Brik81/SYMPHONY_BRIDGE/SYMPHONY_V2/DESIGN/SYMPHONY_V2/report/entries/044_backup-alimentazione-scheda-requisito.tex

\clearpage
\section{Backup alimentazione scheda: requisito e soluzione proposta}

\noindent\textbf{Data:} 10/11/2026 \quad \textbf{Revisione:} non indicata \quad \textbf{Stato:} decisione di Brik81, nessuna modifica hardware eseguita; soluzione \emph{proposta, non ancora approvata}.

\subsection{Componenti, net e fogli coinvolti}
\begin{itemize}[nosep]
  \item Pacco backup esistente: \code{D401} (BAT54WS), \code{R412}, \code{C415}--\code{C424} (CPH3225A), net \code{RTC\_VBAT}, \code{U404} (DS3231MZ, pin 6 VBAT); foglio \code{MCU.kicad\_sch}.
  \item \code{U301} STM32L562, pin 1 VBAT (oggi sul \code{3V3} diretto); \code{U401} FM25V10 (FRAM).
  \item Alimentazione: \code{IC4} TPS2121 (pin SS con \code{C4}, ILIM con \code{R44}), net \code{5V0}, \code{IC3} TPSM863257 (buck \code{3V3}).
  \item Carichi da spegnere al power-fail: \code{IC2} QPA9510 (via \code{Q701}/APC) e radio Si4464.
\end{itemize}

\subsection{Cosa \`e cambiato}
Nessuna modifica eseguita. Stato verificato da netlist il 10/11/2026 e modifiche proposte.

\begin{center}
\begin{tabularx}{\linewidth}{@{}lXX@{}}
\toprule
Voce & Stato attuale & Proposta (non approvata) \\
\midrule
Percorso backup & \code{3V3} $\to$ \code{D401} $\to$ \code{R412} (\SI{1}{\kilo\ohm}) $\to$ \code{RTC\_VBAT} $\to$ \code{C415}--\code{C424} $\to$ solo \code{U404.6} & Pacco CPH3225A mantenuto solo per RTC \\
Pacco CPH3225A & 10 $\times$ \SI{11}{\milli\farad}, \SI{3.3}{\volt}; totale \SI{110}{\milli\farad}, ESR $\approx \SI{16}{\ohm}$ (\SI{160}{\ohm} ciascuno) & invariato \\
Autonomia RTC & \SIrange{4.9}{12.4}{\hour} (calcolata) & invariata \\
Bulk su \code{5V0} & assente & \SIrange{2.2}{3.3}{\milli\farad} elettrolitico/polimerico \SI{10}{\volt}, oppure supercap \SI{0.1}{\farad} \SI{5.5}{\volt} low-ESR per margine \\
Segnale power-fail verso MCU & assente & partitore da \code{5V0} (es. \SI{100}{\kilo\ohm}/\SI{39}{\kilo\ohm}, soglia $\approx \SI{4.3}{\volt}$ con VREFINT \SI{1.2}{\volt}) su ingresso COMP o EXTI di \code{U301}; pin da scegliere \\
Inrush bulk & \code{C4} (SS di \code{IC4}), \code{R44} \SI{33}{\kilo\ohm} (ILIM) & rivedere \code{C4} (formula da datasheet TPS2121) \\
\code{U301} VBAT & \code{3V3} diretto & facoltativo: su \code{RTC\_VBAT} \\
Firmware & --- & all'interrupt: spegnere PA e Si4464, salvare lo stato su FRAM \code{U401} \\
\bottomrule
\end{tabularx}
\end{center}

\subsubsection*{Budget energetico proposto}
Carico durante il salvataggio $\le \SI{50}{\milli\ampere}$ a \SI{3.3}{\volt} ($\approx \SI{0.2}{\watt}$ da \code{5V0}); durata \SI{20}{\milli\second} con margine $\times 3$, quindi \SI{12}{\milli\joule}. Il buck mantiene \code{3V3} finch\'e \code{5V0} $> \SI{3.6}{\volt}$:
\[
E=\tfrac12 C\,(4{,}75^2-3{,}6^2)\approx 4{,}8\,C \;\Rightarrow\; C \ge \SI{2.5}{\milli\farad}.
\]
Il pacco attuale non pu\`o alimentare la scheda: con ESR $\approx \SI{16}{\ohm}$ a \SI{50}{\milli\ampere} cade \SI{0.8}{\volt} e l'energia utile \`e $\approx \SI{0.25}{\joule}$.

\begin{center}
\begin{tikzpicture}[node distance=9mm and 11mm,>=Stealth,
  blk/.style={draw=accent,rounded corners=2pt,align=center,minimum height=8mm,font=\small\sffamily,fill=accent!6}]
  \node[blk] (in) {TPS2121\\ \code{IC4}};
  \node[blk,right=of in] (bus) {Net \code{5V0}\\ + bulk (proposto)};
  \node[blk,right=of bus] (buck) {TPSM863257\\ \code{IC3}};
  \node[blk,right=of buck] (mcu) {\code{3V3}\\ \code{U301},\code{U401}};
  \node[blk,below=of bus,fill=boxwarnbg,draw=boxwarn] (pf) {Partitore\\ power-fail};
  \draw[->] (in)--(bus); \draw[->] (bus)--(buck); \draw[->] (buck)--(mcu);
  \draw[->] (bus)--(pf); \draw[->] (pf)-|(mcu) node[pos=.25,above,font=\scriptsize]{COMP/EXTI};
\end{tikzpicture}
\end{center}

\subsection{Motivazione}
Requisito di Brik81: ``io voglio che alimenti tutta la scheda'' e poi ``la scheda non deve trasmettere se va a saupercap deve salvare lo stato in memoria e basta quidni autonomia poca e non deve trasmettere''.

Approvazione della soluzione proposta: non ancora data.

\subsection{Impatti e criticit\`a}
\begin{critbox}
\textbf{Criticit\`a aperte.}
\begin{itemize}[nosep]
  \item Valori finali del bulk e del partitore non definiti; codici JLCPCB/Mouser non scelti.
  \item Pin COMP/EXTI di \code{U301} da scegliere.
  \item Dropout del TPSM863257 da verificare.
  \item Approvazione di Brik81 sulla soluzione mancante.
\end{itemize}
\end{critbox}
\begin{notebox}
Oggi non esiste alcun segnale power-fail verso l'MCU. Il bulk su \code{5V0} aumenta la corrente di carica all'accensione (inrush): impatto su \code{C4} e ILIM \code{R44}.
\end{notebox}

\subsection{Verifiche da fare}
\begin{itemize}[nosep]
  \item Confermare con Brik81 la soluzione proposta e i valori finali.
  \item Scegliere il pin COMP/EXTI libero di \code{U301}.
  \item Verificare il dropout di \code{IC3} (TPSM863257) sotto \SI{3.6}{\volt} su \code{5V0}.
  \item Rivedere \code{C4} (SS di \code{IC4}) per limitare l'inrush, con \code{R44} \SI{33}{\kilo\ohm}.
  \item Scegliere i codici componente (JLCPCB/Mouser).
  \item Definire la sequenza firmware di salvataggio su \code{U401}.
\end{itemize}
