Brik81/SYMPHONY_BRIDGE/SYMPHONY_V2/DESIGN/SYMPHONY_V2/docs/layout_rf/piazzamento_uhf/tab_mcu_rot.tex

\rowcolor{sbgraybg}\ang{0} (oggi) & 432 & 56 & posizione attuale nel PCB\\
\ang{45} & 423 & 42 & \\
\ang{90} & 385 & 22 & \\
\ang{135} & 338 & 5 & \textcolor{sbgreen}{\textbf{meno incroci}}\\
\ang{180} & 314 & 9 & \textcolor{sborange}{\textbf{più corta}}\\
\ang{225} & 326 & 8 & \\
\ang{270} & 366 & 8 & \\
\ang{315} & 409 & 24 & \\
