Brik81/SYMPHONY_BRIDGE/SYMPHONY_V2/DESIGN/SYMPHONY_V2/docs/layout_rf/piazzamento_uhf/blk_alim_pa2.tex

\begin{tikzpicture}[x=6.50mm,y=6.50mm,font=\sffamily\tiny]
\node[lbl,anchor=east,text=sbgray] at (-0.150,0.000) {3V3};
\draw[tr,line width=2.080mm] (0.000,0.000) -- (1.200,0.000);
\fill[cu] (1.200,-0.475) rectangle (2.050,0.475);
\fill[cu] (2.800,-0.475) rectangle (3.650,0.475);
\draw[bod] (0.825,-0.400) rectangle (3.225,0.400);
\node[lbl,anchor=south,text=black] at (2.425,0.625) {\textbf{R241}\\0};
\draw[tr,line width=2.080mm] (3.650,0.000) -- (4.350,0.000);
\fill[cu] (4.350,-0.275) rectangle (4.950,0.275);
\fill[cu] (4.350,-1.275) rectangle (4.950,-0.725);
\draw[bod] (4.400,-1.000) rectangle (4.900,0.000);
\draw[via] (4.320,-1.655) circle (0.3); \fill[black!70] (4.320,-1.655) circle (0.13);
\draw[via] (4.980,-1.655) circle (0.3); \fill[black!70] (4.980,-1.655) circle (0.13);
\node[lbl,anchor=west,text=black] at (5.070,-0.700) {\textbf{C248} 330p};
\draw[tr,line width=2.080mm] (4.150,0.000) -- (6.600,0.000);
\draw[tr,line width=2.080mm] (6.600,0.000) -- (7.300,0.000);
\fill[cu] (7.300,-0.300) rectangle (7.850,0.300);
\fill[cu] (8.300,-0.300) rectangle (8.850,0.300);
\draw[bod] (7.075,-0.250) rectangle (8.575,0.250);
\node[lbl,anchor=south,text=black] at (8.075,0.450) {\textbf{L241}\\6.8n};
\draw[tr,line width=2.080mm] (8.850,0.000) -- (9.550,0.000);
\node[lbl,anchor=west,text=sbgray] at (9.700,0.000) {VCC2 del PA (pin 5--7)};

\end{tikzpicture}
