Brik81/SYMPHONY_BRIDGE/SYMPHONY_V2/DESIGN/SYMPHONY_V2/docs/layout_rf/piazzamento_uhf/blk_an643.tex

\begin{tikzpicture}[x=6.50mm,y=6.50mm,font=\sffamily\tiny]
\node[lbl,anchor=east,text=sbgray] at (-0.150,0.000) {da C218 (nodo RX\_MATCH)};
\draw[tr,line width=2.080mm] (0.000,0.000) -- (1.200,0.000);
\draw[tr,line width=2.080mm] (1.200,0.000) -- (1.200,1.600);
\draw[tr,line width=2.080mm] (1.200,0.000) -- (1.200,-1.600);
\draw[tr,line width=2.080mm] (1.200,1.600) -- (1.800,1.600);
\fill[cu] (1.800,1.125) rectangle (2.650,2.075);
\fill[cu] (3.400,1.125) rectangle (4.250,2.075);
\draw[bod] (2.225,1.200) rectangle (3.825,2.000);
\node[lbl,anchor=south,text=black] at (3.025,2.175) {\textbf{C219} 2.2p};
\draw[tr,line width=2.080mm] (4.250,1.600) -- (8.600,1.600);
\draw[tr,line width=2.080mm] (1.200,-1.600) -- (1.800,-1.600);
\fill[cu] (1.800,-2.075) rectangle (2.650,-1.125);
\fill[cu] (3.400,-2.075) rectangle (4.250,-1.125);
\draw[bod] (2.225,-2.000) rectangle (3.825,-1.200);
\node[lbl,anchor=north,text=black] at (3.025,-2.175) {\textbf{L205} 56n};
\draw[tr,line width=2.080mm] (4.250,-1.600) -- (8.600,-1.600);
\fill[cu] (4.525,1.175) rectangle (5.475,2.025);
\fill[cu] (4.525,-2.025) rectangle (5.475,-1.175);
\draw[bod] (4.600,-1.700) rectangle (5.400,1.700);
\node[lbl,anchor=west,text=black] at (5.575,0.400) {\textbf{L206} 62n};
\fill[cu] (6.300,-2.125) rectangle (7.700,-1.075);
\fill[cu] (6.300,-4.025) rectangle (7.700,-2.975);
\draw[bod] (6.375,-3.550) rectangle (7.625,-1.550);
\draw[via] (6.670,-4.405) circle (0.3); \fill[black!70] (6.670,-4.405) circle (0.13);
\draw[via] (7.330,-4.405) circle (0.3); \fill[black!70] (7.330,-4.405) circle (0.13);
\node[lbl,anchor=east,text=black] at (6.200,-2.550) {\textbf{C220} 4.7p};
\draw[bod,fill=black!5] (8.6,-2.6) rectangle (11.2,2.6);
\fill[cu] (8.600,1.460) rectangle (9.100,1.740);
\fill[cu] (8.600,-1.740) rectangle (9.100,-1.460);
\node[lbl,anchor=south,text=black] at (9.900,2.650) {\textbf{IC204 Si4464}};
\node[lbl,anchor=west,text=black] at (9.150,1.600) {RXP (2)};
\node[lbl,anchor=west,text=black] at (9.150,-1.600) {RXN (3)};

\end{tikzpicture}
