Brik81/SYMPHONY_BRIDGE/SYMPHONY_V2/DESIGN/SYMPHONY_V2/docs/layout_rf/piazzamento_uhf/blk_antenna.tex

\begin{tikzpicture}[x=6.50mm,y=6.50mm,font=\sffamily\tiny]
\node[lbl,anchor=east,text=sbgray] at (-0.150,0.000) {J201 (pin centrale)};
\draw[tr,line width=2.080mm] (0.000,0.000) -- (2.000,0.000);
\fill[cu] (2.000,-0.475) rectangle (2.850,0.475);
\fill[cu] (3.600,-0.475) rectangle (4.450,0.475);
\draw[bod] (1.625,-0.400) rectangle (4.025,0.400);
\node[lbl,anchor=south,text=black] at (3.225,0.625) {\textbf{C206}\\100p};
\draw[tr,line width=2.080mm] (4.450,0.000) -- (5.150,0.000);
\draw[bod,fill=black!5] (5.150,-1.500) rectangle (8.150,1.500);
\fill[cu] (5.150,-0.140) rectangle (5.650,0.140);
\fill[sborange!45] (5.975,-0.675) rectangle (7.325,0.675);
\draw[via] (6.313,-0.338) circle (0.3); \fill[black!70] (6.313,-0.338) circle (0.13);
\draw[via] (6.313,0.338) circle (0.3); \fill[black!70] (6.313,0.338) circle (0.13);
\draw[via] (6.988,-0.338) circle (0.3); \fill[black!70] (6.988,-0.338) circle (0.13);
\draw[via] (6.988,0.338) circle (0.3); \fill[black!70] (6.988,0.338) circle (0.13);
\node[lbl,anchor=south,text=black] at (6.650,1.650) {\textbf{IC202 switch (porta RFC)}};
\draw[tr,line width=2.080mm] (8.150,0.000) -- (8.850,0.000);

\end{tikzpicture}
