Brik81/SYMPHONY_BRIDGE/SYMPHONY_V2/DESIGN/SYMPHONY_V2/docs/layout_rf/piazzamento_uhf/blk_attenuatore.tex

\begin{tikzpicture}[x=6.50mm,y=6.50mm,font=\sffamily\tiny]
\node[lbl,anchor=east,text=sbgray] at (-0.150,0.000) {da C701 (rete AN648)};
\draw[tr,line width=2.080mm] (0.000,0.000) -- (1.200,0.000);
\fill[cu] (1.200,-0.425) rectangle (2.150,0.425);
\fill[cu] (1.200,-2.025) rectangle (2.150,-1.175);
\draw[bod] (1.275,-1.600) rectangle (2.075,0.000);
\draw[via] (1.345,-2.405) circle (0.3); \fill[black!70] (1.345,-2.405) circle (0.13);
\draw[via] (2.005,-2.405) circle (0.3); \fill[black!70] (2.005,-2.405) circle (0.13);
\node[lbl,anchor=west,text=black] at (2.270,-1.000) {\textbf{R245} 100};
\draw[tr,line width=2.080mm] (1.000,0.000) -- (3.800,0.000);
\draw[tr,line width=2.080mm] (3.800,0.000) -- (4.500,0.000);
\fill[cu] (4.500,-0.475) rectangle (5.350,0.475);
\fill[cu] (6.100,-0.475) rectangle (6.950,0.475);
\draw[bod] (4.125,-0.400) rectangle (6.525,0.400);
\node[lbl,anchor=south,text=black] at (5.725,0.625) {\textbf{R246}\\68};
\draw[tr,line width=2.080mm] (6.950,0.000) -- (7.650,0.000);
\fill[cu] (7.650,-0.275) rectangle (8.250,0.275);
\fill[cu] (7.650,-1.275) rectangle (8.250,-0.725);
\draw[bod] (7.700,-1.000) rectangle (8.200,0.000);
\draw[via] (7.620,-1.655) circle (0.3); \fill[black!70] (7.620,-1.655) circle (0.13);
\draw[via] (8.280,-1.655) circle (0.3); \fill[black!70] (8.280,-1.655) circle (0.13);
\node[lbl,anchor=west,text=black] at (8.370,-0.700) {\textbf{R247} 100};
\fill[cu] (10.400,-0.275) rectangle (11.000,0.275);
\fill[cu] (10.400,0.725) rectangle (11.000,1.275);
\draw[bod] (10.450,0.000) rectangle (10.950,1.000);
\draw[via] (10.370,1.655) circle (0.3); \fill[black!70] (10.370,1.655) circle (0.13);
\draw[via] (11.030,1.655) circle (0.3); \fill[black!70] (11.030,1.655) circle (0.13);
\node[lbl,anchor=west,text=black] at (11.120,0.700) {\textbf{R248} 180};
\draw[tr,line width=2.080mm] (7.450,0.000) -- (12.650,0.000);
\draw[tr,line width=2.080mm] (12.650,0.000) -- (13.350,0.000);
\fill[cu] (13.350,-0.475) rectangle (14.200,0.475);
\fill[cu] (14.950,-0.475) rectangle (15.800,0.475);
\draw[bod] (12.975,-0.400) rectangle (15.375,0.400);
\node[lbl,anchor=south,text=black] at (14.575,0.625) {\textbf{C255}\\56p};
\draw[tr,line width=2.080mm] (15.800,0.000) -- (16.500,0.000);
\node[lbl,anchor=west,text=sbgray] at (16.650,0.000) {RF IN del PA (pin 3)};

\end{tikzpicture}
