Brik81/SYMPHONY_BRIDGE/SYMPHONY_V2/DESIGN/SYMPHONY_V2/docs/layout_rf/piazzamento_uhf/blk_es_ind_no.tex

\begin{tikzpicture}[x=6.50mm,y=6.50mm,font=\sffamily\tiny]
\useasboundingbox (-1.8,-4.3) rectangle (9.5,1.4);
\draw[tr,line width=2.080mm] (0.000,0.000) -- (1.400,0.000);
\fill[cu] (1.400,-0.475) rectangle (2.250,0.475);
\fill[cu] (3.000,-0.475) rectangle (3.850,0.475);
\draw[bod] (1.825,-0.400) rectangle (3.425,0.400);
\draw[sbgray,->] (1.6,0.9) -- (3.4,0.9);
\draw[tr,line width=2.080mm] (3.850,0.000) -- (4.450,0.000);
\fill[cu] (4.450,-0.475) rectangle (5.300,0.475);
\fill[cu] (6.050,-0.475) rectangle (6.900,0.475);
\draw[bod] (4.875,-0.400) rectangle (6.475,0.400);
\draw[sbgray,->] (4.65,0.9) -- (6.45,0.9);
\draw[tr,line width=2.080mm] (6.900,0.000) -- (8.000,0.000);
\node[lbl,anchor=north,text=sbred] at (4.000,-0.900) {in fila e vicine: i campi si sommano};
\node[font=\sffamily\scriptsize\bfseries,text=sbred,anchor=north west] at (-1.8,1.4) {\ding{55} sbagliato};

\end{tikzpicture}
