Brik81/SYMPHONY_BRIDGE/SYMPHONY_V2/DESIGN/SYMPHONY_V2/docs/layout_rf/piazzamento_uhf/blk_es_ind_si.tex

\begin{tikzpicture}[x=6.50mm,y=6.50mm,font=\sffamily\tiny]
\useasboundingbox (-1.8,-4.3) rectangle (9.5,1.4);
\draw[tr,line width=2.080mm] (0.000,0.000) -- (1.400,0.000);
\fill[cu] (1.400,-0.475) rectangle (2.250,0.475);
\fill[cu] (3.000,-0.475) rectangle (3.850,0.475);
\draw[bod] (1.825,-0.400) rectangle (3.425,0.400);
\draw[sbgray,->] (1.6,0.9) -- (3.4,0.9);
\draw[tr,line width=2.080mm] (3.850,0.000) -- (5.050,0.000);
\draw[tr,line width=2.080mm] (5.050,0.000) -- (5.050,-0.600);
\fill[cu] (4.575,-1.450) rectangle (5.525,-0.600);
\fill[cu] (4.575,-3.050) rectangle (5.525,-2.200);
\draw[bod] (4.650,-2.625) rectangle (5.450,-1.025);
\draw[sbgray,->] (5.85,-0.5) -- (5.85,-2.3);
\draw[tr,line width=2.080mm] (5.050,-3.050) -- (5.050,-3.600);
\node[lbl,anchor=west,text=sbgreen] at (6.150,-1.400) {girata di 90 gradi:\\i campi non si sommano};
\node[font=\sffamily\scriptsize\bfseries,text=sbgreen,anchor=north west] at (-1.8,1.4) {\ding{51} giusto};

\end{tikzpicture}
