Brik81/SYMPHONY_BRIDGE/SYMPHONY_V2/DESIGN/SYMPHONY_V2/docs/layout_rf/piazzamento_uhf/blk_es_stub_no.tex

\begin{tikzpicture}[x=6.50mm,y=6.50mm,font=\sffamily\tiny]
\useasboundingbox (-1.8,-4.3) rectangle (9.5,1.4);
\draw[tr,line width=2.080mm] (0.000,0.000) -- (6.000,0.000);
\draw[tr,line width=1.625mm] (3.000,0.000) -- (3.000,-1.600);
\fill[cu] (2.700,-2.150) rectangle (3.300,-1.600);
\fill[cu] (2.700,-3.150) rectangle (3.300,-2.600);
\draw[bod] (2.750,-3.075) rectangle (3.250,-1.675);
\draw[via] (3.000,-3.530) circle (0.3); \fill[black!70] (3.000,-3.530) circle (0.13);
\node[lbl,anchor=west,text=sbred] at (3.400,-0.800) {stub};
\node[font=\sffamily\scriptsize\bfseries,text=sbred,anchor=north west] at (-1.8,1.4) {\ding{55} sbagliato};

\end{tikzpicture}
