Brik81/SYMPHONY_BRIDGE/SYMPHONY_V2/DESIGN/SYMPHONY_V2/docs/layout_rf/piazzamento_uhf/blk_es_stub_si.tex

\begin{tikzpicture}[x=6.50mm,y=6.50mm,font=\sffamily\tiny]
\useasboundingbox (-1.8,-4.3) rectangle (9.5,1.4);
\draw[tr,line width=2.080mm] (0.000,0.000) -- (6.000,0.000);
\fill[cu] (2.700,-0.275) rectangle (3.300,0.275);
\fill[cu] (2.700,-1.275) rectangle (3.300,-0.725);
\draw[bod] (2.750,-1.200) rectangle (3.250,0.200);
\draw[via] (2.670,-1.655) circle (0.3); \fill[black!70] (2.670,-1.655) circle (0.13);
\draw[via] (3.330,-1.655) circle (0.3); \fill[black!70] (3.330,-1.655) circle (0.13);
\node[lbl,anchor=west,text=sbgreen] at (3.500,-0.500) {pad sulla pista};
\node[font=\sffamily\scriptsize\bfseries,text=sbgreen,anchor=north west] at (-1.8,1.4) {\ding{51} giusto};

\end{tikzpicture}
