Brik81/SYMPHONY_BRIDGE/SYMPHONY_V2/DESIGN/SYMPHONY_V2/docs/layout_rf/piazzamento_uhf/blk_es_via_no.tex

\begin{tikzpicture}[x=6.50mm,y=6.50mm,font=\sffamily\tiny]
\useasboundingbox (-1.8,-4.3) rectangle (9.5,1.4);
\draw[tr,line width=2.080mm] (0.000,0.000) -- (6.000,0.000);
\fill[cu] (2.700,-0.275) rectangle (3.300,0.275);
\fill[cu] (2.700,-1.275) rectangle (3.300,-0.725);
\draw[bod] (2.750,-1.200) rectangle (3.250,0.200);
\draw[tr,line width=1.300mm] (3.000,-1.000) -- (3.000,-3.200);
\draw[via] (3.000,-3.500) circle (0.3); \fill[black!70] (3.000,-3.500) circle (0.13);
\node[lbl,anchor=west,text=sbred] at (3.400,-2.400) {via lontana};
\node[font=\sffamily\scriptsize\bfseries,text=sbred,anchor=north west] at (-1.8,1.4) {\ding{55} sbagliato};

\end{tikzpicture}
