Brik81/SYMPHONY_BRIDGE/SYMPHONY_V2/DESIGN/SYMPHONY_V2/docs/layout_rf/piazzamento_uhf/blk_filtro_rx.tex

\begin{tikzpicture}[x=6.50mm,y=6.50mm,font=\sffamily\tiny]
\node[lbl,anchor=east,text=sbgray] at (-0.150,0.000) {RF1 dello switch};
\draw[tr,line width=2.080mm] (0.000,0.000) -- (1.400,0.000);
\fill[cu] (1.400,-0.475) rectangle (2.250,0.475);
\fill[cu] (3.000,-0.475) rectangle (3.850,0.475);
\draw[bod] (1.025,-0.400) rectangle (3.425,0.400);
\node[lbl,anchor=south,text=black] at (2.625,0.625) {\textbf{C207}\\100p};
\draw[tr,line width=2.080mm] (3.850,0.000) -- (4.550,0.000);
\fill[cu] (4.550,-0.525) rectangle (5.950,0.525);
\fill[cu] (4.550,-2.425) rectangle (5.950,-1.375);
\draw[bod] (4.625,-1.950) rectangle (5.875,0.050);
\draw[via] (4.920,-2.805) circle (0.3); \fill[black!70] (4.920,-2.805) circle (0.13);
\draw[via] (5.580,-2.805) circle (0.3); \fill[black!70] (5.580,-2.805) circle (0.13);
\node[lbl,anchor=west,text=black] at (6.070,-1.150) {\textbf{C210} 6.8p};
\draw[tr,line width=2.080mm] (4.350,0.000) -- (7.600,0.000);
\draw[tr,line width=2.080mm] (7.600,0.000) -- (8.300,0.000);
\fill[cu] (8.300,-0.700) rectangle (9.350,0.700);
\fill[cu] (10.200,-0.700) rectangle (11.250,0.700);
\draw[bod] (7.825,-0.625) rectangle (10.775,0.625);
\node[lbl,anchor=south,text=black] at (9.775,0.850) {\textbf{L201}\\22n};
\draw[tr,line width=2.080mm] (11.250,0.000) -- (11.950,0.000);
\fill[cu] (11.950,-0.525) rectangle (13.350,0.525);
\fill[cu] (11.950,-2.425) rectangle (13.350,-1.375);
\draw[bod] (12.025,-1.950) rectangle (13.275,0.050);
\draw[via] (12.320,-2.805) circle (0.3); \fill[black!70] (12.320,-2.805) circle (0.13);
\draw[via] (12.980,-2.805) circle (0.3); \fill[black!70] (12.980,-2.805) circle (0.13);
\node[lbl,anchor=west,text=black] at (13.470,-1.150) {\textbf{C209} 6.8p};
\draw[tr,line width=2.080mm] (11.750,0.000) -- (15.000,0.000);
\draw[tr,line width=2.080mm] (15.000,0.000) -- (15.700,0.000);
\fill[cu] (15.700,-0.475) rectangle (16.550,0.475);
\fill[cu] (17.300,-0.475) rectangle (18.150,0.475);
\draw[bod] (15.325,-0.400) rectangle (17.725,0.400);
\node[lbl,anchor=south,text=black] at (16.925,0.625) {\textbf{C212}\\100p};
\draw[tr,line width=2.080mm] (18.150,0.000) -- (18.850,0.000);
\node[lbl,anchor=west,text=sbgray] at (19.000,0.000) {RF IN dell'LNA (pin 2)};

\end{tikzpicture}
