Brik81/SYMPHONY_BRIDGE/SYMPHONY_V2/DESIGN/SYMPHONY_V2/docs/layout_rf/piazzamento_uhf/blk_filtro_tx.tex

\begin{tikzpicture}[x=6.50mm,y=6.50mm,font=\sffamily\tiny]
\node[lbl,anchor=east,text=sbgray] at (-0.150,0.000) {dalla rete d'uscita del PA};
\draw[tr,line width=2.080mm] (0.000,0.000) -- (1.400,0.000);
\fill[cu] (1.400,-0.475) rectangle (2.250,0.475);
\fill[cu] (3.000,-0.475) rectangle (3.850,0.475);
\draw[bod] (1.025,-0.400) rectangle (3.425,0.400);
\node[lbl,anchor=south,text=black] at (2.625,0.625) {\textbf{C230}\\56p};
\draw[tr,line width=2.080mm] (3.850,0.000) -- (4.550,0.000);
\draw[bod,fill=black!5] (4.550,-1.250) rectangle (7.750,1.250);
\fill[cu] (4.550,-0.140) rectangle (5.050,0.140);
\fill[cu] (7.250,-0.140) rectangle (7.750,0.140);
\fill[cu] (5.200,0.800) rectangle (5.500,1.300);
\draw[via] (5.350,1.750) circle (0.3); \fill[black!70] (5.350,1.750) circle (0.13);
\fill[cu] (5.200,-1.300) rectangle (5.500,-0.800);
\draw[via] (5.350,-1.750) circle (0.3); \fill[black!70] (5.350,-1.750) circle (0.13);
\fill[cu] (6.000,0.800) rectangle (6.300,1.300);
\draw[via] (6.150,1.750) circle (0.3); \fill[black!70] (6.150,1.750) circle (0.13);
\fill[cu] (6.000,-1.300) rectangle (6.300,-0.800);
\draw[via] (6.150,-1.750) circle (0.3); \fill[black!70] (6.150,-1.750) circle (0.13);
\fill[cu] (6.800,0.800) rectangle (7.100,1.300);
\draw[via] (6.950,1.750) circle (0.3); \fill[black!70] (6.950,1.750) circle (0.13);
\fill[cu] (6.800,-1.300) rectangle (7.100,-0.800);
\draw[via] (6.950,-1.750) circle (0.3); \fill[black!70] (6.950,-1.750) circle (0.13);
\node[lbl,anchor=south,text=black] at (6.150,2.150) {\textbf{FL201 LFCG-490+}};
\draw[tr,line width=2.080mm] (7.750,0.000) -- (8.450,0.000);
\fill[cu] (8.450,-0.475) rectangle (9.300,0.475);
\fill[cu] (10.050,-0.475) rectangle (10.900,0.475);
\draw[bod] (8.075,-0.400) rectangle (10.475,0.400);
\node[lbl,anchor=south,text=black] at (9.675,0.625) {\textbf{C208}\\100p};
\draw[tr,line width=2.080mm] (10.900,0.000) -- (11.600,0.000);
\node[lbl,anchor=west,text=sbgray] at (11.750,0.000) {RF2 dello switch};

\end{tikzpicture}
