Brik81/SYMPHONY_BRIDGE/SYMPHONY_V2/DESIGN/SYMPHONY_V2/docs/layout_rf/piazzamento_uhf/blk_lna.tex

\begin{tikzpicture}[x=6.50mm,y=6.50mm,font=\sffamily\tiny]
\node[lbl,anchor=east,text=sbgray] at (-0.150,0.000) {da C212};
\draw[tr,line width=2.080mm] (0.000,0.000) -- (1.200,0.000);
\draw[bod,fill=black!5] (1.200,-1.300) rectangle (3.800,1.300);
\fill[cu] (1.200,-0.140) rectangle (1.700,0.140);
\fill[cu] (3.300,-0.140) rectangle (3.800,0.140);
\fill[sborange!45] (1.915,-0.585) rectangle (3.085,0.585);
\draw[via] (2.208,-0.293) circle (0.3); \fill[black!70] (2.208,-0.293) circle (0.13);
\draw[via] (2.208,0.293) circle (0.3); \fill[black!70] (2.208,0.293) circle (0.13);
\draw[via] (2.793,-0.293) circle (0.3); \fill[black!70] (2.793,-0.293) circle (0.13);
\draw[via] (2.793,0.293) circle (0.3); \fill[black!70] (2.793,0.293) circle (0.13);
\node[lbl,anchor=south,text=black] at (2.500,1.450) {\textbf{Q201 LNA}};
\draw[tr,line width=2.080mm] (3.800,0.000) -- (4.500,0.000);
\draw[tr,line width=2.080mm] (4.300,0.000) -- (5.300,0.000);
\fill[cu] (4.500,-0.275) rectangle (5.100,0.275);
\fill[cu] (4.500,0.725) rectangle (5.100,1.275);
\draw[bod] (4.550,0.000) rectangle (5.050,1.000);
\node[lbl,anchor=west,text=black] at (5.220,0.500) {\textbf{L202} 120n};
\draw[tr,line width=1.950mm] (4.800,1.000) -- (4.800,2.175);
\fill[cu] (5.400,1.900) rectangle (6.000,2.450);
\fill[cu] (5.400,2.900) rectangle (6.000,3.450);
\draw[bod] (5.450,2.175) rectangle (5.950,3.175);
\draw[via] (5.370,3.830) circle (0.3); \fill[black!70] (5.370,3.830) circle (0.13);
\draw[via] (6.030,3.830) circle (0.3); \fill[black!70] (6.030,3.830) circle (0.13);
\node[lbl,anchor=west,text=black] at (6.100,2.675) {\textbf{C214} 100p};
\fill[cu] (7.900,1.900) rectangle (8.500,2.450);
\fill[cu] (7.900,2.900) rectangle (8.500,3.450);
\draw[bod] (7.950,2.175) rectangle (8.450,3.175);
\draw[via] (7.870,3.830) circle (0.3); \fill[black!70] (7.870,3.830) circle (0.13);
\draw[via] (8.530,3.830) circle (0.3); \fill[black!70] (8.530,3.830) circle (0.13);
\node[lbl,anchor=west,text=black] at (8.600,2.675) {\textbf{C215} 1u};
\draw[tr,line width=1.950mm] (4.800,2.175) -- (10.400,2.175);
\draw[via] (10.700,2.175) circle (0.3); \fill[black!70] (10.700,2.175) circle (0.13);
\node[lbl,anchor=west,text=sbred] at (11.100,2.175) {via al piano 3V3 (In5)};
\draw[tr,line width=2.080mm] (4.800,0.000) -- (7.800,0.000);
\fill[cu] (7.800,-0.475) rectangle (8.650,0.475);
\fill[cu] (9.400,-0.475) rectangle (10.250,0.475);
\draw[bod] (7.425,-0.400) rectangle (9.825,0.400);
\node[lbl,anchor=south,text=black] at (9.025,0.625) {\textbf{C213}\\100p};
\draw[tr,line width=2.080mm] (10.250,0.000) -- (10.950,0.000);
\node[lbl,anchor=west,text=sbgray] at (11.100,0.000) {filtro dopo l'LNA};

\end{tikzpicture}
