Brik81/SYMPHONY_BRIDGE/SYMPHONY_V2/DESIGN/SYMPHONY_V2/docs/layout_rf/piazzamento_uhf/blk_post_lna.tex

\begin{tikzpicture}[x=6.50mm,y=6.50mm,font=\sffamily\tiny]
\node[lbl,anchor=east,text=sbgray] at (-0.150,0.000) {da C213};
\draw[tr,line width=2.080mm] (0.000,0.000) -- (1.200,0.000);
\fill[cu] (1.200,-0.425) rectangle (2.150,0.425);
\fill[cu] (1.200,-2.025) rectangle (2.150,-1.175);
\draw[bod] (1.275,-1.600) rectangle (2.075,0.000);
\draw[via] (1.345,-2.405) circle (0.3); \fill[black!70] (1.345,-2.405) circle (0.13);
\draw[via] (2.005,-2.405) circle (0.3); \fill[black!70] (2.005,-2.405) circle (0.13);
\node[lbl,anchor=west,text=black] at (2.270,-1.000) {\textbf{C217} 5.6p};
\draw[tr,line width=2.080mm] (1.000,0.000) -- (3.800,0.000);
\draw[tr,line width=2.080mm] (3.800,0.000) -- (4.500,0.000);
\fill[cu] (4.500,-0.700) rectangle (5.550,0.700);
\fill[cu] (6.400,-0.700) rectangle (7.450,0.700);
\draw[bod] (4.025,-0.625) rectangle (6.975,0.625);
\node[lbl,anchor=south,text=black] at (5.975,0.850) {\textbf{L203}\\22n};
\draw[tr,line width=2.080mm] (7.450,0.000) -- (8.150,0.000);
\fill[cu] (8.150,-0.525) rectangle (9.550,0.525);
\fill[cu] (8.150,-2.425) rectangle (9.550,-1.375);
\draw[bod] (8.225,-1.950) rectangle (9.475,0.050);
\draw[via] (8.520,-2.805) circle (0.3); \fill[black!70] (8.520,-2.805) circle (0.13);
\draw[via] (9.180,-2.805) circle (0.3); \fill[black!70] (9.180,-2.805) circle (0.13);
\node[lbl,anchor=west,text=black] at (9.670,-1.150) {\textbf{C216} 8.2p};
\draw[tr,line width=2.080mm] (7.950,0.000) -- (11.200,0.000);
\draw[tr,line width=2.080mm] (11.200,0.000) -- (11.900,0.000);
\fill[cu] (11.900,-0.700) rectangle (12.950,0.700);
\fill[cu] (13.800,-0.700) rectangle (14.850,0.700);
\draw[bod] (11.425,-0.625) rectangle (14.375,0.625);
\node[lbl,anchor=south,text=black] at (13.375,0.850) {\textbf{L204}\\22n};
\draw[tr,line width=2.080mm] (14.850,0.000) -- (15.550,0.000);
\fill[cu] (15.550,-0.425) rectangle (16.500,0.425);
\fill[cu] (15.550,-2.025) rectangle (16.500,-1.175);
\draw[bod] (15.625,-1.600) rectangle (16.425,0.000);
\draw[via] (15.695,-2.405) circle (0.3); \fill[black!70] (15.695,-2.405) circle (0.13);
\draw[via] (16.355,-2.405) circle (0.3); \fill[black!70] (16.355,-2.405) circle (0.13);
\node[lbl,anchor=west,text=black] at (16.620,-1.000) {\textbf{C218} 5.6p};
\draw[tr,line width=2.080mm] (15.350,0.000) -- (18.150,0.000);
\draw[tr,line width=2.080mm] (18.150,0.000) -- (18.850,0.000);
\node[lbl,anchor=west,text=sbgray] at (19.000,0.000) {rete AN643};

\end{tikzpicture}
