Brik81/SYMPHONY_BRIDGE/SYMPHONY_V2/DESIGN/SYMPHONY_V2/docs/layout_rf/piazzamento_uhf/blk_tcxo.tex

\begin{tikzpicture}[x=6.50mm,y=6.50mm,font=\sffamily\tiny]
\node[lbl,anchor=east,text=sbgray] at (-0.150,0.000) {Y201 TCXO (uscita, pin 3)};
\draw[tr,line width=2.080mm] (0.000,0.000) -- (1.200,0.000);
\fill[cu] (1.200,-0.300) rectangle (1.750,0.300);
\fill[cu] (2.200,-0.300) rectangle (2.750,0.300);
\draw[bod] (0.975,-0.250) rectangle (2.475,0.250);
\node[lbl,anchor=south,text=black] at (1.975,0.450) {\textbf{C204}\\10n};
\draw[tr,line width=2.080mm] (2.750,0.000) -- (3.450,0.000);
\fill[cu] (3.450,-0.300) rectangle (4.000,0.300);
\fill[cu] (4.450,-0.300) rectangle (5.000,0.300);
\draw[bod] (3.225,-0.250) rectangle (4.725,0.250);
\node[lbl,anchor=south,text=black] at (4.225,0.450) {\textbf{R201}\\33};
\draw[tr,line width=2.080mm] (5.000,0.000) -- (5.700,0.000);
\node[lbl,anchor=west,text=sbgray] at (5.850,0.000) {XIN del Si4464 (pin 17), TP701 sul percorso};

\end{tikzpicture}
