Brik81/SYMPHONY_BRIDGE/SYMPHONY_V2/DESIGN/SYMPHONY_V2/docs/layout_rf/piazzamento_uhf/blk_uscita_pa.tex

\begin{tikzpicture}[x=6.50mm,y=6.50mm,font=\sffamily\tiny]
\node[lbl,anchor=east,text=sbgray] at (-0.150,0.000) {uscita del PA (pin 9--12)};
\draw[tr,line width=2.080mm] (0.000,0.000) -- (1.400,0.000);
\fill[cu] (1.400,-0.425) rectangle (2.350,0.425);
\fill[cu] (1.400,-2.025) rectangle (2.350,-1.175);
\draw[bod] (1.475,-1.600) rectangle (2.275,0.000);
\draw[via] (1.545,-2.405) circle (0.3); \fill[black!70] (1.545,-2.405) circle (0.13);
\draw[via] (2.205,-2.405) circle (0.3); \fill[black!70] (2.205,-2.405) circle (0.13);
\node[lbl,anchor=west,text=black] at (2.470,-1.000) {\textbf{C260} 27p};
\draw[tr,line width=2.080mm] (1.200,0.000) -- (4.000,0.000);
\draw[tr,line width=2.080mm] (4.000,0.000) -- (4.700,0.000);
\draw[tr,line width=2.080mm] (4.500,0.000) -- (7.500,0.000);
\fill[cu] (4.900,-0.450) rectangle (7.100,0.450);
\fill[cu] (4.900,1.550) rectangle (7.100,2.450);
\draw[bod] (4.700,-0.300) rectangle (7.300,2.300);
\node[lbl,anchor=west,text=black] at (7.420,1.000) {\textbf{L242} 1u};
\draw[tr,line width=1.950mm] (6.000,2.000) -- (6.000,3.350);
\fill[cu] (6.600,3.075) rectangle (7.200,3.625);
\fill[cu] (6.600,4.075) rectangle (7.200,4.625);
\draw[bod] (6.650,3.350) rectangle (7.150,4.350);
\draw[via] (6.570,5.005) circle (0.3); \fill[black!70] (6.570,5.005) circle (0.13);
\draw[via] (7.230,5.005) circle (0.3); \fill[black!70] (7.230,5.005) circle (0.13);
\node[lbl,anchor=west,text=black] at (7.300,3.850) {\textbf{C258} 47p};
\fill[cu] (9.100,3.075) rectangle (9.700,3.625);
\fill[cu] (9.100,4.075) rectangle (9.700,4.625);
\draw[bod] (9.150,3.350) rectangle (9.650,4.350);
\draw[via] (9.070,5.005) circle (0.3); \fill[black!70] (9.070,5.005) circle (0.13);
\draw[via] (9.730,5.005) circle (0.3); \fill[black!70] (9.730,5.005) circle (0.13);
\node[lbl,anchor=west,text=black] at (9.800,3.850) {\textbf{C257} 1n};
\fill[cu] (11.600,2.825) rectangle (13.000,3.875);
\fill[cu] (11.600,4.725) rectangle (13.000,5.775);
\draw[bod] (11.675,3.300) rectangle (12.925,5.300);
\draw[via] (11.970,6.155) circle (0.3); \fill[black!70] (11.970,6.155) circle (0.13);
\draw[via] (12.630,6.155) circle (0.3); \fill[black!70] (12.630,6.155) circle (0.13);
\node[lbl,anchor=west,text=black] at (13.100,4.300) {\textbf{C256} 10u};
\draw[tr,line width=1.950mm] (6.000,3.350) -- (14.900,3.350);
\draw[via] (15.200,3.350) circle (0.3); \fill[black!70] (15.200,3.350) circle (0.13);
\node[lbl,anchor=west,text=sbred] at (15.600,3.350) {via al piano 3V3 (In5)};
\draw[tr,line width=2.080mm] (6.000,0.000) -- (10.000,0.000);
\fill[cu] (10.000,-0.300) rectangle (10.550,0.300);
\fill[cu] (11.000,-0.300) rectangle (11.550,0.300);
\draw[bod] (9.775,-0.250) rectangle (11.275,0.250);
\node[lbl,anchor=south,text=black] at (10.775,0.450) {\textbf{L243}\\2.7n};
\draw[tr,line width=2.080mm] (11.550,0.000) -- (12.250,0.000);
\fill[cu] (12.250,-0.275) rectangle (12.850,0.275);
\fill[cu] (12.250,-1.275) rectangle (12.850,-0.725);
\draw[bod] (12.300,-1.000) rectangle (12.800,0.000);
\draw[via] (12.220,-1.655) circle (0.3); \fill[black!70] (12.220,-1.655) circle (0.13);
\draw[via] (12.880,-1.655) circle (0.3); \fill[black!70] (12.880,-1.655) circle (0.13);
\node[lbl,anchor=west,text=black] at (12.970,-0.700) {\textbf{C261} 22p};
\fill[cu] (15.000,-0.275) rectangle (15.600,0.275);
\fill[cu] (15.000,0.725) rectangle (15.600,1.275);
\draw[bod] (15.050,0.000) rectangle (15.550,1.000);
\draw[via] (14.970,1.655) circle (0.3); \fill[black!70] (14.970,1.655) circle (0.13);
\draw[via] (15.630,1.655) circle (0.3); \fill[black!70] (15.630,1.655) circle (0.13);
\node[lbl,anchor=west,text=black] at (15.720,0.700) {\textbf{C262} 2p};
\draw[tr,line width=2.080mm] (12.050,0.000) -- (17.250,0.000);
\draw[tr,line width=2.080mm] (17.250,0.000) -- (17.950,0.000);
\fill[cu] (17.950,-0.475) rectangle (18.800,0.475);
\fill[cu] (19.550,-0.475) rectangle (20.400,0.475);
\draw[bod] (17.575,-0.400) rectangle (19.975,0.400);
\node[lbl,anchor=south,text=black] at (19.175,0.625) {\textbf{C230}\\56p};
\draw[tr,line width=2.080mm] (20.400,0.000) -- (21.100,0.000);
\node[lbl,anchor=west,text=sbgray] at (21.250,0.000) {a FL201};

\end{tikzpicture}
