Brik81/SYMPHONY_BRIDGE/SYMPHONY_V2/DESIGN/SYMPHONY_V2/report_src/bak_report_pre_layout/entries/001_parte-b-analisi-e-modifiche.tex

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

\subsection[0. Sommario]{0. Sommario}

{\footnotesize\arrayrulecolor{rulec}\setlength{\tabcolsep}{4pt}\renewcommand{\arraystretch}{1.1}
\begin{longtable}{>{\raggedright\arraybackslash}p{\cw{0.0392}{32pt}{0pt}}>{\raggedright\arraybackslash}p{\cw{0.3211}{32pt}{0pt}}>{\raggedright\arraybackslash}p{\cw{0.0644}{32pt}{0pt}}>{\raggedright\arraybackslash}p{\cw{0.5753}{32pt}{0pt}}}
\toprule
\textbf{\#} & \textbf{Argomento} & \textbf{Stato} & \textbf{Esito} \\
\midrule
\endhead
\bottomrule\endfoot
1 & Alimentazione (DNP esclusi) & \tg{tagdone}{modificato v1.1} & Rail 3V3 OK. Partitori del TPS2121 corretti in v1.1 (R29 = 22k, R31 = 10k), §1.3 \\\midrule[0.15pt]
2 & TCXO su XIN del Si4464 & \tg{tagdone}{modificato v1.0} & TCXO spostato da XOUT a XIN, XOUT con no-connect \\\midrule[0.15pt]
3 & Match TX Si4464 (choke DC + rete) & \tg{tagdone}{modificato v1.0} & Rete class-E da AN648 Tab. 2 @434 MHz \\\midrule[0.15pt]
4 & HMC349 alimentato a 5V0 & \tg{tagdone}{modificato v1.1} & VDD dell'HMC349 ora su 5V0; vincoli firmware in §4 \\\midrule[0.15pt]
5 & APC del PA /\allowbreak{} gate di Q701 & \tg{tagdone}{modificato v1.0} & R703 = 0 Ω, R242 = 33 Ω, R243 = 240 Ω \\\midrule[0.15pt]
6 & Simbolo di Q701 & \tg{tagdone}{modificato v1.1} & Simbolo P-MOS Q\_\allowbreak{}PMOS\_\allowbreak{}GSD, stesso pinout \\\midrule[0.15pt]
M & Modifiche minori & \tg{tagdone}{modificato v1.0} & Tutte tranne SDN del Si4464 (da discutere) \\\midrule[0.15pt]
9 & Passivi di IC2 & \tg{tagdone}{modificato v1.2} & Quasi tutti necessari (rete Qorvo). Rimossi R244 e C253; R240/\allowbreak{}R241 tenuti per il prototipo \\\midrule[0.15pt]
10 & Verifica: codici JLCPCB, pad, tensione ≥ 5×, Murata & \tg{tagdone}{modificato v1.3} & Corretti in rev. 1.3; restano aperti L242 e J201. Situazione v1.1: codici errati su 5 posizioni (C204 è un induttore, C230 è 33 pF, C206/\allowbreak{}C207/\allowbreak{}C208 hanno pad sbagliato), 5 posizioni sotto la regola 5×, 4 non Murata, 38 posizioni senza codice. Proposte in §10 \\\midrule[0.15pt]
13 & Verifica completa, foglio per foglio (rev. 1.4) & \tg{tagcrit}{errori trovati v1.4} & 3 errori critici (IC501 a specchio, VDD12 su 3V3, C1/\allowbreak{}C2 10 nF), LNA che non si spegne, foglio SENSORS incompleto. Proposte P8–P17 \\\midrule[0.15pt]
14 & Conferma finale dimensionamento e collegamenti & \tg{tagwarn}{parziale} & Confermati radice, POWER, MOUNTING\_\allowbreak{}HOLES; UHF con riserva; IF, MCU e SENSORS non confermati \\
\end{longtable}}

\subsection[1. Verifica alimentazione (DNP esclusi)]{1. Verifica alimentazione (DNP esclusi)}

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

\subsubsection[1.1 Rail 3V3 – OK]{1.1 Rail 3V3 – OK}

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

\subsubsection[1.2 Attenzioni (non sono errori)]{1.2 Attenzioni (non sono errori)}

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

\subsection[3. Match TX del Si4464]{3. Match TX del Si4464 \tg{tagdone}{modificato v1.0}}

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

{\footnotesize\arrayrulecolor{rulec}\setlength{\tabcolsep}{4pt}\renewcommand{\arraystretch}{1.1}
\begin{longtable}{>{\raggedright\arraybackslash}p{\cw{0.2119}{40pt}{0pt}}>{\raggedright\arraybackslash}p{\cw{0.1064}{40pt}{0pt}}>{\raggedright\arraybackslash}p{\cw{0.2432}{40pt}{0pt}}>{\raggedright\arraybackslash}p{\cw{0.1537}{40pt}{0pt}}>{\raggedright\arraybackslash}p{\cw{0.2847}{40pt}{0pt}}}
\toprule
\textbf{Elemento AN648} & \textbf{Valore AN648} & \textbf{Ref. schema} & \textbf{Prima} & \textbf{Dopo} \\
\midrule
\endhead
\bottomrule\endfoot
Lchoke (VDD → pin TX) & 220 nH & L703 (riattivato, tolto DNP e spostato) & 68 n, DNP, scollegato & \textbf{220 n} 0805 wire-wound (es. Coilcraft 0805CS-221XJ, 400 mA, SRF 820 MHz) \\\midrule[0.15pt]
C0 (serie) & 9.1 pF & C702 & 2 p & \textbf{9.1 p} C0G \\\midrule[0.15pt]
L0 (serie) & 33 nH & L702 & 3.2 n & \textbf{33 n} wire-wound \\\midrule[0.15pt]
CM (parallelo) & 15 pF & C704 (ex L701, cambiato in condensatore) & L 3.2 n & \textbf{15 p} C0G 0402 \\\midrule[0.15pt]
DC block verso il pad & – & C701 & 33 p & \textbf{100 p} (−j3.7 Ω, trasparente) \\
\end{longtable}}

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

{\small\arrayrulecolor{rulec}\setlength{\tabcolsep}{4pt}\renewcommand{\arraystretch}{1.1}
\begin{longtable}{>{\raggedright\arraybackslash}p{\cw{0.5827}{24pt}{0pt}}>{\raggedright\arraybackslash}p{\cw{0.1836}{24pt}{0pt}}>{\raggedright\arraybackslash}p{\cw{0.2337}{24pt}{0pt}}}
\toprule
\textbf{Parametro (datasheet rev F)} & \textbf{VDD = 3 V} & \textbf{VDD = 5 V} \\
\midrule
\endhead
\bottomrule\endfoot
Campo VDD consentito & \multicolumn{2}{>{\raggedright\arraybackslash}p{\cw{0.4173}{24pt}{8pt}}}{3 – 5 V (massimo assoluto 7 V)} \\\midrule[0.15pt]
Ingressi CTRL/\allowbreak{}EN: V\textsubscript{INH} /\allowbreak{} V\textsubscript{INL} & \multicolumn{2}{>{\raggedright\arraybackslash}p{\cw{0.4173}{24pt}{8pt}}}{V\textsubscript{INH} 2 V min (fino a VDD), V\textsubscript{INL} 0.8 V max: il GPIO a 3.3 V e l'uscita del 74AUP vanno bene anche con VDD = 5 V} \\\midrule[0.15pt]
P0.1dB & 25 dBm & 31 dBm \\\midrule[0.15pt]
P1dB & 28 dBm & 34 dBm tip. (30 min) \\\midrule[0.15pt]
Massimo assoluto RF, percorso attivo, T\textsubscript{case} 85 °C & 31.5 dBm & 33.5 dBm \\\midrule[0.15pt]
Massimo assoluto RF, percorso attivo, T\textsubscript{case} 125 °C & 26 dBm & 28 dBm \\\midrule[0.15pt]
Hot switching (85 °C) & \multicolumn{2}{>{\raggedright\arraybackslash}p{\cw{0.4173}{24pt}{8pt}}}{30 dBm} \\
\end{longtable}}

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

\textbf{Motivo:}

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

{\footnotesize\arrayrulecolor{rulec}\setlength{\tabcolsep}{4pt}\renewcommand{\arraystretch}{1.1}
\begin{longtable}{>{\raggedright\arraybackslash}p{\cw{0.0725}{32pt}{0pt}}>{\raggedright\arraybackslash}p{\cw{0.0893}{32pt}{0pt}}>{\raggedright\arraybackslash}p{\cw{0.0741}{32pt}{0pt}}>{\raggedright\arraybackslash}p{\cw{0.7641}{32pt}{0pt}}}
\toprule
\textbf{Ref} & \textbf{Prima} & \textbf{Dopo} & \textbf{Effetto} \\
\midrule
\endhead
\bottomrule\endfoot
R703 & 100 k & \textbf{0 Ω} & Gate pilotato direttamente dal GPIO: V\textsubscript{GS} = −3.3 V (pienamente ON). R702 100 k tiene Q701 spento, quindi PA spento, con GPIO flottante al reset \\\midrule[0.15pt]
R242 & 100 Ω & \textbf{33 Ω} & \multirow{2}{=}{APC a vuoto 3.3 · 240/\allowbreak{}273 = 2.90 V (2.99 V con 3V3 = 3.4 V: sempre ≤ 3.0 V). Sotto carico (4.6 mA, R\textsubscript{th} 29 Ω) circa 2.77 V, vicino ai 2.8 V nominali Qorvo. Corrente nel partitore circa 12 mA, potenza su R243 circa 35 mW (0402 OK)} \\
R243 & 820 Ω & \textbf{240 Ω} &  \\
\end{longtable}}

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

\subsection[6. Simbolo di Q701 – correzione]{6. Simbolo di Q701 – correzione \tg{tagdone}{modificato v1.1}}

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

\textbf{Cosa farei:}

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

\subsection[M. Modifiche minori]{M. Modifiche minori \tg{tagdone}{modificato v1.0}}

{\footnotesize\arrayrulecolor{rulec}\setlength{\tabcolsep}{4pt}\renewcommand{\arraystretch}{1.1}
\begin{longtable}{>{\raggedright\arraybackslash}p{\cw{0.1222}{32pt}{0pt}}>{\raggedright\arraybackslash}p{\cw{0.1037}{32pt}{0pt}}>{\raggedright\arraybackslash}p{\cw{0.1258}{32pt}{0pt}}>{\raggedright\arraybackslash}p{\cw{0.6484}{32pt}{0pt}}}
\toprule
\textbf{Ref} & \textbf{Prima} & \textbf{Dopo} & \textbf{Motivo /\allowbreak{} riferimento} \\
\midrule
\endhead
\bottomrule\endfoot
C216 & 8.2 (senza unità) & \textbf{8.2p} & Valore incompleto (8.2 F). Verificare che il codice JLC C668333 sia 8.2 pF \\\midrule[0.15pt]
L243 & 2.4 nH & \textbf{2.7 nH} & Riferimento Qorvo QPA9510 410–470 MHz: L4 = 2.7 nH \\\midrule[0.15pt]
C260 & 27 p, 0402 & 27 p, \textbf{0603} & Riferimento Qorvo: C10 27 pF 0603 1 \% C0G (nodo a circa 5 Ω, corrente RF alta) \\\midrule[0.15pt]
L242 & 1 µH, 1206 & \textbf{0.9 µH, 1008} & Choke del PA: Coilcraft \textbf{1008AF-901XJR}, wire-wound, Isat 1.4 A, Irms 1.3 A, SRF 415 MHz, quindi impedenza molto alta a 433 MHz. \tg{tagwarn}{Nota}: la tua nota chiedeva Isat ≥ 2 A. La corrente reale a 3.3 V è circa 1.0–1.1 A (margine circa 30 \%). Se vuoi 2 A garantiti: Coilcraft 2222SQ-221 (220 nH, air core, circa 5 A, |Z| circa 600 Ω a 433 MHz), che però richiede un footprint dedicato \\\midrule[0.15pt]
C245, C256 & 3.3 µF, 0402 & \textbf{10 µF, 0805} & Bulk del PA: un 3.3 µF 0402 perde circa il 50 \% con la tensione applicata; Qorvo usa 3.3 µF al tantalio. 10 µF 0805 X5R/\allowbreak{}X7R ≥ 10 V \\\midrule[0.15pt]
L202 & 22 nH & \textbf{120 nH} & Choke dell'LNA: 22 nH valgono solo circa 60 Ω a 433 MHz, il datasheet chiede alta impedanza. 120 nH valgono circa 330 Ω (wire-wound 0402, es. Murata LQW15ANR12J00) \\\midrule[0.15pt]
Footprint IC2 & EP senza via & \textbf{3×3 via termiche} & QFN50P300X300X90-17N-D: 9 via, foro 0.25 mm, pad 0.45 mm, passo 0.5 mm. Qorvo raccomanda foro 0.203–0.330 mm su griglia 0.5–1.2 mm. Il PA dissipa circa 2.3 W (θ\textsubscript{jc} 12.5 °C/\allowbreak{}W) \\\midrule[0.15pt]
Nota layout & – & Testo sullo schema & Match d'uscita del PA: replicare il layout dell'EVB Qorvo, perché a circa 5 Ω piste e posizioni fanno parte del match. Prevedere taratura \\\midrule[0.15pt]
SDN Si4464 & \multicolumn{3}{>{\raggedright\arraybackslash}p{\cw{0.8778}{32pt}{16pt}}}{Non modificato, come richiesto (da discutere)} \\
\end{longtable}}

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

{\footnotesize\arrayrulecolor{rulec}\setlength{\tabcolsep}{4pt}\renewcommand{\arraystretch}{1.1}
\begin{longtable}{>{\raggedright\arraybackslash}p{\cw{0.3096}{32pt}{0pt}}>{\raggedright\arraybackslash}p{\cw{0.2004}{32pt}{0pt}}>{\raggedright\arraybackslash}p{\cw{0.2056}{32pt}{0pt}}>{\raggedright\arraybackslash}p{\cw{0.2845}{32pt}{0pt}}}
\toprule
\textbf{Funzione} & \textbf{Ref schema} & \textbf{Equivalente EVB Qorvo} & \textbf{Rimovibile?} \\
\midrule
\endhead
\bottomrule\endfoot
DC block ingresso RF & C255 56p & C1 56p & No (obbligatorio da datasheet) \\\midrule[0.15pt]
VCC1: induttanza del match interstadio + massa RF & L240 12n, C244 330p & L1 12n, C19 330p & No, fa parte del match \\\midrule[0.15pt]
VCC2: induttanza + massa RF & L241 6.8n, C248 330p & L6 6.8n, C20 330p & No, fa parte del match \\\midrule[0.15pt]
Choke del collettore & L242 & L3 1 µH & No \\\midrule[0.15pt]
Match d'uscita & C260 27p, L243 2.7n, C261 22p, C262 2p & C10, L4, C11, C25 & No \\\midrule[0.15pt]
Massa RF lato 3V3 del choke & C258 47p, C251 100p & C14 47p, C15 100p & No: chiudono a massa la RF a 433 MHz e alle armoniche \\\midrule[0.15pt]
Disaccoppiamento 1 nF & C241, C247, C257 & C3, C6, C13 & Sconsigliato: uno per ogni pin di alimentazione \\\midrule[0.15pt]
Disaccoppiamento 10 nF & C240, C246 (3V3), C252, C253 (APC) & C2, C5, C16, C17 & Solo C252 o C253, vedi sotto \\\midrule[0.15pt]
Bulk & C245, C256 10 µF & C18, C21 3.3 µF tantalio & No: il PA chiede impulsi da circa 1 A \\\midrule[0.15pt]
Ponticelli 0 Ω sulle alimentazioni & R240 (VCC1), R241 (VCC2) & R2, R3 0 Ω & \textbf{Sì, opzionali} \\\midrule[0.15pt]
Ponticello APC1–APC2 & R244 0 Ω & – & \textbf{Sì} \\
\end{longtable}}

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

In rev. 1.1 nessuna modifica eseguita (proposta \textbf{P3}).

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

\subsubsection[10.1 Errori nei codici esistenti]{10.1 Errori nei codici esistenti}

{\footnotesize\arrayrulecolor{rulec}\setlength{\tabcolsep}{4pt}\renewcommand{\arraystretch}{1.1}
\begin{longtable}{>{\raggedright\arraybackslash}p{\cw{0.0707}{40pt}{0pt}}>{\raggedright\arraybackslash}p{\cw{0.1896}{40pt}{0pt}}>{\raggedright\arraybackslash}p{\cw{0.2605}{40pt}{0pt}}>{\raggedright\arraybackslash}p{\cw{0.1588}{40pt}{0pt}}>{\raggedright\arraybackslash}p{\cw{0.3203}{40pt}{0pt}}}
\toprule
\textbf{Ref} & \textbf{Schema (valore, pad)} & \textbf{Codice attuale = cosa è davvero} & \textbf{Problema} & \textbf{Proposta Murata (codice JLC, stock)} \\
\midrule
\endhead
\bottomrule\endfoot
\textbf{C204} & 10n 0402, accoppiamento TCXO & C21585 = Murata LQG15HN10NJ02D, \textbf{induttore 10 nH} & \tg{tagwarn}{componente sbagliato} Il TCXO arriverebbe al Si4464 attraverso un induttore, senza blocco DC & GRM155R71E103KA01D, 10n 25V X7R, \textbf{C77013} (132k) \\\midrule[0.15pt]
\textbf{C230} & 56p 0805, DC block uscita PA & C437548 = GRM21A5C2E330JW01D, \textbf{33 pF} & \tg{tagwarn}{valore sbagliato} Sposta il match d'uscita & GRM21A5C2E560JW01D, 56p 250V C0G 0805, \textbf{C913752} (1853) \\\midrule[0.15pt]
\textbf{C206, C208} & 100p \textbf{0402}, lato antenna e uscita FL201 (63 V richiesti) & C1864265 = GRM21A5C2E101FW01D, 100p 250V \textbf{0805} & \tg{tagwarn}{pad sbagliato} Un 0805 non entra nel footprint 0402 & (a) footprint a 0805 e codice invariato (250 V, coerente con C212/\allowbreak{}C213); oppure (b) GRM1555C2A101GA01D, 100p 100V 0402, \textbf{C21366878} (3109). Consiglio (a) \\\midrule[0.15pt]
\textbf{C207} & 100p \textbf{0402}, porta RX dello switch & C1864265 (0805) & \tg{tagwarn}{pad sbagliato} & GRM1555C1H101JA01D, 100p 50V C0G, \textbf{C77177} (987k), oppure come C206 per uniformità \\\midrule[0.15pt]
C201, C203 & 100n 0402 su 3V3 & C1525 = Samsung CL05B104KO5NNNC, 16 V & \tg{tagwarn}{non Murata} 16 V < 17 V & GRM155R71E104KE14D, 100n 25V X7R, \textbf{C77014} (538k) \\\midrule[0.15pt]
C211 & 100n 0402 su \textbf{5V0} (da v1.1) & C1525, 16 V & \tg{tagwarn}{non Murata} 16 V < 25 V & \textbf{C77014} (25 V = 5×, al limite). Se vuoi margine sopra 5×: 0402 50 V X7R \\\midrule[0.15pt]
C202 & 1u 0402 su 3V3 & C29266 = Samsung CL05A105KO5NNNC, 16 V & \tg{tagwarn}{non Murata} 16 V < 17 V & GRM155R61E105KA12D, 1u 25V X5R, \textbf{C77009} (607k) \\\midrule[0.15pt]
C215 & 1u 0402 su 3V3 & C76999 = Murata GRM155R61A105KE15D, \textbf{10 V} & \tg{tagwarn}{tensione} 10 V < 17 V & \textbf{C77009} (25 V) \\
\end{longtable}}

\subsubsection[10.2 Codici esistenti corretti]{10.2 Codici esistenti corretti}

{\footnotesize\arrayrulecolor{rulec}\setlength{\tabcolsep}{4pt}\renewcommand{\arraystretch}{1.1}
\begin{longtable}{>{\raggedright\arraybackslash}p{\cw{0.2011}{32pt}{0pt}}>{\raggedright\arraybackslash}p{\cw{0.2952}{32pt}{0pt}}>{\raggedright\arraybackslash}p{\cw{0.1784}{32pt}{0pt}}>{\raggedright\arraybackslash}p{\cw{0.3253}{32pt}{0pt}}}
\toprule
\textbf{Ref} & \textbf{Codice} & \textbf{Verifica} & \textbf{Note} \\
\midrule
\endhead
\bottomrule\endfoot
C209, C210 (6.8p 0805) & C464958 Murata GQM2195C2E6R8CB12D & valore, pad, 250 V, Murata: OK &  \\\midrule[0.15pt]
C212, C213, C222, C223 (100p 0805) & C1864265 Murata GRM21A5C2E101FW01D & OK (C213 vede 3.3 V DC: 250 V ok) & stock 418 \\\midrule[0.15pt]
C214, C226, C227 (100p 0402, 3V3) & C77177 Murata 50 V C0G & OK &  \\\midrule[0.15pt]
C216 (8.2p 0805) & C668333 Murata GQM2195C2E8R2CB12D & OK (verificato: è 8.2 pF) &  \\\midrule[0.15pt]
C217, C218 (5.6p 0805) & C2357067 Murata GQM2195C2E5R6BB12D & valore, pad, 250 V OK & \tg{tagwarn}{stock 0} Nessun 5.6p 0805 Murata disponibile oggi. Opzioni: preordine, oppure 0402 GJM1555C1H5R6BB01D (C161329), ma cambia footprint e va ritarato il filtro \\\midrule[0.15pt]
C219, C220 (7.5p 0805) & C3831627 Murata 250 V & OK &  \\\midrule[0.15pt]
C228 (1n 0402, 3V3) & C76947 Murata 50 V C0G & OK &  \\\midrule[0.15pt]
L201, L203, L204, L206 (22n 0805) & C2042193 Murata LQW2BAN22NJ00L & OK, 1.9 A &  \\\midrule[0.15pt]
L205 (18n 0805) & C2042168 Murata LQW2BAN18NG00L & OK, 2.2 A & stock 46: basso \\\midrule[0.15pt]
R201 33, R202 33k, R203 10k, R702 100k & C25105, C25779, C71617, C60491 & valore e pad OK, 50 V &  \\\midrule[0.15pt]
R29 22k, R31 10k (POWER, v1.1) & C25547, C71617 & OK & R29 al 5 \%: soglia OV tra 5.8 e 6.3 V, accettabile \\\midrule[0.15pt]
IC202 HMC349 & C662138 HMC349AMS8GETR & OK (versione in bobina) &  \\\midrule[0.15pt]
IC204 Si4464 & C482027 & OK & \tg{tagwarn}{stock 0} \\\midrule[0.15pt]
Q201 TQP3M9036 & C920261 & OK &  \\\midrule[0.15pt]
FL201 LFCG-490+ & C3034233 & OK & stock 50: basso \\\midrule[0.15pt]
Y201 TCXO & C19858587 & OK & stock 54: basso \\\midrule[0.15pt]
U701 74AUP2G14 & C526337 74AUP2G14DW-7, SOT-363 & OK &  \\\midrule[0.15pt]
Q701 FDN308P & C7472857 & package OK & \tg{tagwarn}{verificare} È un FDN308P di TECH PUBLIC (compatibile, P-ch 20 V 2.8 A), non onsemi. Controllare pinout e V\textsubscript{GS(th)} sul suo datasheet. Su JLCPCB non c'è l'originale onsemi \\\midrule[0.15pt]
J201 MMCX & C2999837 DreamLNK DL-MMCX-KEF-180 & \tg{tagwarn}{footprint diverso} & Il footprint è Molex 73415-0961. Usare il codice Molex C588476 (stock 12), oppure verificare che il land pattern DreamLNK coincida \\
\end{longtable}}

\subsubsection[10.3 Posizioni senza codice: proposta Murata]{10.3 Posizioni senza codice: proposta Murata}
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
