Brik81/SYMPHONY_BRIDGE/SYMPHONY_V2/DESIGN/SYMPHONY_V2/report_src/bak_report_pre_layout/entries/002_parte-c-rev-1-4.tex

\clearpage
\section[Parte C – Rev. 1.4 – Verifica completa del progetto, foglio per foglio]{Parte C – Rev. 1.4 – Verifica completa del progetto, foglio per foglio}

Richiesta di Brik81 del 20/\allowbreak{}10/\allowbreak{}2026: controllo di tutti i fogli, con conferma finale di dimensionamento e collegamenti. I codici JLCPCB sono esclusi da questa verifica (li gestisce Brik81). \textbf{In questa revisione nessun file di progetto è stato modificato}: gli errori trovati diventano proposte (P8–P17) e aspettano l'approvazione.

\subsection[13. Metodo e quadro generale]{13. Metodo e quadro generale}

\begin{itemize}
\item \textbf{Netlist} esportata con \code{kicad-cli 10.\allowbreak{}0} dai file salvati su disco (19/\allowbreak{}10/\allowbreak{}2026 17:26) e letta componente per componente, pin per pin: 173 componenti, di cui 12 DNP.
\item \textbf{ERC} completo: \textbf{184 segnalazioni} (erano 189 in rev. 1.3). Le ho guardate tutte:
{\small\arrayrulecolor{rulec}\setlength{\tabcolsep}{4pt}\renewcommand{\arraystretch}{1.1}
\begin{longtable}{>{\raggedright\arraybackslash}p{\cw{0.3492}{24pt}{0pt}}>{\raggedright\arraybackslash}p{\cw{0.0543}{24pt}{0pt}}>{\raggedright\arraybackslash}p{\cw{0.5964}{24pt}{0pt}}}
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
