Brik81/SYMPHONY_BRIDGE/SYMPHONY_V2/DESIGN/SYMPHONY_V2_CLAUDE_PCB/report/rf_tracks.png

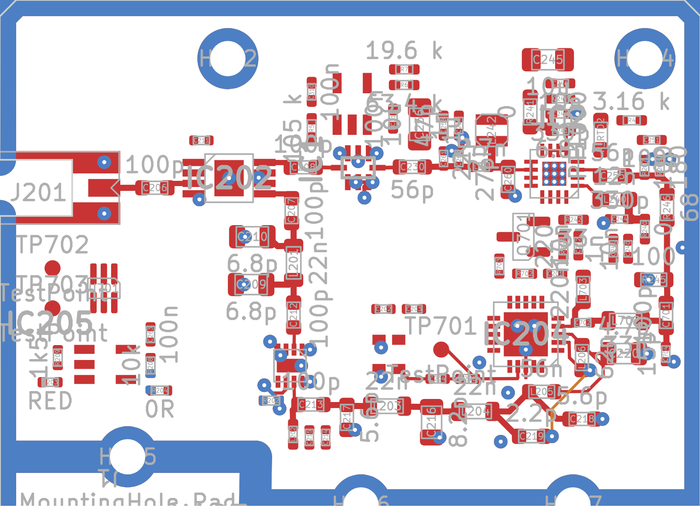
SYMPHONY_V2/DESIGN/SYMPHONY_V2_CLAUDE_PCB/report/rf_tracks.png
