Brik81/SYMPHONY_BRIDGE/SYMPHONY_V2/UHF RADIO_OLD forse da cancellare/old/UHF Radio.xlsx

ID | Type | Description | Val | Unit | Status | Parent
REQ-000 | System | RESILIENZA DEL SISTEMA PRIMA DI TUTTO |  |  | Draft
REQ-001 | System | La radio deve essere TX/RX per VHF e TX/RX per UHF ed essere in grado di lavorare in half-duplex (UHF tx, VHF rx) |  |  | Draft
REQ-002 | System | La radio deve poter operare in | VHF |  | Draft
REQ-002-01 | System | La banda VHF deve essere almeno nel range | 130 - 300 | MHz | Draft | REQ-002
REQ-003 | System | La radio deve poter operare in | UHF |  | Draft
REQ-003-01 | System | La banda UHF deve essere almeno nel range | 400.15 - 440 | MHz | Draft | REQ-003
REQ-004 | System | max Data rate in RF TX/RX | 38.4 | kbps | Draft
REQ-005 | System | Form factor meccanico | PC104 |  | Draft
REQ-007 | System | Modulazione RF | PSK e FSK |  | Draft
REQ-008 | System | La potenza di trasmissione deve essere | >= 1 [>= 30dBm] | W | Draft
REQ-009 | System | Supply voltage | 3.3 e/o 5 | V | Draft
REQ-009-01 | System | Deve avere due canali separati di voltage supply per ridondanza |  |  | Draft | REQ-009
REQ-010 | System | Parametri di configurazione del sistema su FRAM |  |  | Draft
REQ-011 | System | Range temperatura di operatività | -30 -+ 85 | °C | Draft
REQ-012 | System | Connettore debug (VCC + Data) per funzionamento modalità isola | USB Type C 2.0 |  | Draft
REQ-012-01 | System | La posizione del connettore deve essere sul lato destro della board (vista dall'alto) |  |  | Draft | REQ-012
REQ-012-02 | System | OV, OC, reverse polarity and ESD protection in the debug connector |  |  | Draft | REQ-012
REQ-013 | System | Connettore RF orizzontale TX/RX UHF | MMCX |  | Draft
REQ-013-01 | System | La posizione del connettore RF deve essere sul lato sinistro della board (vista dall'alto) |  |  | Draft | REQ-013
REQ-029 | System | Connettore RF orizzontale TX/RX VHF | MMCX |  | Draft
REQ-014 | System | Software update possibile IN-FLIGHT |  |  | Draft
REQ-015 | System | Potenza in trasmissione dell'intero sistema (con max TX RF) | < 4 | W | Draft
REQ-016 | System | Potenza in ricezione dell'intero sistema | < 1 | W | Draft
REQ-017 | System | Occupazione di banda per data rate 9.6 kbps | <= 50 | kHz | Draft
REQ-018 | Interface | Interfaccia comandi e dati | CAN e I2C |  | Draft
REQ-018-01 | System | Terminatore opzionale 120ohm per CAN |  |  | Draft | REQ-018
REQ-018-02 | System | Pullups I2C opzionali [default NO] |  |  | Draft | REQ-018
REQ-024 | System | Posizione CAN | H1:1 (CAN L), 3 (CAN H) |  | Draft
REQ-025 | System | Posizione I2C | H1: 41 (SDA), 43 (SCL) |  | Draft
REQ-020 | System | Pin digitale di Enable | H2:10 |  | Draft
REQ-021 | System | Memoria FLASH per lo storage dati | >= 1 | MB | Draft
REQ-022 | System | Presente sensore di temperatura per la board |  |  | Draft
REQ-023 | System | Secondo sensore di temperatura sul PA e spegnimento automatico della trasmissione in caso di raggiungimento temperatura critica | TBD | °C | Draft
REQ-026 | System | Pin di ground su PC104 | H2: 29,30,31,32 |  | Draft
REQ-027 | Interface | Interfacce dati e digitali compatibili con LVTTL (UART, enable etc...) | 3.3 | V | Draft
REQ-027-01 | System | Se possibile rendere il sistema resiliente contro possibili livelli a 5V |  |  | Draft | REQ-027
REQ-028 | System | Corrente e potenza consumata come telemetria del sistema |  |  | Draft
