Brik81/SYMPHONY_BRIDGE/SYMPHONY_V2/DESIGN/SYMPHONY_V2/SYMPHONY.step

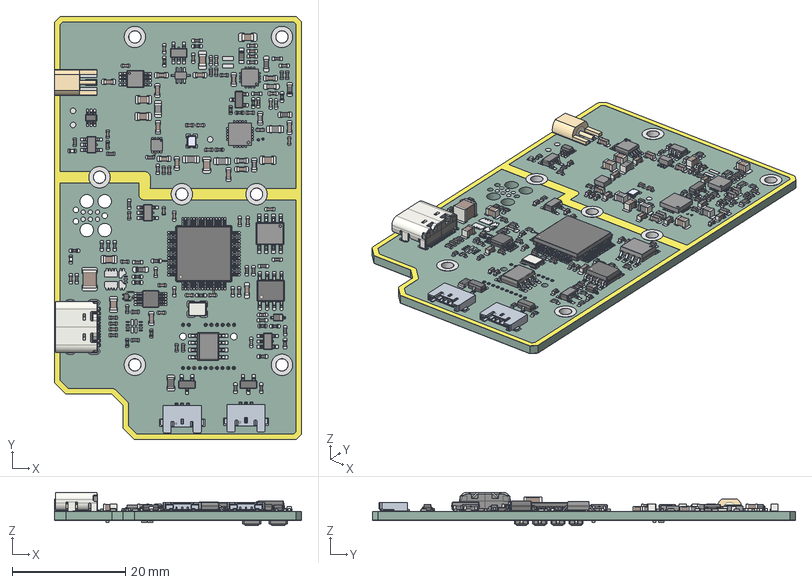
[picture p2: CAD file, 2026-11-11]
SYMPHONY_V2/DESIGN/SYMPHONY_V2/SYMPHONY.step
43.7 x 74.8 x 5.88 mm
R_0402_1005Metric x 46
C_0402_1005Metric x 49
L_0805_2012Metric x 4
C_1210_3225Metric
SOT-23-3 x 2
LED_0402_1005Metric x 2
D_SOD-323
C_0805_2012Metric x 8
C_0603_1608Metric x 14
DRT_3
MSOP-10_3x3mm_P0.5mm
R_0603_1608Metric x 5
BODY-SOT x 4
LEAD-SOT x 20
LEAD-DUMMY x 4
ECS-TXO-20CSMV4-192-AN-TR
PinsArrayLR x 5
MMCX_Molex_73415-0961_Horizontal
ThermalPin x 3
PinsArrayTB x 2
SOT-363_SC-70-6
L_0603_1608Metric x 4
USB_C_Receptacle_16P_TopMnt_Horizontal_GCT_USB4105-xx-A
LQFP-64_10x10mm_P0.5mm
SOIC-8_3.9x4.9mm_P1.27mm
R_0805_2012Metric
L_0402_1005Metric x 3
Crystal_SMD_3225-4Pin_3.2x2.5mm
SOT-23
BODY-SO
LEAD-D0008A x 8
ThermalPad
Pins
CPH3225A x 8
SYMPHONY_copper
SYMPHONY_pad
SYMPHONY_via
SYMPHONY_PCB
