Brik81/SYMPHONY_BRIDGE/SYMPHONY_V2/DESIGN/SYMPHONY_V2/UHF_LIB/.ZIP_FILE/FM25V10-G/3D/FM25V10-G.stp

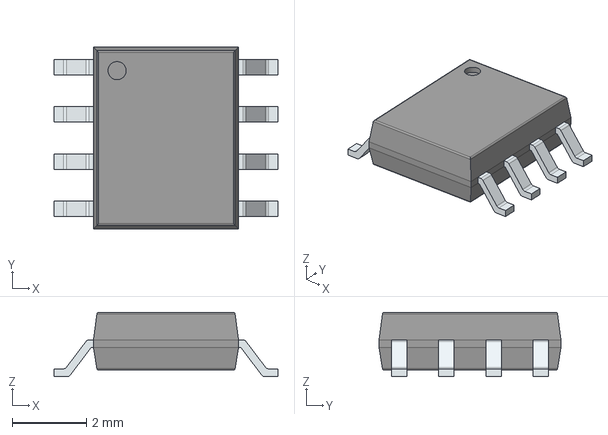
[picture p3: CAD file, 2026-11-04]
SYMPHONY_V2/DESIGN/SYMPHONY_V2/UHF_LIB/.ZIP_FILE/FM25V10-G/3D/FM25V10-G.stp
6.02 x 4.89 x 1.73 mm
PinsArrayLR
