Brik81/SYMPHONY_BRIDGE/SYMPHONY_V2/DESIGN/SYMPHONY_V2/UHF_LIB/.ZIP_FILE/GRF5604/3D/GRF5604.stp

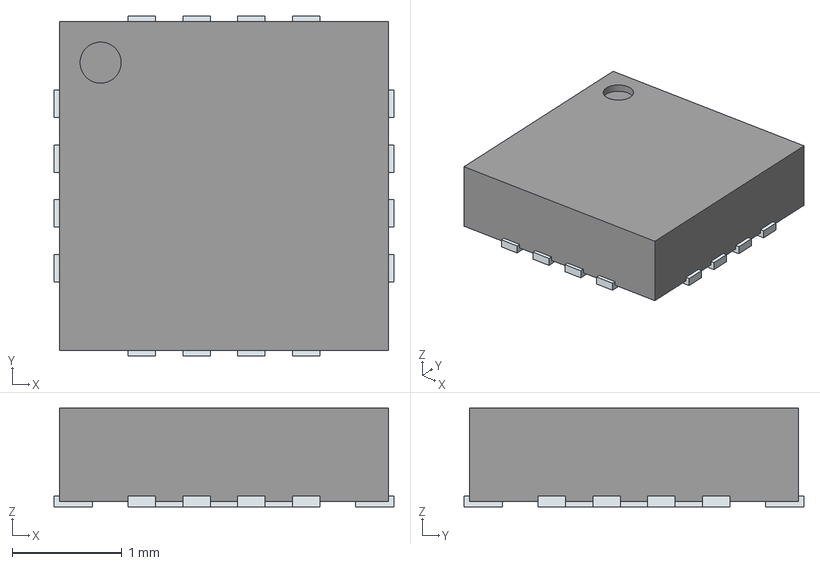
[picture p4: CAD file, 2026-11-04]
SYMPHONY_V2/DESIGN/SYMPHONY_V2/UHF_LIB/.ZIP_FILE/GRF5604/3D/GRF5604.stp
3.10 x 3.10 x 0.9 mm
ThermalPin
PinsArrayLR
PinsArrayTB
