Brik81/SYMPHONY_BRIDGE/SYMPHONY_V2/DESIGN/SYMPHONY_V2/UHF_LIB/3D/PUSB3AB4Z.stp

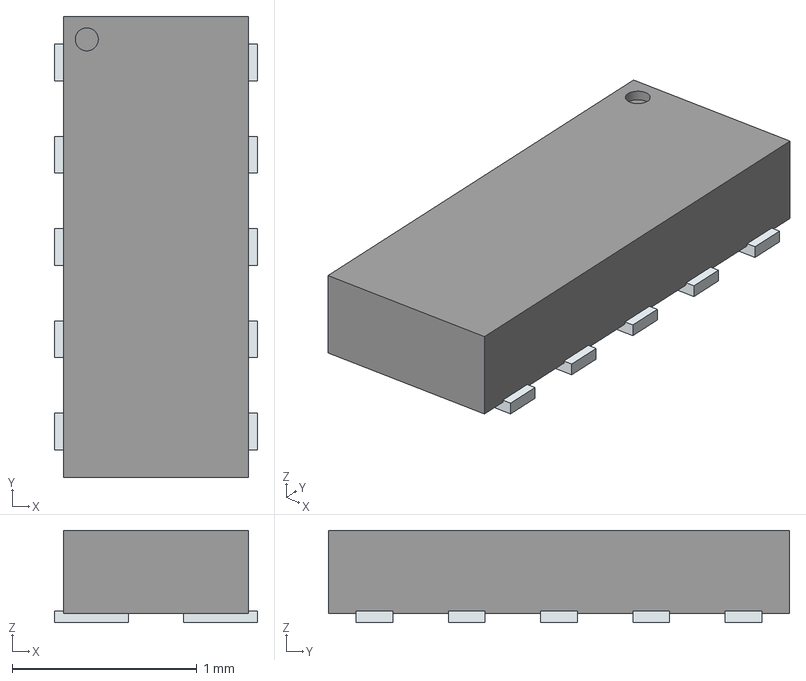
[picture p5: CAD file, 2026-11-04]
SYMPHONY_V2/DESIGN/SYMPHONY_V2/UHF_LIB/3D/PUSB3AB4Z.stp
1.10 x 2.50 x 0.5 mm
PinsArrayLR
