Brik81/SYMPHONY_BRIDGE/SYMPHONY_V2/DESIGN/SYMPHONY_V2_BACKUP_ORIGINALE_10_11/UHF_LIB/.ZIP_FILE/CX2016DB24000D0FLJC6/3D/CX2016DB24000D0FLJC6.stp

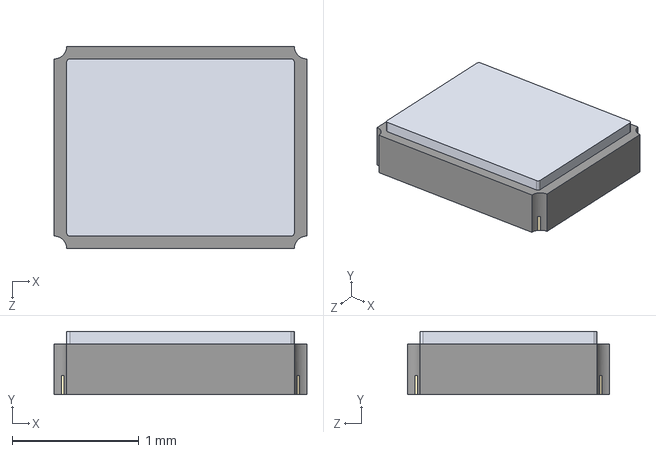
[picture p6: CAD file, 2026-11-10]
SYMPHONY_V2/DESIGN/SYMPHONY_V2_BACKUP_ORIGINALE_10_11/UHF_LIB/.ZIP_FILE/CX2016DB24000D0FLJC6/3D/CX2016DB24000D0FLJC6.stp
2.00 x 0.5 x 1.60 mm
