Brik81/SYMPHONY_BRIDGE/SYMPHONY_V2/DESIGN/SYMPHONY_V2_BACKUP_ORIGINALE_10_11/UHF_LIB/3D/HCP-6-1_ADI.step

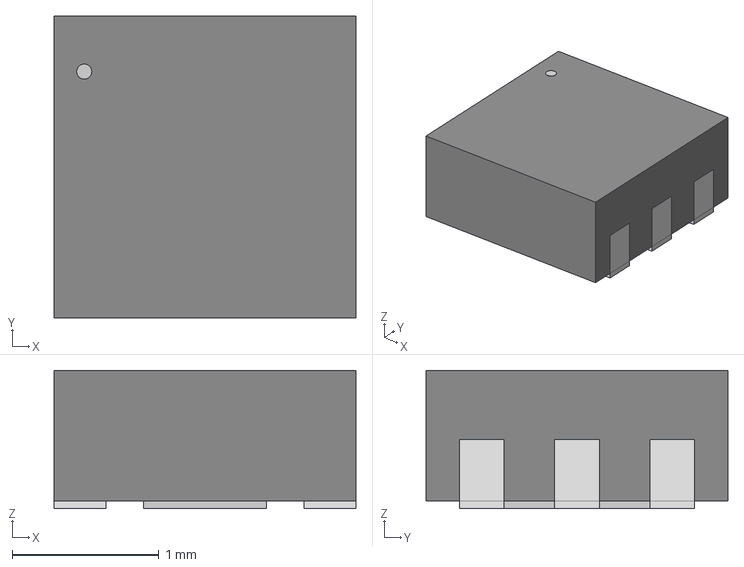
[picture p7: CAD file, 2026-11-10]
SYMPHONY_V2/DESIGN/SYMPHONY_V2_BACKUP_ORIGINALE_10_11/UHF_LIB/3D/HCP-6-1_ADI.step
2.06 x 2.06 x 0.942 mm
