Brik81/SYMPHONY_BRIDGE/SYMPHONY_V2/DESIGN/SYMPHONY_V2_CLAUDE_PCB/UHF_LIB/.ZIP_FILE/STM32H753VIT6/3D/STM32H753VIT6.stp

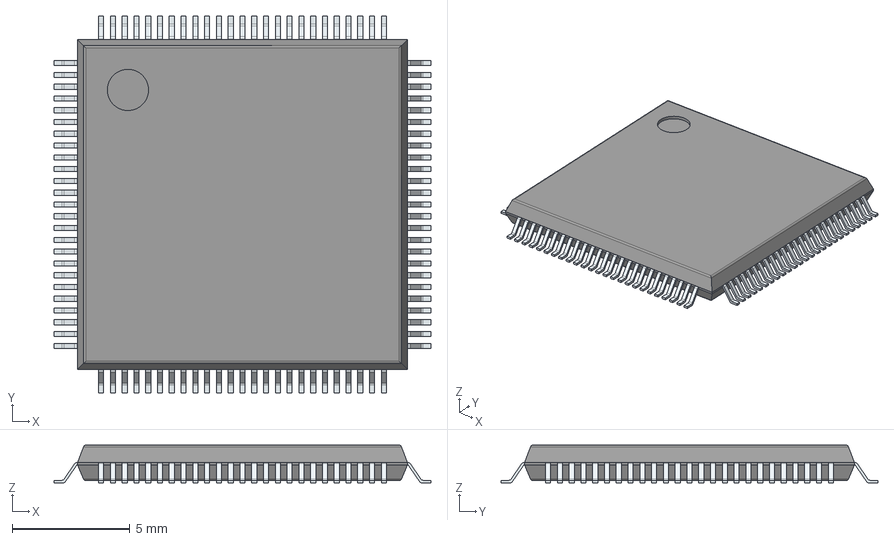
[picture p8: CAD file, 2026-11-10]
SYMPHONY_V2/DESIGN/SYMPHONY_V2_CLAUDE_PCB/UHF_LIB/.ZIP_FILE/STM32H753VIT6/3D/STM32H753VIT6.stp
16.0 x 16.0 x 1.60 mm
PinsArrayLR
PinsArrayTB
