Brik81/SYMPHONY_BRIDGE/SYMPHONY_V2/DESIGN/SYMPHONY_V2_CLAUDE_PCB/UHF_LIB/3D/CPH3225A.stp

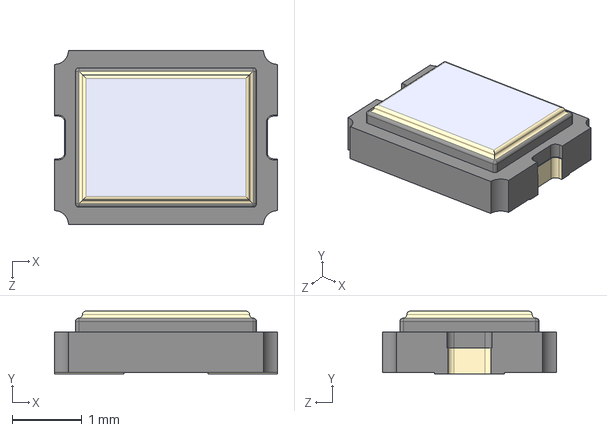
[picture p9: CAD file, 2026-11-10]
SYMPHONY_V2/DESIGN/SYMPHONY_V2_CLAUDE_PCB/UHF_LIB/3D/CPH3225A.stp
3.20 x 0.9 x 2.50 mm
