Brik81/SYMPHONY_BRIDGE/SYMPHONY_V2/DESIGN/SYNPHONY/SINFONY/UHF_LIB/.ZIP_FILE/M41T82ZM6F/3D/M41T82ZM6F.stp

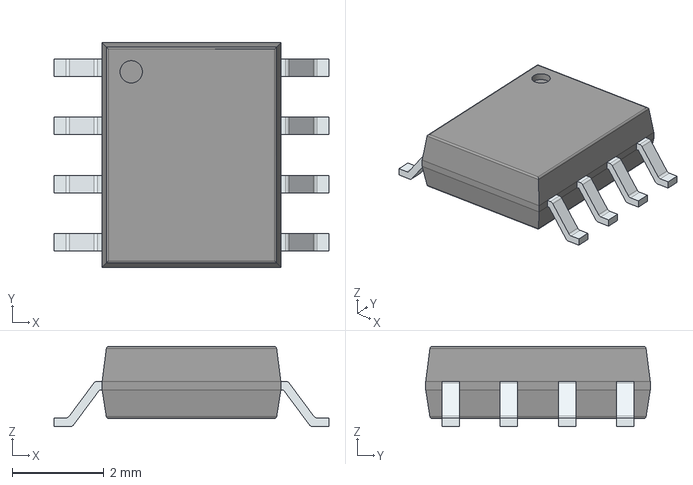
[picture p10: CAD file, 2026-11-04]
SYMPHONY_V2/DESIGN/SYNPHONY/SINFONY/UHF_LIB/.ZIP_FILE/M41T82ZM6F/3D/M41T82ZM6F.stp
6.00 x 4.90 x 1.75 mm
PinsArrayLR
