Brik81/SYMPHONY_BRIDGE/SYMPHONY_V2/DESIGN/SYNPHONY/SINFONY/UHF_LIB/.ZIP_FILE/MS621FE-FL11E.step

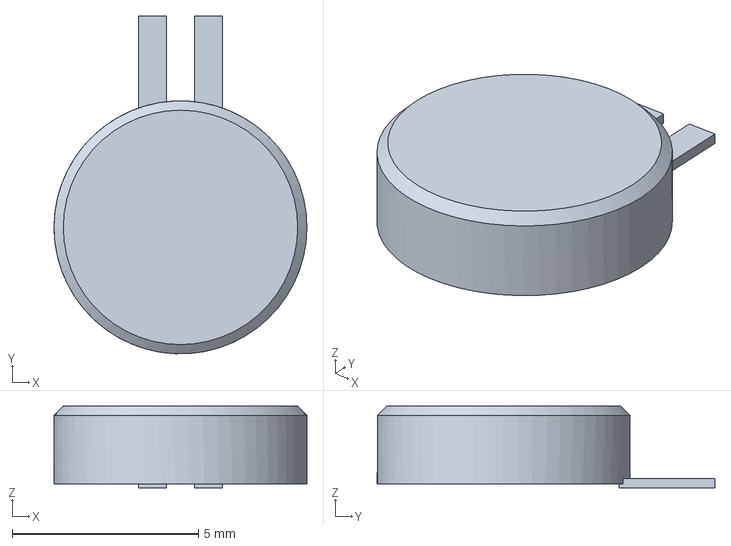
[picture p11: CAD file, 2026-11-04]
SYMPHONY_V2/DESIGN/SYNPHONY/SINFONY/UHF_LIB/.ZIP_FILE/MS621FE-FL11E.step
6.80 x 9.07 x 2.20 mm
