Brik81/SYMPHONY_BRIDGE/SYMPHONY_V2/DESIGN/SYNPHONY/SINFONY/UHF_LIB/.ZIP_FILE/S2-LPCBQTR/3D/S2-LPCBQTR.stp

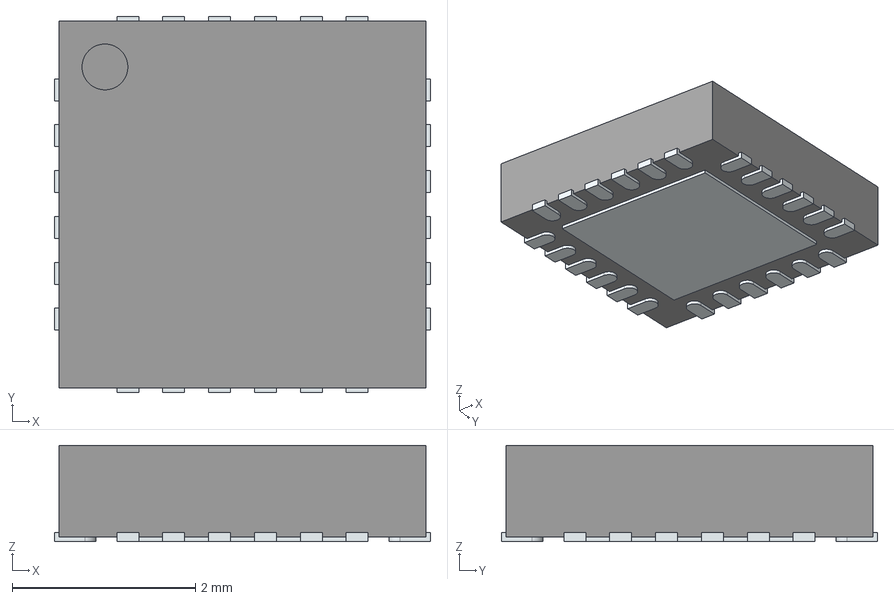
[picture p12: CAD file, 2026-11-04]
SYMPHONY_V2/DESIGN/SYNPHONY/SINFONY/UHF_LIB/.ZIP_FILE/S2-LPCBQTR/3D/S2-LPCBQTR.stp
4.10 x 4.10 x 1.05 mm
ThermalPin
PinsArrayLR
PinsArrayTB
