Brik81/SYMPHONY_BRIDGE/SYMPHONY_V2/DESIGN/SYNPHONY/SINFONY/UHF_LIB/.ZIP_FILE/SPIRIT1QTR/3D/SPIRIT1QTR.stp

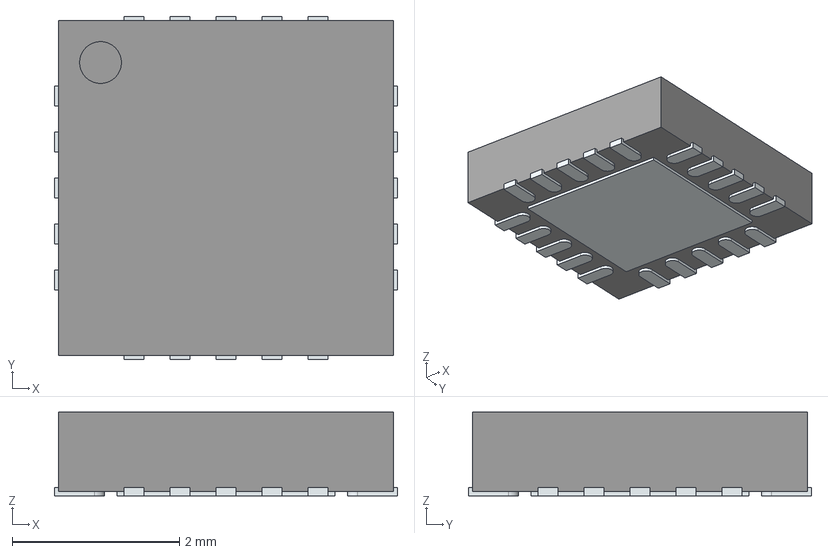
[picture p13: CAD file, 2026-11-04]
SYMPHONY_V2/DESIGN/SYNPHONY/SINFONY/UHF_LIB/.ZIP_FILE/SPIRIT1QTR/3D/SPIRIT1QTR.stp
4.10 x 4.10 x 1.00 mm
ThermalPin
PinsArrayLR
PinsArrayTB
