Brik81/SYMPHONY_BRIDGE/SYMPHONY_V2/DESIGN/SYNPHONY/SINFONY/UHF_LIB/.ZIP_FILE/TCM1-63AX+/3D/TCM1-63AX+.stp

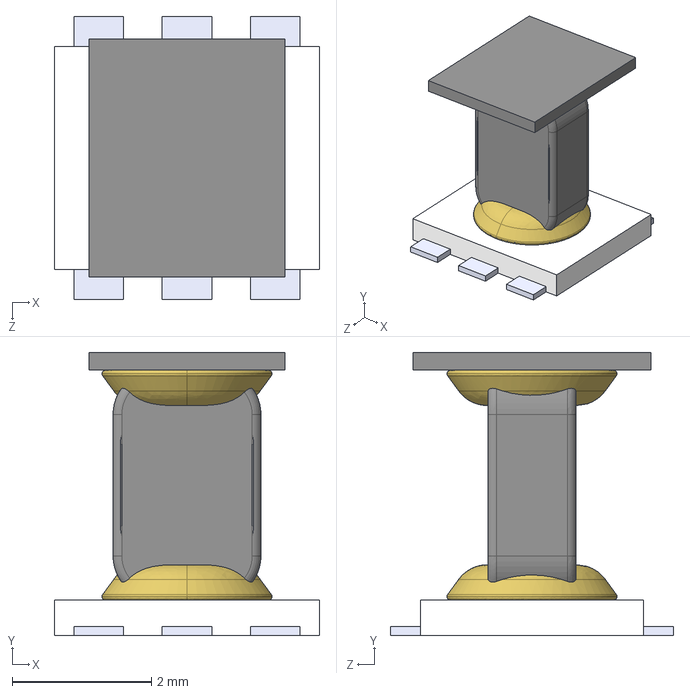
[picture p14: CAD file, 2026-11-04]
SYMPHONY_V2/DESIGN/SYNPHONY/SINFONY/UHF_LIB/.ZIP_FILE/TCM1-63AX+/3D/TCM1-63AX+.stp
3.81 x 4.06 x 4.06 mm
