Brik81/SYMPHONY_BRIDGE/SYMPHONY_V2/DESIGN/SYNPHONY/SINFONY/UHF_LIB/3D/LFCSP-16_AD.step

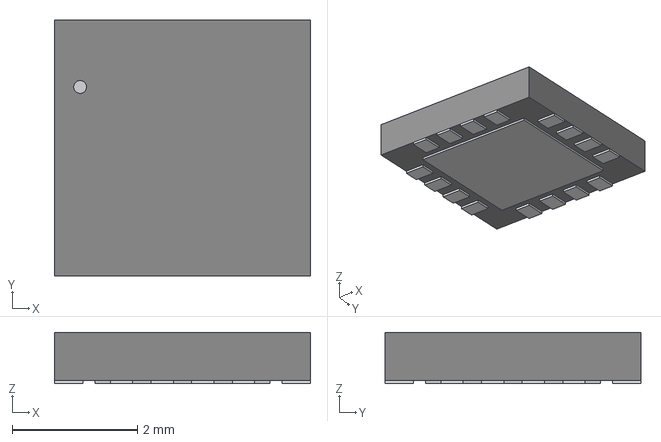
[picture p15: CAD file, 2026-11-04]
SYMPHONY_V2/DESIGN/SYNPHONY/SINFONY/UHF_LIB/3D/LFCSP-16_AD.step
4.09 x 4.09 x 0.815 mm
