Brik81/SYMPHONY_BRIDGE/SYMPHONY_V2/DESIGN/SYMPHONY_V2/UHF_LIB/3D/MEM2061-01-188-00-A.stp

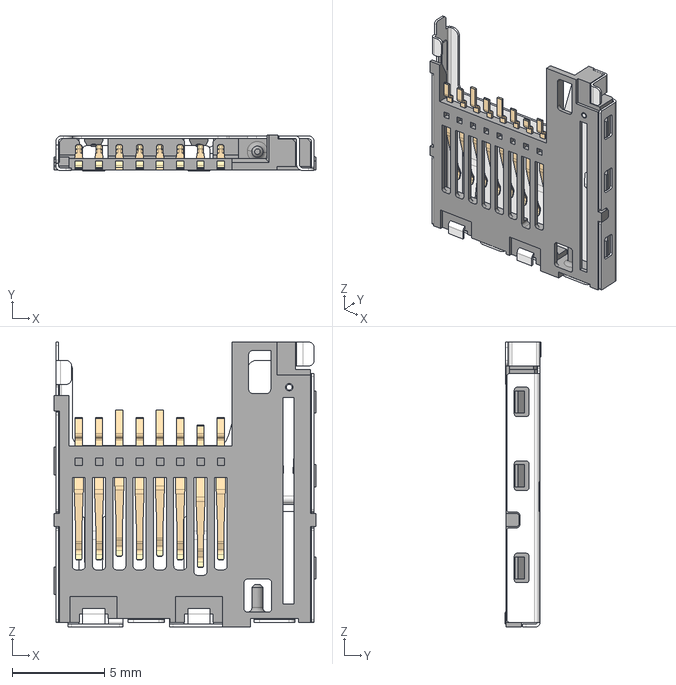
[picture p16: CAD file, 2026-11-04]
SYMPHONY_V2/DESIGN/SYMPHONY_V2/UHF_LIB/3D/MEM2061-01-188-00-A.stp
14.2 x 1.95 x 15.5 mm
MEM2061-01-188-00-A_PART1
MEM2061-01-188-00-A_PART2
