Brik81/SYMPHONY_BRIDGE/SYMPHONY_V2/DESIGN/SYMPHONY_V2_BACKUP_ORIGINALE_10_11/UHF_LIB/3D/TPS7A2030PDBVRG4.stp

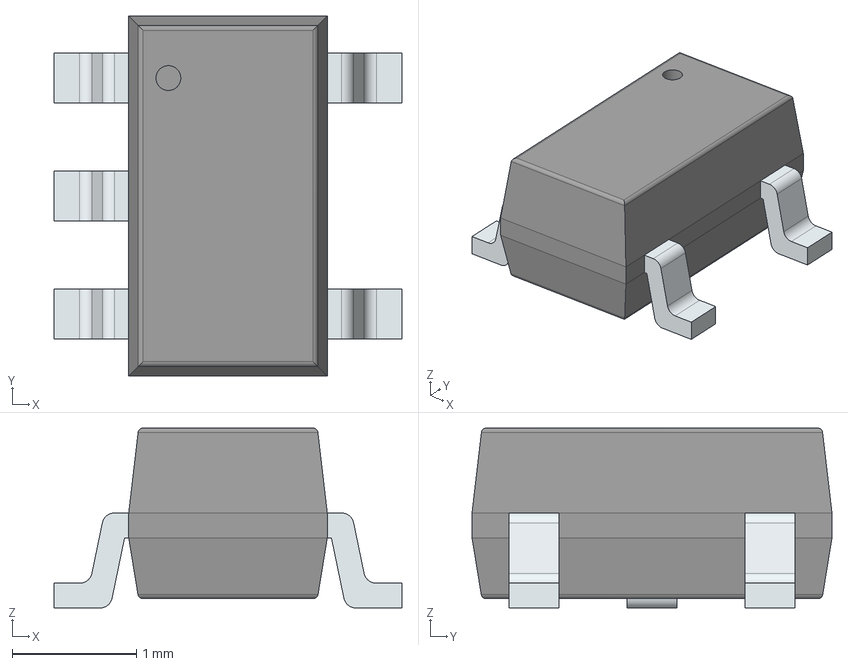
[picture p17: CAD file, 2026-11-10]
SYMPHONY_V2/DESIGN/SYMPHONY_V2_BACKUP_ORIGINALE_10_11/UHF_LIB/3D/TPS7A2030PDBVRG4.stp
2.80 x 2.90 x 1.45 mm
PinsArrayL
PinsArrayR
