Brik81/SYMPHONY_BRIDGE/SYMPHONY_V2/DESIGN/SYNPHONY/SINFONY/UHF_LIB/3D/TCAN3414DR.step

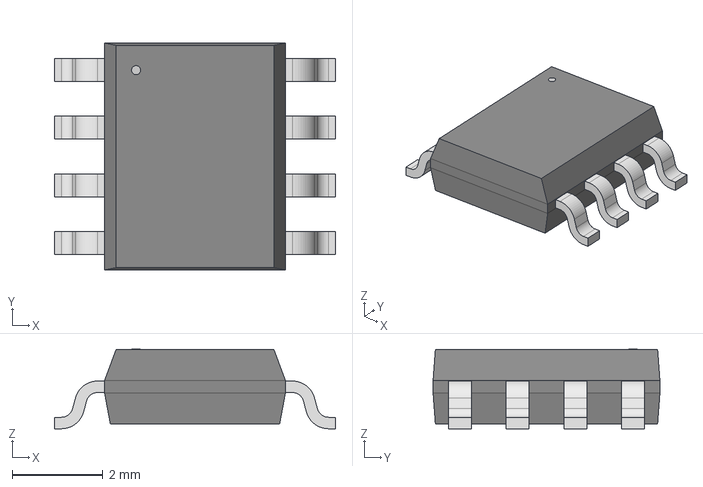
[picture p18: CAD file, 2026-11-04]
SYMPHONY_V2/DESIGN/SYNPHONY/SINFONY/UHF_LIB/3D/TCAN3414DR.step
6.20 x 5.00 x 1.75 mm
