Brik81/SYMPHONY_BRIDGE/SYMPHONY_V2/DESIGN/SYMPHONY_V2_CLAUDE_PCB/UHF_LIB/3D/SOIC_208MIL_WIN.step

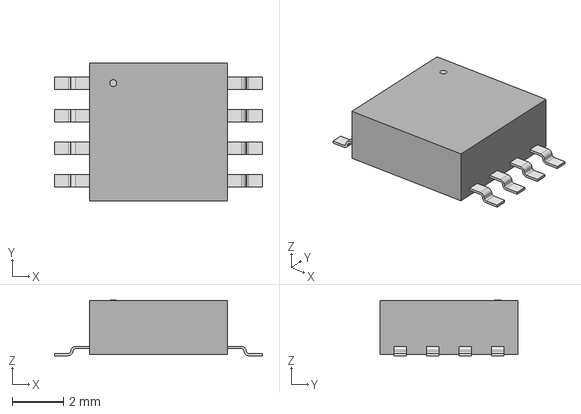
[picture p19: CAD file, 2026-11-10]
SYMPHONY_V2/DESIGN/SYMPHONY_V2_CLAUDE_PCB/UHF_LIB/3D/SOIC_208MIL_WIN.step
8.10 x 5.38 x 2.16 mm
