Brik81/SYMPHONY_BRIDGE/SYMPHONY_V2/DESIGN/SYNPHONY/SINFONY/UHF_LIB/3D/TQP7M9106.stp

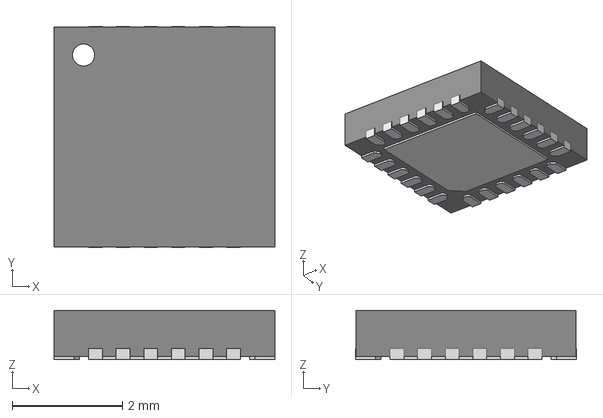
[picture p20: CAD file, 2026-11-04]
SYMPHONY_V2/DESIGN/SYNPHONY/SINFONY/UHF_LIB/3D/TQP7M9106.stp
4.01 x 4.01 x 0.889 mm
