Brik81/SYMPHONY_BRIDGE/SYMPHONY_V2/DESIGN/SYMPHONY_V2/UHF_LIB/3D/SI4464-B1B-FMR.stp

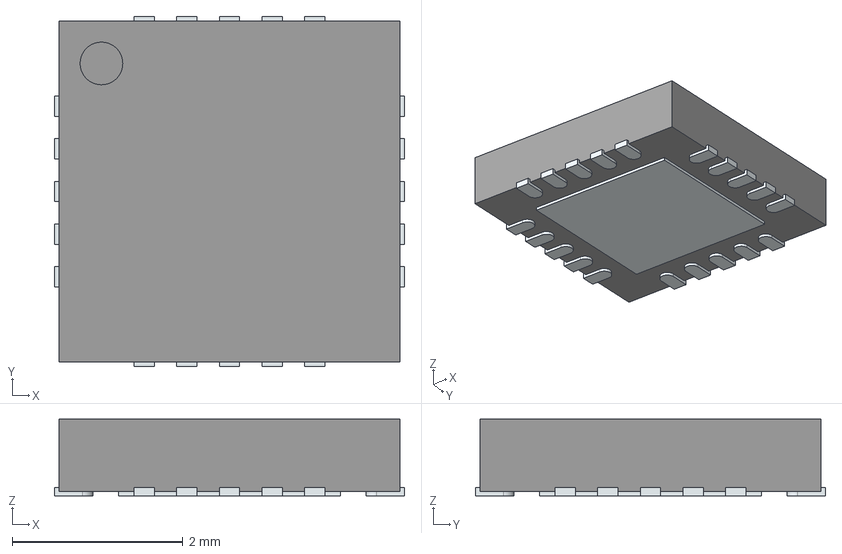
[picture p21: CAD file, 2026-11-04]
SYMPHONY_V2/DESIGN/SYMPHONY_V2/UHF_LIB/3D/SI4464-B1B-FMR.stp
4.10 x 4.10 x 0.9 mm
ThermalPin
PinsArrayLR
PinsArrayTB
