Brik81/SYMPHONY_BRIDGE/SYMPHONY_V2/DESIGN/SYMPHONY_V2_BACKUP_ORIGINALE_10_11/UHF_LIB/3D/ADM7172ACPZ-3.3-R7.step

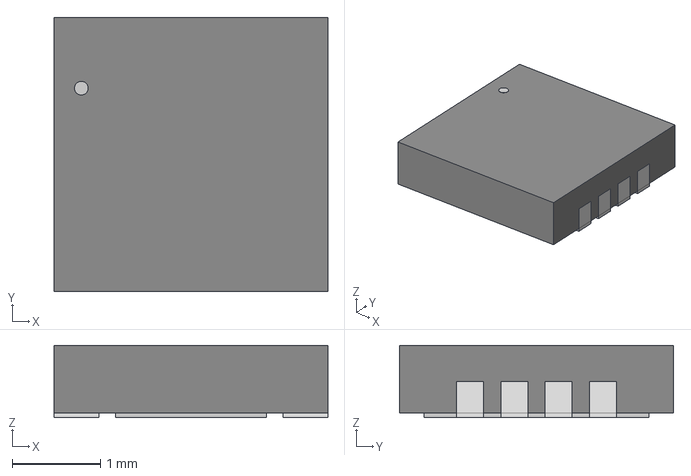
[picture p22: CAD file, 2026-11-10]
SYMPHONY_V2/DESIGN/SYMPHONY_V2_BACKUP_ORIGINALE_10_11/UHF_LIB/3D/ADM7172ACPZ-3.3-R7.step
3.10 x 3.10 x 0.815 mm
