Brik81/SYMPHONY_BRIDGE/SYMPHONY_V2/DESIGN/SYMPHONY_V2_CLAUDE_PCB/UHF_LIB/3D/QFN_31DLTR_STM.step

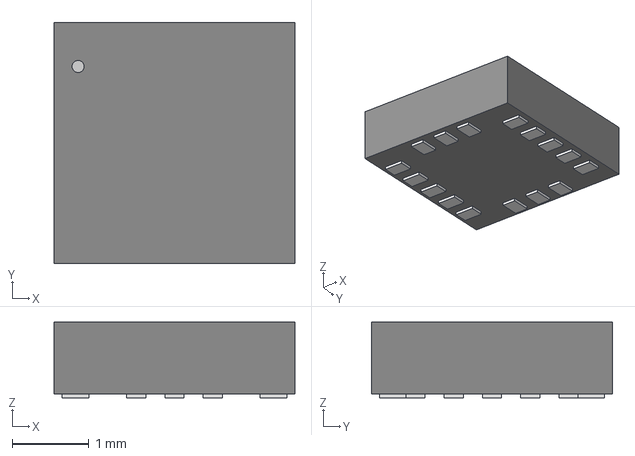
[picture p23: CAD file, 2026-11-10]
SYMPHONY_V2/DESIGN/SYMPHONY_V2_CLAUDE_PCB/UHF_LIB/3D/QFN_31DLTR_STM.step
3.15 x 3.15 x 0.993 mm
