Brik81/SYMPHONY_BRIDGE/SYMPHONY_V2/DESIGN/SYMPHONY_V2/UHF_LIB/3D/QFN_6DSLTR_STM.step

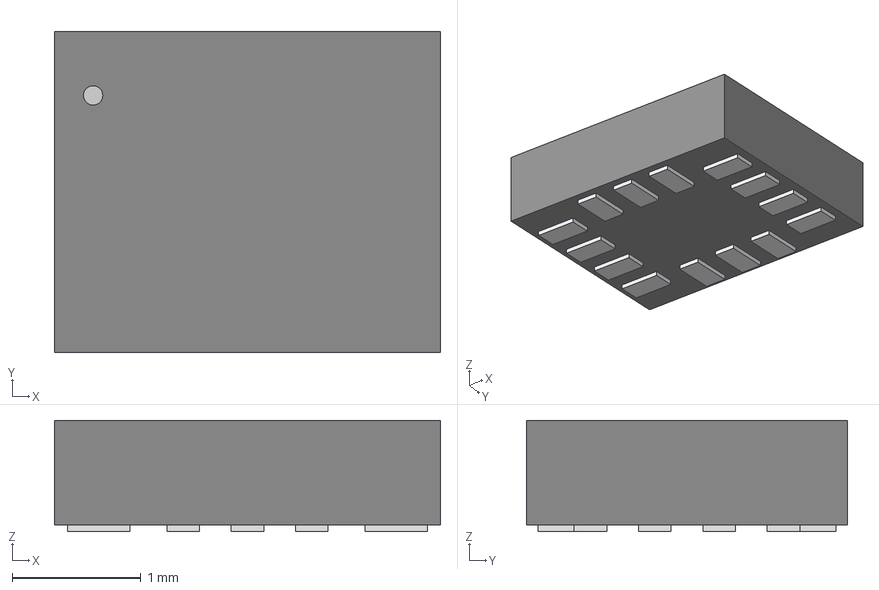
[picture p24: CAD file, 2026-11-04]
SYMPHONY_V2/DESIGN/SYMPHONY_V2/UHF_LIB/3D/QFN_6DSLTR_STM.step
3.00 x 2.49 x 0.866 mm
