Brik81/SYMPHONY_BRIDGE/SYMPHONY_V2/DESIGN/SYMPHONY_V2_CLAUDE_PCB/UHF_LIB/3D/QPA9510TR7.stp

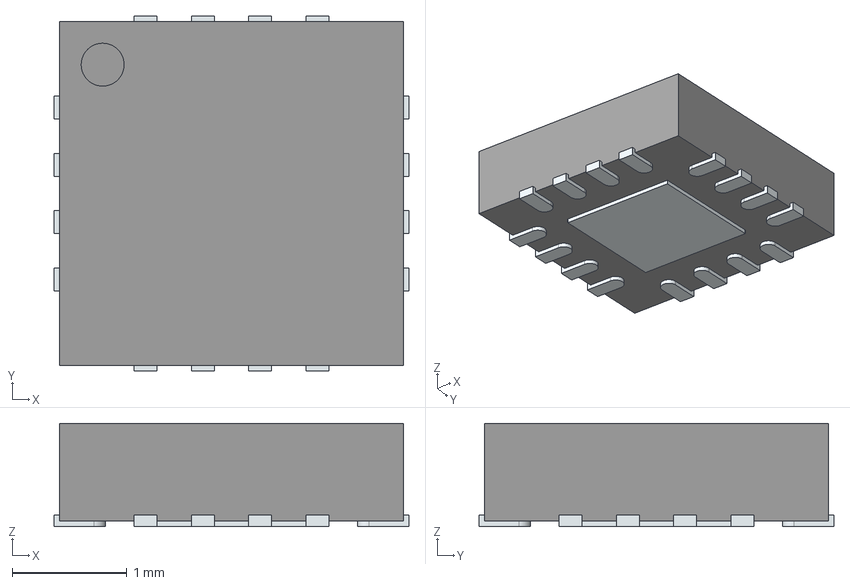
[picture p25: CAD file, 2026-11-10]
SYMPHONY_V2/DESIGN/SYMPHONY_V2_CLAUDE_PCB/UHF_LIB/3D/QPA9510TR7.stp
3.10 x 3.10 x 0.9 mm
ThermalPin
PinsArrayLR
PinsArrayTB
