Brik81/SYMPHONY_BRIDGE/SYMPHONY_V2/DESIGN/SYMPHONY_V2_CLAUDE_PCB/UHF_LIB/3D/FSI-110-03-G-D-AD.stp

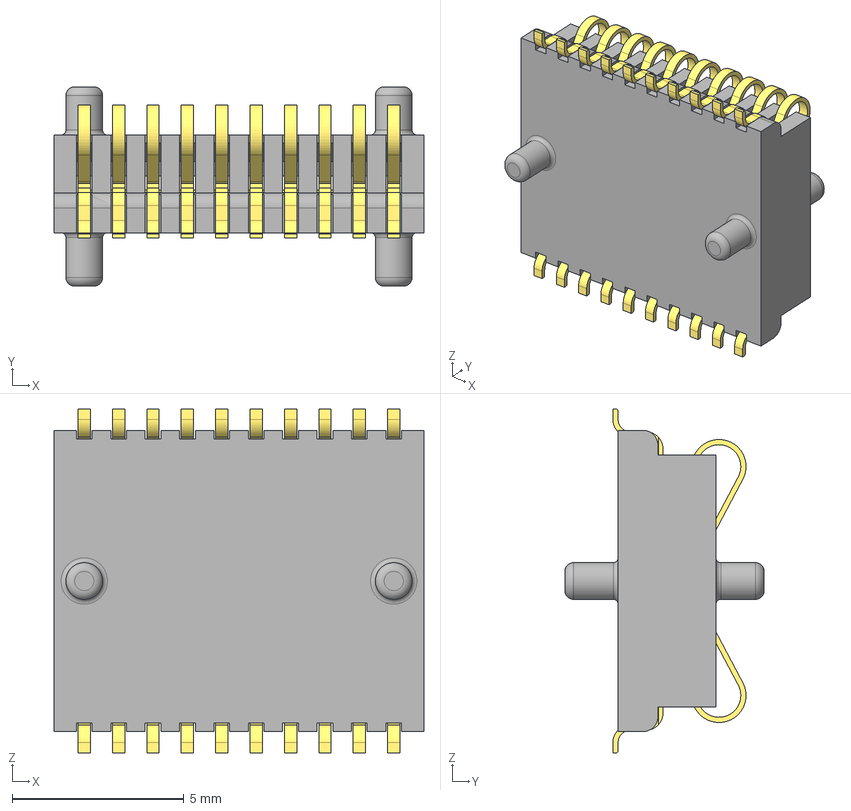
[picture p26: CAD file, 2026-11-10]
SYMPHONY_V2/DESIGN/SYMPHONY_V2_CLAUDE_PCB/UHF_LIB/3D/FSI-110-03-G-D-AD.stp
10.8 x 5.80 x 10.0 mm
FSI-110-03-G-D-AD_terminal
FSI-110-03-G-D_pin x 2
FSI-110-03-G-D_PIN2 x 2
