Brik81/SYMPHONY_BRIDGE/SYMPHONY_V2/DESIGN/SYMPHONY_V2_CLAUDE_PCB/UHF_LIB/3D/HMC784AMS8GE.stp

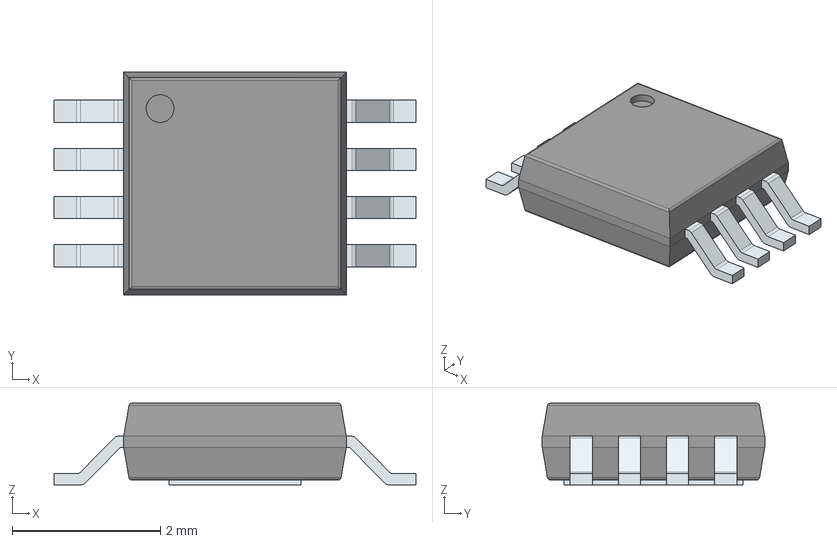
[picture p27: CAD file, 2026-11-10]
SYMPHONY_V2/DESIGN/SYMPHONY_V2_CLAUDE_PCB/UHF_LIB/3D/HMC784AMS8GE.stp
4.88 x 3.00 x 1.10 mm
PinsArrayLR
ThermalPad
