Brik81/SYMPHONY_BRIDGE/SYMPHONY_V2/DESIGN/SYMPHONY_V2_CLAUDE_PCB/UHF_LIB/3D/HMC349AMS8GE.stp

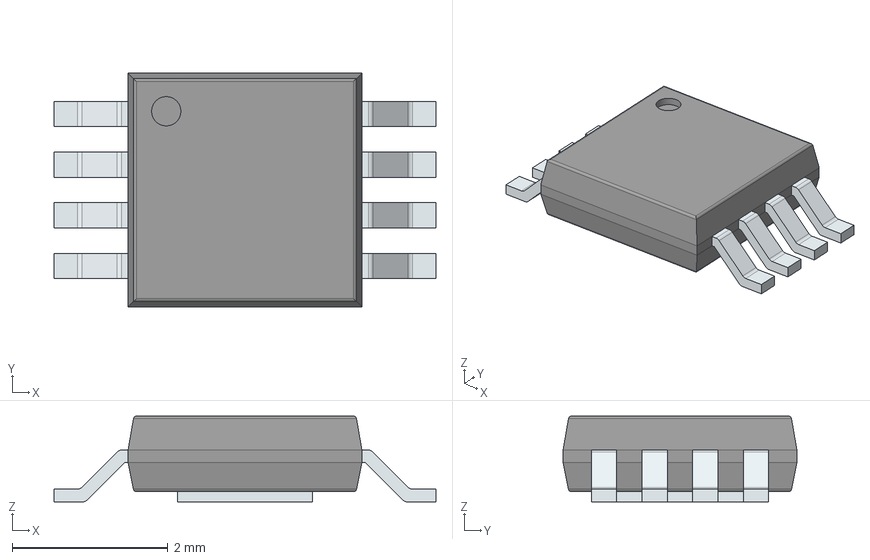
[picture p28: CAD file, 2026-11-10]
SYMPHONY_V2/DESIGN/SYMPHONY_V2_CLAUDE_PCB/UHF_LIB/3D/HMC349AMS8GE.stp
4.90 x 3.00 x 1.10 mm
PinsArrayLR
ThermalPad
