Brik81/SYMPHONY_BRIDGE/SYMPHONY_V2/DESIGN/SYMPHONY_V2_CLAUDE_PCB/UHF_LIB/3D/DFN8_3x3MC_MCH.step

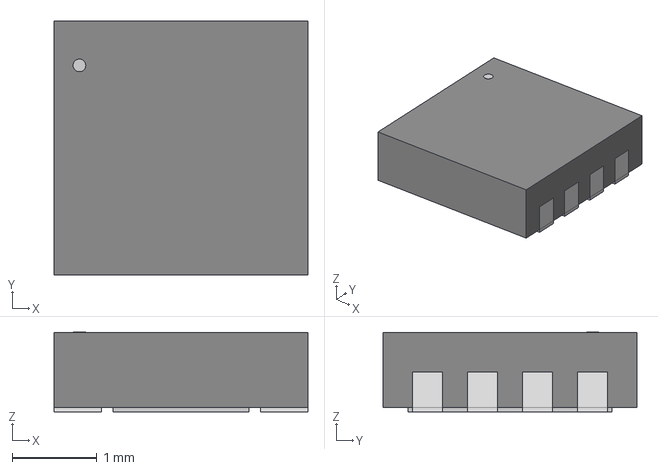
[picture p29: CAD file, 2026-11-10]
SYMPHONY_V2/DESIGN/SYMPHONY_V2_CLAUDE_PCB/UHF_LIB/3D/DFN8_3x3MC_MCH.step
3.00 x 3.00 x 0.942 mm
