Brik81/SYMPHONY_BRIDGE/(list of files, cad)

Other CAD files:
SYMPHONY_V2/DESIGN/SYMPHONY_V2/UHF_LIB/.ZIP_FILE/CX2016DB24000D0FLJC6/Allegro/cx2016db32000d0wzrc1.psm
SYMPHONY_V2/DESIGN/SYMPHONY_V2/UHF_LIB/.ZIP_FILE/CX2016DB24000D0FLJC6/DEHDL/cx2016db24000d0fljc6/chips/chips.prt
SYMPHONY_V2/DESIGN/SYMPHONY_V2/UHF_LIB/.ZIP_FILE/FM25V10-G/Allegro/soic127p602x173-8n.psm
SYMPHONY_V2/DESIGN/SYMPHONY_V2/UHF_LIB/.ZIP_FILE/FM25V10-G/DEHDL/fm25v10_g/chips/chips.prt
SYMPHONY_V2/DESIGN/SYMPHONY_V2/UHF_LIB/.ZIP_FILE/G125-MH11605M4P/DEHDL/g125_mh11605m4p/chips/chips.prt
SYMPHONY_V2/DESIGN/SYMPHONY_V2/UHF_LIB/.ZIP_FILE/LFCG-490+/Allegro/lfcg490.psm
SYMPHONY_V2/DESIGN/SYMPHONY_V2/UHF_LIB/.ZIP_FILE/M80-6661242/DEHDL/m80_6661242/chips/chips.prt
SYMPHONY_V2/DESIGN/SYMPHONY_V2/UHF_LIB/.ZIP_FILE/SI4464-B1B-FMR/Allegro/qfn50p400x400x90-21n-d.psm
SYMPHONY_V2/DESIGN/SYMPHONY_V2/UHF_LIB/.ZIP_FILE/SPIRIT1QTR/Allegro/qfn55p400x400x100-21n-d.psm
SYMPHONY_V2/DESIGN/SYMPHONY_V2/UHF_LIB/.ZIP_FILE/TCAN3414DR/DEHDL/tcan3414dr/chips/chips.prt
SYMPHONY_V2/DESIGN/SYMPHONY_V2/UHF_LIB/3D/5040500991.stp
SYMPHONY_V2/DESIGN/SYMPHONY_V2_BACKUP_ORIGINALE_10_11/UHF_LIB/.ZIP_FILE/504050-0891/3D/504050-0891.stp
SYMPHONY_V2/DESIGN/SYMPHONY_V2_BACKUP_ORIGINALE_10_11/UHF_LIB/.ZIP_FILE/ECS-TXO-20CSMV4-320-AY-TR/Allegro/ecstxo20csmv4320aytr.psm
SYMPHONY_V2/DESIGN/SYMPHONY_V2_BACKUP_ORIGINALE_10_11/UHF_LIB/.ZIP_FILE/GRF5604/DEHDL/grf5604/chips/chips.prt
SYMPHONY_V2/DESIGN/SYMPHONY_V2_BACKUP_ORIGINALE_10_11/UHF_LIB/.ZIP_FILE/HMC349AMS8GE/DEHDL/hmc349ams8ge/chips/chips.prt
SYMPHONY_V2/DESIGN/SYMPHONY_V2_BACKUP_ORIGINALE_10_11/UHF_LIB/.ZIP_FILE/HMC784AMS8GE/DEHDL/hmc784ams8ge/chips/chips.prt
SYMPHONY_V2/DESIGN/SYMPHONY_V2_BACKUP_ORIGINALE_10_11/UHF_LIB/.ZIP_FILE/M41T82ZM6F/DEHDL/m41t82zm6f/chips/chips.prt
SYMPHONY_V2/DESIGN/SYMPHONY_V2_BACKUP_ORIGINALE_10_11/UHF_LIB/.ZIP_FILE/M80-6661242/Allegro/m80-66612yy.psm
SYMPHONY_V2/DESIGN/SYMPHONY_V2_BACKUP_ORIGINALE_10_11/UHF_LIB/.ZIP_FILE/SN74AHC1G04DBVRE4/Allegro/sot95p280x145-5n.psm
SYMPHONY_V2/DESIGN/SYMPHONY_V2_BACKUP_ORIGINALE_10_11/UHF_LIB/.ZIP_FILE/SPIRIT1QTR/DEHDL/spirit1qtr/chips/chips.prt
SYMPHONY_V2/DESIGN/SYMPHONY_V2_BACKUP_ORIGINALE_10_11/UHF_LIB/.ZIP_FILE/STM32H753VIT6/DEHDL/stm32h753vit6/chips/chips.prt
SYMPHONY_V2/DESIGN/SYMPHONY_V2_BACKUP_ORIGINALE_10_11/UHF_LIB/.ZIP_FILE/TCM1-63AX+/Allegro/tcm163ax.psm
SYMPHONY_V2/DESIGN/SYMPHONY_V2_BACKUP_ORIGINALE_10_11/UHF_LIB/.ZIP_FILE/TCM1-63AX+/DEHDL/tcm1_63ax_/chips/chips.prt
SYMPHONY_V2/DESIGN/SYMPHONY_V2_BACKUP_ORIGINALE_10_11/UHF_LIB/.ZIP_FILE/TPS7A2030PDBVRG4/DEHDL/tps7a2030pdbvrg4/chips/chips.prt
SYMPHONY_V2/DESIGN/SYMPHONY_V2_BACKUP_ORIGINALE_10_11/UHF_LIB/.ZIP_FILE/TQP3M9036/Allegro/son50p200x200x95-9n-d.psm
SYMPHONY_V2/DESIGN/SYMPHONY_V2_BACKUP_ORIGINALE_10_11/UHF_LIB/.ZIP_FILE/TQP3M9036/DEHDL/tqp3m9036/chips/chips.prt
SYMPHONY_V2/DESIGN/SYMPHONY_V2_BACKUP_ORIGINALE_10_11/UHF_LIB/3D/5040500691.stp
SYMPHONY_V2/DESIGN/SYMPHONY_V2_CLAUDE_PCB/UHF_LIB/.ZIP_FILE/504050-0891/Allegro/5040500891.psm
SYMPHONY_V2/DESIGN/SYMPHONY_V2_CLAUDE_PCB/UHF_LIB/.ZIP_FILE/504050-0891/DEHDL/504050_0891/chips/chips.prt
SYMPHONY_V2/DESIGN/SYMPHONY_V2_CLAUDE_PCB/UHF_LIB/.ZIP_FILE/830069390/Allegro/830069390.psm
SYMPHONY_V2/DESIGN/SYMPHONY_V2_CLAUDE_PCB/UHF_LIB/.ZIP_FILE/830069390/DEHDL/830069390/chips/chips.prt
SYMPHONY_V2/DESIGN/SYMPHONY_V2_CLAUDE_PCB/UHF_LIB/.ZIP_FILE/ECS-TXO-20CSMV4-320-AY-TR/DEHDL/ecs_txo_20csmv4_320_ay_tr/chips/chips.prt
SYMPHONY_V2/DESIGN/SYMPHONY_V2_CLAUDE_PCB/UHF_LIB/.ZIP_FILE/LD39200PU33R/DEHDL/ld39200pu33r/chips/chips.prt
SYMPHONY_V2/DESIGN/SYMPHONY_V2_CLAUDE_PCB/UHF_LIB/.ZIP_FILE/S2-LPCBQTR/Allegro/qfn50p400x400x105-25n-d.psm
SYMPHONY_V2/DESIGN/SYMPHONY_V2_CLAUDE_PCB/UHF_LIB/.ZIP_FILE/S2-LPCBQTR/DEHDL/s2_lpcbqtr/chips/chips.prt
SYMPHONY_V2/DESIGN/SYMPHONY_V2_CLAUDE_PCB/UHF_LIB/.ZIP_FILE/SN74AHC1G04DBVRE4/DEHDL/sn74ahc1g04dbvre4/chips/chips.prt
SYMPHONY_V2/DESIGN/SYMPHONY_V2_CLAUDE_PCB/UHF_LIB/.ZIP_FILE/STM32H753VIT6/Allegro/qfp50p1600x1600x160-100n.psm
SYMPHONY_V2/DESIGN/SYMPHONY_V2_CLAUDE_PCB/UHF_LIB/.ZIP_FILE/TPS259474LRPWR/DEHDL/tps259474lrpwr/chips/chips.prt
SYMPHONY_V2/DESIGN/SYMPHONY_V2_CLAUDE_PCB/UHF_LIB/.ZIP_FILE/TQP7M9106/DEHDL/tqp7m9106/chips/chips.prt
SYMPHONY_V2/DESIGN/SYMPHONY_V2_CLAUDE_PCB/UHF_LIB/3D/5033981892.stp
SYMPHONY_V2/DESIGN/SYMPHONY_V2_CLAUDE_PCB/UHF_LIB/3D/5040501291.stp
SYMPHONY_V2/DESIGN/SYNPHONY/SINFONY/UHF_LIB/.ZIP_FILE/GRF5604/Allegro/qfn50p300x300x90-17n.psm
SYMPHONY_V2/DESIGN/SYNPHONY/SINFONY/UHF_LIB/.ZIP_FILE/HMC349AMS8GE/Allegro/sop65p490x110-9n.psm
SYMPHONY_V2/DESIGN/SYNPHONY/SINFONY/UHF_LIB/.ZIP_FILE/HMC784AMS8GE/Allegro/sop65p488x110-9n.psm
SYMPHONY_V2/DESIGN/SYNPHONY/SINFONY/UHF_LIB/.ZIP_FILE/LD39200PU33R/Allegro/son95p300x300x100-7n-d.psm
SYMPHONY_V2/DESIGN/SYNPHONY/SINFONY/UHF_LIB/.ZIP_FILE/LFCG-490+/DEHDL/lfcg_490_/chips/chips.prt
SYMPHONY_V2/DESIGN/SYNPHONY/SINFONY/UHF_LIB/.ZIP_FILE/M41T82ZM6F/Allegro/soic127p600x175-8n.psm
SYMPHONY_V2/DESIGN/SYNPHONY/SINFONY/UHF_LIB/.ZIP_FILE/SI4464-B1B-FMR/DEHDL/si4464_b1b_fmr/chips/chips.prt
SYMPHONY_V2/DESIGN/SYNPHONY/SINFONY/UHF_LIB/.ZIP_FILE/TPS79650DRBR/Allegro/son65p300x300x100-9n-d.psm
SYMPHONY_V2/DESIGN/SYNPHONY/SINFONY/UHF_LIB/.ZIP_FILE/TPS79650DRBR/DEHDL/tps79650drbr/chips/chips.prt
SYMPHONY_V2/DESIGN/SYNPHONY/SINFONY/UHF_LIB/.ZIP_FILE/TQP7M9106/Allegro/qfn50p400x400x90-25n-d.psm
