Brik81/SYMPHONY_BRIDGE/SYMPHONY_V2/DESIGN/SYMPHONY_V2/docs/firmware_manual/symphony_v2_firmware_manual.tex

% =====================================================================
%  SYMPHONY V2 - Manuale per il firmwarista (Engineering Model)
%  Riferimento: schematico rev. 1.45 del log hardware, 04/11/2026
% =====================================================================
\documentclass[11pt,a4paper,twoside,openany]{report}

% ---------------------------------------------------------------- base
\usepackage[T1]{fontenc}
\usepackage[utf8]{inputenc}
\usepackage[italian]{babel}
\usepackage{libertinus}
\usepackage[scaled=0.84]{beramono}
\usepackage{microtype}
\usepackage[a4paper,inner=26mm,outer=22mm,top=26mm,bottom=26mm,headheight=15pt]{geometry}
\usepackage[table,dvipsnames]{xcolor}
\usepackage{graphicx}
\usepackage{amsmath,amssymb}
\usepackage[autostyle]{csquotes}
\usepackage{enumitem}
\usepackage{pdflscape}
\usepackage{array,booktabs,longtable,xltabular,multirow,makecell}
\usepackage{siunitx}
\usepackage{fancyhdr}
\usepackage{titlesec}
\usepackage{tocloft}
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
\setcounter{secnumdepth}{3}
\setcounter{tocdepth}{1}
\renewcommand{\cftchapfont}{\sffamily\bfseries}
\renewcommand{\cftchappagefont}{\sffamily\bfseries}

% ---------------------------------------------------------------- testatine
\pagestyle{fancy}
\fancyhf{}
\renewcommand{\headrulewidth}{0.4pt}
\renewcommand{\headrule}{\hbox to\headwidth{\color{sbblue2}\leaders\hrule height \headrulewidth\hfill}}
\fancyhead[LE]{\sffamily\small\color{sbgray}SYMPHONY V2 \textbullet{} Manuale per il firmwarista}
\fancyhead[RO]{\sffamily\small\color{sbgray}\nouppercase{\leftmark}}
\fancyfoot[LE,RO]{\sffamily\small\bfseries\color{sbblue}\thepage}
\fancyfoot[RE,LO]{\sffamily\scriptsize\color{sbgray}Engineering Model \textbullet{} schematico rev.\ 1.45 \textbullet{} documento v1.1}
\fancypagestyle{plain}{\fancyhf{}\renewcommand{\headrulewidth}{0pt}%
  \fancyfoot[LE,RO]{\sffamily\small\bfseries\color{sbblue}\thepage}}
\renewcommand{\chaptermark}[1]{\markboth{\thechapter.\ #1}{}}

% ---------------------------------------------------------------- riquadri
\newtcolorbox{attenzione}[1][]{enhanced,breakable,colback=sbredbg,colframe=sbred,
  boxrule=0.9pt,arc=1.5pt,left=7pt,right=7pt,top=4pt,bottom=4pt,
  fonttitle=\sffamily\bfseries\small,coltitle=white,colbacktitle=sbred,
  title={Attenzione\ifx&#1&\else{} \textendash{} #1\fi}}
\newtcolorbox{regola}[1][]{enhanced,breakable,colback=sbgreenbg,colframe=sbgreen,
  boxrule=0.9pt,arc=1.5pt,left=7pt,right=7pt,top=4pt,bottom=4pt,
  fonttitle=\sffamily\bfseries\small,coltitle=white,colbacktitle=sbgreen,
  title={Regola\ifx&#1&\else{} \textendash{} #1\fi}}
\newtcolorbox{nota}[1][]{enhanced,breakable,colback=sbgraybg,colframe=sbgray,
  boxrule=0.6pt,arc=1.5pt,left=7pt,right=7pt,top=4pt,bottom=4pt,
  fonttitle=\sffamily\bfseries\small,coltitle=white,colbacktitle=sbgray,
  title={Nota\ifx&#1&\else{} \textendash{} #1\fi}}
\newtcolorbox{verifica}[1][]{enhanced,breakable,colback=sborangebg,colframe=sborange,
  boxrule=0.6pt,arc=1.5pt,left=7pt,right=7pt,top=4pt,bottom=4pt,
  fonttitle=\sffamily\bfseries\small,coltitle=white,colbacktitle=sborange,
  title={Da verificare\ifx&#1&\else{} \textendash{} #1\fi}}

% ---------------------------------------------------------------- macro
\newcommand{\net}[1]{\texttt{#1}}
\newcommand{\code}[1]{\texttt{#1}}
\newcommand{\fonte}[1]{\leavevmode{\footnotesize\color{sbgray}[#1]}}
\newcommand{\DV}{\textcolor{sborange}{\sffamily\bfseries\footnotesize da verificare}}
\newcommand{\Fid}[1]{\textbf{\textcolor{sbgreen}{#1}}}
\newcommand{\tabhead}{\rowcolor{sbblue}}
\newcommand{\hd}[1]{\textcolor{white}{\sffamily\bfseries\footnotesize #1}}
\newcolumntype{L}[1]{>{\raggedright\arraybackslash}p{#1}}
\newcolumntype{C}[1]{>{\centering\arraybackslash}p{#1}}
\newcolumntype{Y}{>{\raggedright\arraybackslash}X}
\setlength{\tabcolsep}{4pt}
\renewcommand{\arraystretch}{1.18}
\captionsetup{font={small,sf},labelfont={bf,color=sbblue},labelsep=period}
\setlist{itemsep=2pt,topsep=4pt}
\setlength{\parindent}{0pt}
\setlength{\parskip}{4pt plus 1pt}
\tikzset{timing/.style={x=3.2ex,y=2ex},
  blk/.style={draw=sbblue,thick,fill=sblight,rounded corners=2pt,align=center,
     font=\sffamily\footnotesize,minimum height=9mm,inner sep=3pt},
  blkr/.style={blk,draw=sbred,fill=sbredbg},
  blkg/.style={blk,draw=sbgreen,fill=sbgreenbg},
  blko/.style={blk,draw=sborange,fill=sborangebg}}
\tikzset{timing/rowdist=3.2ex}
% figure: niente pagine con una figura sola
\renewcommand{\topfraction}{0.9}\renewcommand{\bottomfraction}{0.8}
\renewcommand{\textfraction}{0.07}\renewcommand{\floatpagefraction}{0.75}
\setcounter{topnumber}{3}\setcounter{totalnumber}{4}
% riquadro "In parole semplici"
\newtcolorbox{semplice}[1][]{enhanced,breakable,colback=sblight,colframe=sbblue,
  boxrule=0.6pt,arc=1.5pt,left=7pt,right=7pt,top=4pt,bottom=4pt,
  fonttitle=\sffamily\bfseries\small,coltitle=white,colbacktitle=sbblue,
  title={In parole semplici\ifx&#1&\else{} \textendash{} #1\fi}}

\begin{document}
\pagenumbering{roman}
\input{chapters/00_frontespizio}
\tableofcontents
\cleardoublepage
\pagenumbering{arabic}
\input{chapters/01_introduzione}
\input{chapters/02_sistema}
\input{chapters/03_alimentazione}
\input{chapters/04_pinmap}
\input{chapters/05_periferiche}
\input{chapters/06_rf}
\input{chapters/07_supervisione}
\input{chapters/08_led_debug}
\input{chapters/09_note_firmware}
\appendix
\input{chapters/10_appendici}
\end{document}
