Brik81/SYMPHONY_BRIDGE/(list of files, drawings)

Other design files:
SYMPHONY_V2/DESIGN/SYMPHONY_V2/UHF_LIB/.ZIP_FILE/830069390/Altium/830069390.SchLib
SYMPHONY_V2/DESIGN/SYMPHONY_V2/UHF_LIB/.ZIP_FILE/ESQ-126-39-G-D/Altium/ESQ-126-39-G-D.SchLib
SYMPHONY_V2/DESIGN/SYMPHONY_V2/UHF_LIB/.ZIP_FILE/HMC784AMS8GE/Altium/HMC784AMS8GE.SchLib
SYMPHONY_V2/DESIGN/SYMPHONY_V2/UHF_LIB/.ZIP_FILE/LD39200PU33R/Altium/SON95P300X300X100-7N-D.PcbLib
SYMPHONY_V2/DESIGN/SYMPHONY_V2/UHF_LIB/.ZIP_FILE/S2-LPCBQTR/Altium/S2-LPCBQTR.SchLib
SYMPHONY_V2/DESIGN/SYMPHONY_V2/UHF_LIB/.ZIP_FILE/SI4464-B1B-FMR/Altium/SI4464-B1B-FMR.SchLib
SYMPHONY_V2/DESIGN/SYMPHONY_V2/UHF_LIB/.ZIP_FILE/STM32H753VIT6/Altium/STM32H753VIT6.SchLib
SYMPHONY_V2/DESIGN/SYMPHONY_V2/UHF_LIB/.ZIP_FILE/TCM1-63AX+/Altium/TCM1-63AX+.SchLib
SYMPHONY_V2/DESIGN/SYMPHONY_V2/UHF_LIB/.ZIP_FILE/TQP3M9036/Altium/SON50P200X200X95-9N-D.PcbLib
SYMPHONY_V2/DESIGN/SYMPHONY_V2_BACKUP_ORIGINALE_10_11/UHF_LIB/.ZIP_FILE/ECS-TXO-20CSMV4-320-AY-TR/Altium/ECSTXO20CSMV4320AYTR.PcbLib
SYMPHONY_V2/DESIGN/SYMPHONY_V2_BACKUP_ORIGINALE_10_11/UHF_LIB/.ZIP_FILE/FM25V10-G/Altium/SOIC127P602X173-8N.PcbLib
SYMPHONY_V2/DESIGN/SYMPHONY_V2_BACKUP_ORIGINALE_10_11/UHF_LIB/.ZIP_FILE/GRF5604/Altium/QFN50P300X300X90-17N.PcbLib
SYMPHONY_V2/DESIGN/SYMPHONY_V2_BACKUP_ORIGINALE_10_11/UHF_LIB/.ZIP_FILE/HMC784AMS8GE/Altium/SOP65P488X110-9N.PcbLib
SYMPHONY_V2/DESIGN/SYMPHONY_V2_BACKUP_ORIGINALE_10_11/UHF_LIB/.ZIP_FILE/LD39200PU33R/Altium/LD39200PU33R.SchLib
SYMPHONY_V2/DESIGN/SYMPHONY_V2_BACKUP_ORIGINALE_10_11/UHF_LIB/.ZIP_FILE/S2-LPCBQTR/Altium/QFN50P400X400X105-25N-D.PcbLib
SYMPHONY_V2/DESIGN/SYMPHONY_V2_BACKUP_ORIGINALE_10_11/UHF_LIB/.ZIP_FILE/SI4464-B1B-FMR/Altium/QFN50P400X400X90-21N-D.PcbLib
SYMPHONY_V2/DESIGN/SYMPHONY_V2_BACKUP_ORIGINALE_10_11/UHF_LIB/.ZIP_FILE/SN74AHC1G04DBVRE4/Altium/SN74AHC1G04DBVRE4.SchLib
SYMPHONY_V2/DESIGN/SYMPHONY_V2_BACKUP_ORIGINALE_10_11/UHF_LIB/.ZIP_FILE/STM32H753VIT6/Altium/QFP50P1600X1600X160-100N.PcbLib
SYMPHONY_V2/DESIGN/SYMPHONY_V2_BACKUP_ORIGINALE_10_11/UHF_LIB/.ZIP_FILE/TCAN3414DR/Altium/SOIC127P600X175-8N.PcbLib
SYMPHONY_V2/DESIGN/SYMPHONY_V2_BACKUP_ORIGINALE_10_11/UHF_LIB/.ZIP_FILE/TCM1-63AX+/Altium/TCM163AX.PcbLib
SYMPHONY_V2/DESIGN/SYMPHONY_V2_BACKUP_ORIGINALE_10_11/UHF_LIB/.ZIP_FILE/TPS7A2030PDBVRG4/Altium/TPS7A2030PDBVRG4.SchLib
SYMPHONY_V2/DESIGN/SYMPHONY_V2_BACKUP_ORIGINALE_10_11/UHF_LIB/.ZIP_FILE/TPS79650DRBR/Altium/TPS79650DRBR.SchLib
SYMPHONY_V2/DESIGN/SYMPHONY_V2_BACKUP_ORIGINALE_10_11/UHF_LIB/.ZIP_FILE/TQP3M9036/Altium/TQP3M9036.SchLib
SYMPHONY_V2/DESIGN/SYMPHONY_V2_CLAUDE_PCB/UHF_LIB/.ZIP_FILE/830069390/Altium/830069390.PcbLib
SYMPHONY_V2/DESIGN/SYMPHONY_V2_CLAUDE_PCB/UHF_LIB/.ZIP_FILE/ECS-TXO-20CSMV4-320-AY-TR/Altium/ECS-TXO-20CSMV4-320-AY-TR.SchLib
SYMPHONY_V2/DESIGN/SYMPHONY_V2_CLAUDE_PCB/UHF_LIB/.ZIP_FILE/ESQ-126-39-G-D/Altium/ESQ-126-Y-X-D.PcbLib
SYMPHONY_V2/DESIGN/SYMPHONY_V2_CLAUDE_PCB/UHF_LIB/.ZIP_FILE/HMC349AMS8GE/Altium/HMC349AMS8GE.SchLib
SYMPHONY_V2/DESIGN/SYMPHONY_V2_CLAUDE_PCB/UHF_LIB/.ZIP_FILE/HMC349AMS8GE/Altium/SOP65P490X110-9N.PcbLib
SYMPHONY_V2/DESIGN/SYMPHONY_V2_CLAUDE_PCB/UHF_LIB/.ZIP_FILE/LFCG-490+/Altium/LFCG490.PcbLib
SYMPHONY_V2/DESIGN/SYMPHONY_V2_CLAUDE_PCB/UHF_LIB/.ZIP_FILE/LFCG-490+/Altium/LFCG-490+.SchLib
SYMPHONY_V2/DESIGN/SYMPHONY_V2_CLAUDE_PCB/UHF_LIB/.ZIP_FILE/M41T82ZM6F/Altium/M41T82ZM6F.SchLib
SYMPHONY_V2/DESIGN/SYMPHONY_V2_CLAUDE_PCB/UHF_LIB/.ZIP_FILE/M41T82ZM6F/Altium/SOIC127P600X175-8N.PcbLib
SYMPHONY_V2/DESIGN/SYMPHONY_V2_CLAUDE_PCB/UHF_LIB/.ZIP_FILE/SN74AHC1G04DBVRE4/Altium/SOT95P280X145-5N.PcbLib
SYMPHONY_V2/DESIGN/SYMPHONY_V2_CLAUDE_PCB/UHF_LIB/.ZIP_FILE/TCAN3414DR/Altium/TCAN3414DR.SchLib
SYMPHONY_V2/DESIGN/SYMPHONY_V2_CLAUDE_PCB/UHF_LIB/.ZIP_FILE/TQP7M9106/Altium/QFN50P400X400X90-25N-D.PcbLib
SYMPHONY_V2/DESIGN/SYMPHONY_V2_CLAUDE_PCB/UHF_LIB/.ZIP_FILE/TQP7M9106/Altium/TQP7M9106.SchLib
SYMPHONY_V2/DESIGN/SYNPHONY/SINFONY/UHF_LIB/.ZIP_FILE/FM25V10-G/Altium/FM25V10-G.SchLib
SYMPHONY_V2/DESIGN/SYNPHONY/SINFONY/UHF_LIB/.ZIP_FILE/GRF5604/Altium/GRF5604.SchLib
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
