Brik81/SYMPHONY_BRIDGE/SYMPHONY_V2/DESIGN/SYMPHONY_V2_CLAUDE_PCB/SYMPHONY.kicad_pcb

## KiCad design SYMPHONY_V2/DESIGN/SYMPHONY_V2_CLAUDE_PCB/SYMPHONY.kicad_pcb (2026-11-10)

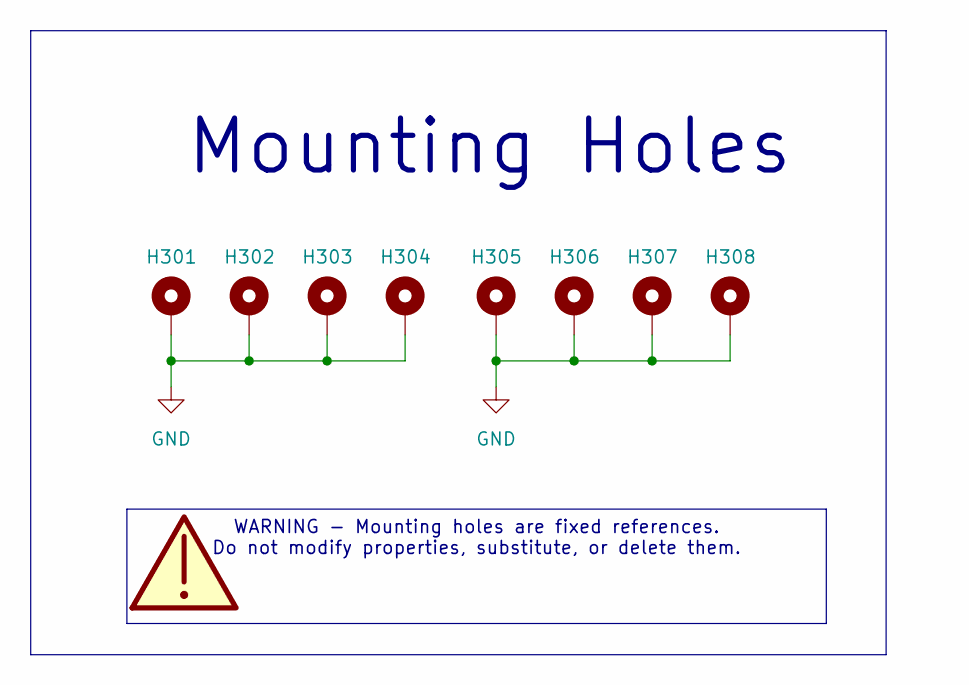
[picture p52: schematic MOUNTING_HOLES.kicad_sch, SYMPHONY]

Parts:
H301, H302, H303, H304, H305, H306, H307, H308: MountingHole_Pad; MountingHole_2.2mm_M2_DIN965_Pad

Connections:
GND: H301.1 (1_1), H302.1 (1_1), H303.1 (1_1), H304.1 (1_1), H305.1 (1_1), H306.1 (1_1), H307.1 (1_1), H308.1 (1_1); also elsewhere on the board

Notes on the sheet:
Mounting Holes
WARNING - Mounting holes are fixed references. Do not modify properties, substitute, or delete them.

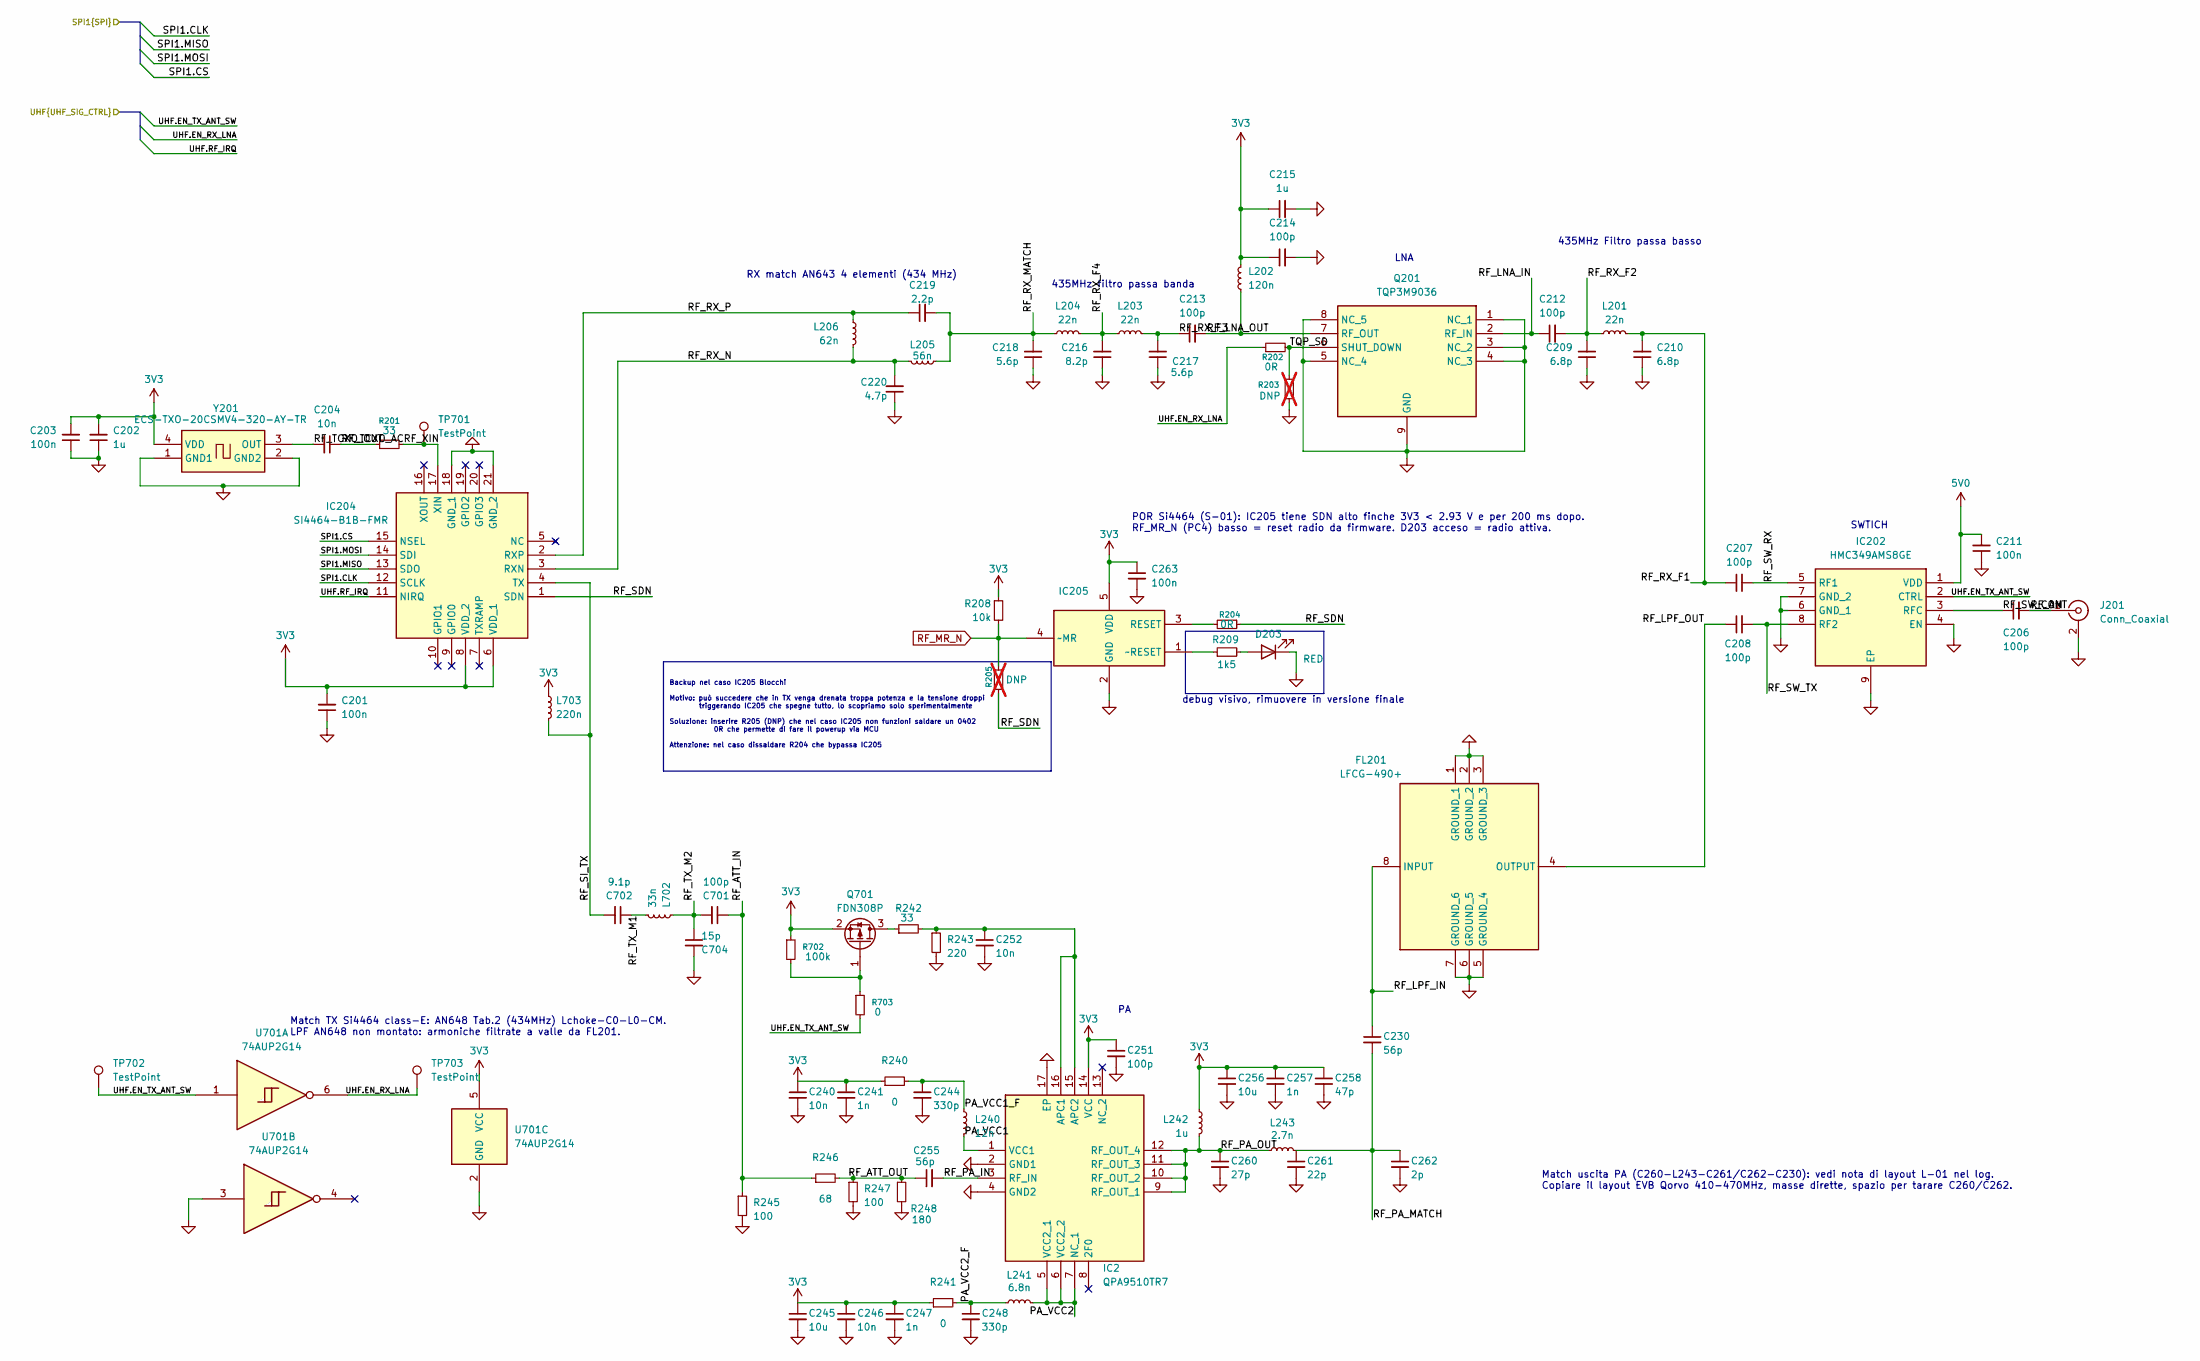
[picture p53: schematic UHF.kicad_sch, SYMPHONY]

Parts:
C201, C203, C211, C263: 100n; C_0402_1005Metric; JLCPCB Parts C77014
C202, C215: 1u; C_0402_1005Metric; JLCPCB Parts C77009
C204: 10n; C_0402_1005Metric; JLCPCB Parts C77013
C206, C207, C208, C212, C213, C701: 100p; C_0603_1608Metric; JLCPCB Parts C17308632
C209, C210: 6.8p; C_0805_2012Metric; JLCPCB Parts C464958
C214: 100p; C_0402_1005Metric; JLCPCB Parts C77177
C216: 8.2p; C_0805_2012Metric; JLCPCB Parts C668333
C217, C218: 5.6p; C_0603_1608Metric; JLCPCB Parts C2297617
C219: 2.2p; C_0603_1608Metric; JLCPCB Parts C2179335
C220: 4.7p; C_0805_2012Metric; JLCPCB Parts C5646702
C230, C255: 56p; C_0603_1608Metric; JLCPCB Parts C237591
C240, C246, C252: 10n; C_0402_1005Metric_Pad0.74x0.62mm_HandSolder; JLCPCB Parts C77013
C241, C247, C257: 1n; C_0402_1005Metric_Pad0.74x0.62mm_HandSolder; JLCPCB Parts C76947
C244, C248: 330p; C_0402_1005Metric_Pad0.74x0.62mm_HandSolder; JLCPCB Parts C76965
C245, C256: 10u; C_0805_2012Metric_Pad1.18x1.45mm_HandSolder; JLCPCB Parts C84416
C251: 100p; C_0402_1005Metric_Pad0.74x0.62mm_HandSolder; JLCPCB Parts C77177
C258: 47p; C_0402_1005Metric_Pad0.74x0.62mm_HandSolder; JLCPCB Parts C76970
C260: 27p; C_0603_1608Metric; JLCPCB Parts C2360423
C261: 22p; C_0402_1005Metric; JLCPCB Parts C882567
C262: 2p; C_0402_1005Metric; JLCPCB Parts C161316
C702: 9.1p; C_0402_1005Metric; JLCPCB Parts C497527
C704: 15p; C_0402_1005Metric; JLCPCB Parts C441742
D203: RED; LED_0402_1005Metric; JLCPCB Parts C130719
FL201: LFCG-490+; LFCG490; Mouser Part Number 139-LFCG-490+
IC2: QPA9510TR7; QFN50P300X300X90-17N-D; Manufacturer_Part_Number QPA9510TR7; JLCPCB Parts C52059849
IC202: HMC349AMS8GE; SOP65P490X110-9N; Mouser Part Number 584-HMC349AMS8GE
IC204: SI4464-B1B-FMR; QFN50P400X400X90-21N-D; Mouser Part Number 634-SI4464-B1X-FMR
IC205: TPS3825-33DBVR; SOT95P280X145-5N; Manufacturer_Part_Number TPS3825-33DBVR; JLCPCB Parts C473344
J201: Conn_Coaxial; MMCX_Molex_73415-0961_Horizontal_0.8mm-PCB; JLCPCB Parts C2999837
L201, L203, L204: 22n; L_0805_2012Metric; JLCPCB Parts C2042193
L202: 120n; L_0402_1005Metric_Pad0.77x0.64mm_HandSolder; JLCPCB Parts C113123
L205: 56n; L_0603_1608Metric; JLCPCB Parts C98079
L206: 62n; L_0603_1608Metric; JLCPCB Parts C162649
L240: 12n; L_0603_1608Metric_Pad1.05x0.95mm_HandSolder; JLCPCB Parts C98068
L241: 6.8n; L_0402_1005Metric_Pad0.77x0.64mm_HandSolder; JLCPCB Parts C882467
L242: 1u; L_Taiyo-Yuden_NR-20xx; Manufacturer_Part_Number NRS2012T1R0NGJV; Mouser Part Number 963-NRS2012T1R0NGJV
L243: 2.7n; L_0402_1005Metric; JLCPCB Parts C412269
L702: 33n; L_0805_2012Metric; JLCPCB Parts C1330869
L703: 220n; L_0603_1608Metric; JLCPCB Parts C2046586
Q201: TQP3M9036; SON50P200X200X95-9N-D; Mouser Part Number 772-TQP3M9036
Q701: FDN308P; SOT-23; JLCPCB Parts C7472857
R201: 33; R_0402_1005Metric; JLCPCB Parts C25105
R202, R204: 0R; R_0402_1005Metric; JLCPCB Parts C17168
R203: DNP; R_0402_1005Metric; JLCPCB Parts C71617; not fitted
R205: DNP; R_0402_1005Metric; JLCPCB Parts C17168; not fitted
R208: 10k; R_0402_1005Metric; JLCPCB Parts C71617
R209: 1k5; R_0402_1005Metric; JLCPCB Parts C25867
R240: 0; R_0402_1005Metric_Pad0.72x0.64mm_HandSolder; JLCPCB Parts C17168
R241: 0; R_0603_1608Metric_Pad0.98x0.95mm_HandSolder; JLCPCB Parts C21189
R242: 33; R_0402_1005Metric_Pad0.72x0.64mm_HandSolder; JLCPCB Parts C25105
R243: 220; R_0402_1005Metric_Pad0.72x0.64mm_HandSolder; JLCPCB Parts C25091
R245: 100; R_0603_1608Metric; JLCPCB Parts C22775
R246: 68; R_0603_1608Metric; JLCPCB Parts C27592
R247: 100; R_0402_1005Metric; JLCPCB Parts C25076
R248: 180; R_0402_1005Metric; JLCPCB Parts C38941
R702: 100k; R_0402_1005Metric; JLCPCB Parts C60491
R703: 0; R_0402_1005Metric; JLCPCB Parts C17168
TP701, TP702, TP703: TestPoint; TestPoint_Pad_D1.0mm
U701: 74AUP2G14; SOT-363_SC-70-6; JLCPCB Parts C526337
Y201: ECS-TXO-20CSMV4-320-AY-TR; ECSTXO20CSMV4320AYTR; Manufacturer_Part_Number ECS-TXO-20CSMV4-320-AY-TR; JLCPCB Parts C19858587

Connections:
3V3: C201.2, C202.2, C203.2, C214.1, C215.1, C240.1, C241.1, C245.1, C246.1, C247.1, C251.1, C256.1, C257.1, C258.1, C263.1, IC2.14 (VCC), IC204.6 (VDD_1), IC204.8 (VDD_2), IC205.5 (VDD), L202.2, L242.1, L703.1, Q701.2 (S), R208.1, R240.1, R241.1, R702.1, U701.5 (VCC), Y201.4 (VDD); also elsewhere on the board
5V0: C211.2, IC202.1 (VDD); also elsewhere on the board
/MCU/SPI1.CLK: IC204.12 (SCLK); also elsewhere on the board
/MCU/SPI1.CS: IC204.15 (NSEL); also elsewhere on the board
/MCU/SPI1.MISO: IC204.13 (SDO); also elsewhere on the board
/MCU/SPI1.MOSI: IC204.14 (SDI); also elsewhere on the board
/MCU/UHF.EN_RX_LNA: R202.1, TP703.1 (1_1), U701.6
/MCU/UHF.EN_TX_ANT_SW: IC202.2 (CTRL), R703.2, TP702.1 (1_1), U701.1; also elsewhere on the board
/MCU/UHF.RF_IRQ: IC204.11 (NIRQ); also elsewhere on the board
/UHF/PA_VCC1: IC2.1 (VCC1), L240.2
/UHF/PA_VCC1_F: C244.1, L240.1, R240.2
/UHF/PA_VCC2: IC2.5 (VCC2_1), IC2.6 (VCC2_2), IC2.7 (NC_1), L241.2
/UHF/PA_VCC2_F: C248.1, L241.1, R241.2
/UHF/RF_ANT: C206.2, J201.1 (In)
/UHF/RF_ATT_IN: C701.1, R245.1, R246.1
/UHF/RF_ATT_OUT: C255.1, R246.2, R247.1, R248.1
/UHF/RF_LNA_IN: C212.1, Q201.2 (RF_IN)
/UHF/RF_LNA_OUT: C213.2, L202.1, Q201.7 (RF_OUT)
/UHF/RF_LPF_IN: C230.1, FL201.8 (INPUT)
/UHF/RF_LPF_OUT: C208.1, FL201.4 (OUTPUT)
/UHF/RF_PA_IN: C255.2, IC2.3 (RF_IN)
/UHF/RF_PA_MATCH: C230.2, C261.1, C262.1, L243.2
/UHF/RF_PA_OUT: C260.1, IC2.9 (RF_OUT_1), IC2.10 (RF_OUT_2), IC2.11 (RF_OUT_3), IC2.12 (RF_OUT_4), L242.2, L243.1
/UHF/RF_RX_F1: C207.1, C210.2, L201.2
/UHF/RF_RX_F2: C209.2, C212.2, L201.1
/UHF/RF_RX_F3: C213.1, C217.2, L203.2
/UHF/RF_RX_F4: C216.2, L203.1, L204.2
/UHF/RF_RX_MATCH: C218.2, C219.2, L204.1, L205.2
/UHF/RF_RX_N: C220.2, IC204.3 (RXN), L205.1, L206.2
/UHF/RF_RX_P: C219.1, IC204.2 (RXP), L206.1
/UHF/RF_SDN: IC204.1 (SDN), R204.1, R205.2
/UHF/RF_SI_TX: C702.2, IC204.4 (TX), L703.2
/UHF/RF_SW_COM: C206.1, IC202.3 (RFC)
/UHF/RF_SW_RX: C207.2, IC202.5 (RF1)
/UHF/RF_SW_TX: C208.2, IC202.8 (RF2)
/UHF/RF_TCXO_AC: C204.1, R201.1
/UHF/RF_TCXO_OUT: C204.2, Y201.3 (OUT)
/UHF/RF_TX_M1: C702.1, L702.1
/UHF/RF_TX_M2: C701.2, C704.1, L702.2
/UHF/RF_XIN: IC204.17 (XIN), R201.2, TP701.1 (1_1)
/UHF/TQP_SD: Q201.6 (SHUT_DOWN), R202.2, R203.1
GND: C201.1, C202.1, C203.1, C209.1, C210.1, C211.1, C214.2, C215.2, C216.1, C217.1, C218.1, C220.1, C240.2, C241.2, C244.2, C245.2, C246.2, C247.2, C248.2, C251.2, C252.2, C256.2, C257.2, C258.2, C260.2, C261.2, C262.2, C263.2, C704.2, D203.1 (K), FL201.1 (GROUND_1), FL201.2 (GROUND_2), FL201.3 (GROUND_3), FL201.5 (GROUND_4), FL201.6 (GROUND_5), FL201.7 (GROUND_6), IC2.2 (GND1), IC2.4 (GND2), IC2.17 (EP), IC202.4 (EN), IC202.6 (GND_1), IC202.7 (GND_2), IC202.9 (EP), IC204.18 (GND_1), IC204.21 (GND_2), IC205.2 (GND), J201.2 (Ext), Q201.1 (NC_1), Q201.3 (NC_2), Q201.4 (NC_3), Q201.5 (NC_4), Q201.8 (NC_5), Q201.9 (GND), R203.2, R243.2, R245.2, R247.2, R248.2, U701.2 (GND), U701.3, Y201.1 (GND1), Y201.2 (GND2); also elsewhere on the board
unnamed: D203.2 (A), R209.2
unnamed: C252.1, IC2.15 (APC2), IC2.16 (APC1), R242.2, R243.1
unnamed: IC205.3 (RESET), R204.2
unnamed: IC205.1 (~RESET), R209.1
unnamed: Q701.3 (D), R242.1
unnamed: Q701.1 (G), R702.2, R703.1
RF_MR_N: IC205.4 (~MR), R205.1, R208.2; also elsewhere on the board

Notes on the sheet:
435MHz Filtro passa basso
Match TX Si4464 class-E: AN648 Tab.2 (434MHz) Lchoke-C0-L0-CM. LPF AN648 non montato: armoniche filtrate a valle da FL201.
POR Si4464 (S-01): IC205 tiene SDN alto finche 3V3 < 2.93 V e per 200 ms dopo. RF_MR_N (PC4) basso = reset radio da firmware. D203 acceso = radio attiva.
debug visivo, rimuovere in versione finale
LNA
Backup nel caso IC205 Blocchi Motivo: può succedere che in TX venga drenata troppa potenza e la tensione droppi triggerando IC205 che spegne tutto, lo scopriamo solo sperimentalmente Soluzione: inserire R205 (DNP) che nel caso IC205 non funzioni saldare un 0402 0R che permette di fare il powerup vi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
435MHz filtro passa banda
RX match AN643 4 elementi (434 MHz)
SWTICH
Match uscita PA (C260-L243-C261/C262-C230): vedi nota di layout L-01 nel log. Copiare il layout EVB Qorvo 410-470MHz, masse dirette, spazio per tarare C260/C262.

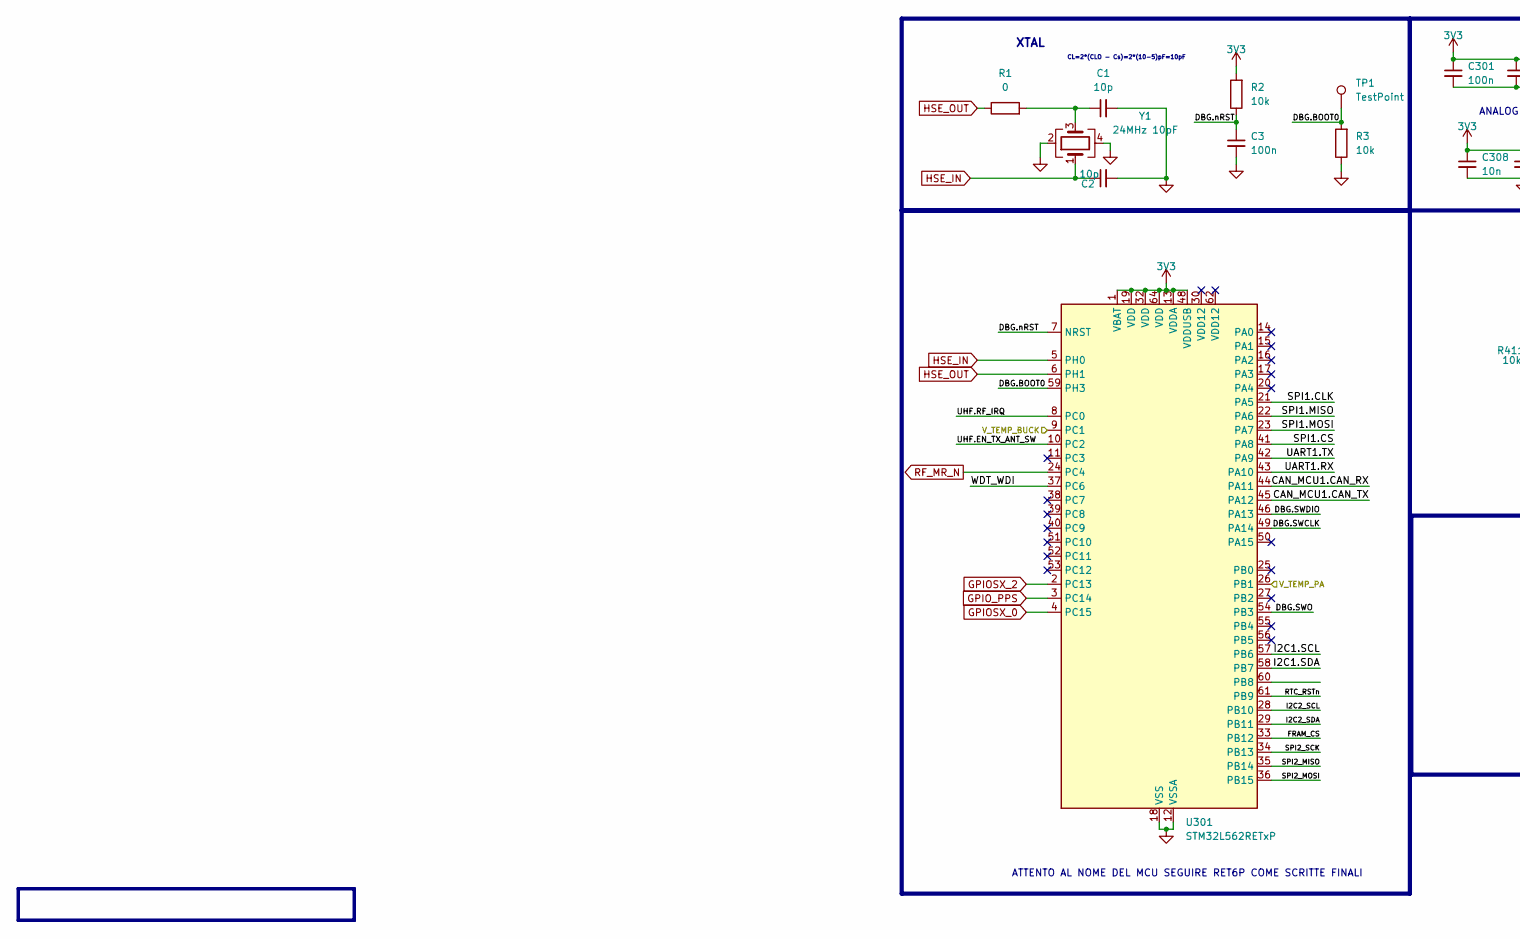
[picture p54: schematic MCU.kicad_sch, SYMPHONY, part in row 1, column 1]

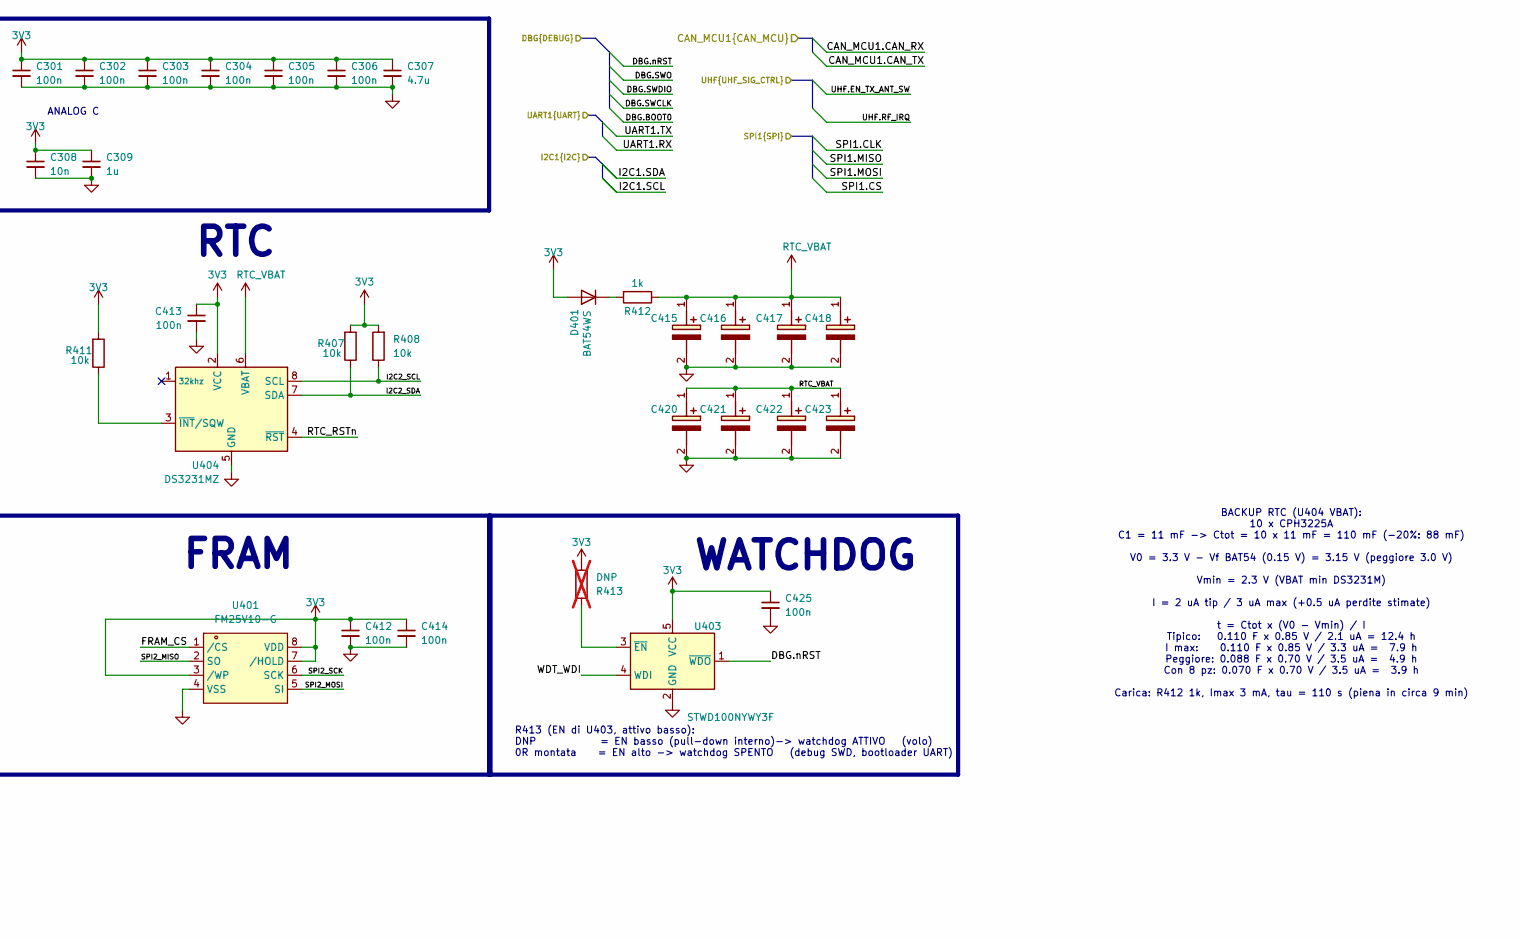
[picture p55: schematic MCU.kicad_sch, SYMPHONY, part in row 1, column 2]

Parts:
C1, C2: 10p; C_0402_1005Metric; JLCPCB Parts C76946
C3, C425: 100n; C_0402_1005Metric; JLCPCB Parts C1525
C301, C302, C303, C304, C305, C306, C412, C413, C414: 100n; C_0402_1005Metric_Pad0.74x0.62mm_HandSolder; JLCPCB Parts C1525
C307: 4.7u; C_0603_1608Metric_Pad1.08x0.95mm_HandSolder; JLCPCB Parts C19666
C308: 10n; C_0402_1005Metric_Pad0.74x0.62mm_HandSolder; JLCPCB Parts C1524
C309: 1u; C_0402_1005Metric_Pad0.74x0.62mm_HandSolder; JLCPCB Parts C14445
C415, C416, C417, C418, C420, C421, C422, C423: CPH3225A; Mouser Part Number 628-CPH3225A
D401: BAT54WS; D_SOD-323; JLCPCB Parts C124205
R1: 0; R_0402_1005Metric_Pad0.72x0.64mm_HandSolder; JLCPCB Parts C17168
R2, R3, R407, R408, R411: 10k; R_0402_1005Metric_Pad0.72x0.64mm_HandSolder; JLCPCB Parts C71617
R412: 1k; R_0402_1005Metric; JLCPCB Parts C11702
R413: DNP; R_0402_1005Metric; JLCPCB Parts C17168; not fitted
TP1: TestPoint; TestPoint_Pad_D1.0mm
U301: STM32L562RETxP; LQFP-64_10x10mm_P0.5mm; JLCPCB Parts C1236664
U401: FM25V10-G; SOIC127P602X173-8N; JLCPCB Parts C44173
U403: STWD100NYWY3F; SOT95P280X145-5N; Manufacturer_Part_Number STWD100NYWY3F; JLCPCB Parts C46043
U404: DS3231MZ; SOIC-8_3.9x4.9mm_P1.27mm; JLCPCB Parts C107410
Y1: 24MHz 10pF; Crystal_SMD_3225-4Pin_3.2x2.5mm; JLCPCB Parts C70583

Connections:
3V3: C301.1, C302.1, C303.1, C304.1, C305.1, C306.1, C307.1, C308.1, C309.1, C412.1, C413.1, C414.1, C425.1, D401.2 (A), R2.2, R407.2, R408.2, R411.2, R413.2, U301.1 (VBAT), U301.13 (VDDA), U301.19 (VDD), U301.32 (VDD), U301.48 (VDDUSB), U301.64 (VDD), U401.3 (/WP), U401.7 (/HOLD), U401.8 (VDD), U403.5 (VCC), U404.2 (VCC); also elsewhere on the board
/IF/CAN_MCU1.CAN_RX: U301.44 (PA11); also elsewhere on the board
/IF/CAN_MCU1.CAN_TX: U301.45 (PA12); also elsewhere on the board
/IF/DBG.BOOT0: R3.2, TP1.1 (1_1), U301.59 (PH3)
/IF/DBG.SWCLK: U301.49 (PA14); also elsewhere on the board
/IF/DBG.SWDIO: U301.46 (PA13); also elsewhere on the board
/IF/DBG.SWO: U301.54 (PB3); also elsewhere on the board
/IF/DBG.nRST: C3.1, R2.1, U301.7 (NRST), U403.1 (~WDO); also elsewhere on the board
/IF/I2C1.SCL: U301.57 (PB6); also elsewhere on the board
/IF/I2C1.SDA: U301.58 (PB7); also elsewhere on the board
/IF/UART1.RX: U301.43 (PA10); also elsewhere on the board
/IF/UART1.TX: U301.42 (PA9); also elsewhere on the board
/MCU/FRAM_CS: U301.33 (PB12), U401.1 (/CS)
/MCU/I2C2_SCL: R408.1, U301.28 (PB10), U404.8 (SCL)
/MCU/I2C2_SDA: R407.1, U301.29 (PB11), U404.7 (SDA)
/MCU/RTC_RSTn: U301.61 (PB9), U404.4 (~RST)
/MCU/SPI1.CLK: U301.21 (PA5); also elsewhere on the board
/MCU/SPI1.CS: U301.41 (PA8); also elsewhere on the board
/MCU/SPI1.MISO: U301.22 (PA6); also elsewhere on the board
/MCU/SPI1.MOSI: U301.23 (PA7); also elsewhere on the board
/MCU/SPI2_MISO: U301.35 (PB14), U401.2 (SO)
/MCU/SPI2_MOSI: U301.36 (PB15), U401.5 (SI)
/MCU/SPI2_SCK: U301.34 (PB13), U401.6 (SCK)
/MCU/UHF.EN_TX_ANT_SW: U301.10 (PC2); also elsewhere on the board
/MCU/UHF.RF_IRQ: U301.8 (PC0); also elsewhere on the board
/MCU/V_TEMP_BUCK: U301.9 (PC1); also elsewhere on the board
/MCU/V_TEMP_PA: U301.26 (PB1); also elsewhere on the board
/MCU/WDT_WDI: U301.37 (PC6), U403.4 (WDI)
GND: C1.2, C2.2, C3.2, C301.2, C302.2, C303.2, C304.2, C305.2, C306.2, C307.2, C308.2, C309.2, C412.2, C413.2, C414.2, C415.2 (-), C416.2 (-), C417.2 (-), C418.2 (-), C420.2 (-), C421.2 (-), C422.2 (-), C423.2 (-), C425.2, R3.1, U301.12 (VSSA), U301.18 (VSS), U301.31 (VSS), U301.47 (VSS), U301.63 (VSS), U401.4 (VSS), U403.2 (GND), U404.5 (GND), Y1.2, Y1.4; also elsewhere on the board
GPIOSX_0: U301.4 (PC15); also elsewhere on the board
GPIOSX_2: U301.2 (PC13); also elsewhere on the board
GPIO_PPS: U301.3 (PC14); also elsewhere on the board
HSE_IN: C2.1, U301.5 (PH0), Y1.1
HSE_OUT: R1.1, U301.6 (PH1)
unnamed: C1.1, R1.2, Y1.3
unnamed: D401.1 (K), R412.2
unnamed: R413.1, U403.3 (~EN)
unnamed: R411.1, U404.3 (~INT/SQW)
RF_MR_N: U301.24 (PC4); also elsewhere on the board
RTC_VBAT: C415.1 (+), C416.1 (+), C417.1 (+), C418.1 (+), C420.1 (+), C421.1 (+), C422.1 (+), C423.1 (+), R412.1, U404.6 (VBAT); also elsewhere on the board

Notes on the sheet:
R413 (EN di U403, attivo basso): DNP = EN basso (pull-down interno)-> watchdog ATTIVO (volo) 0R montata = EN alto -> watchdog SPENTO (debug SWD, bootloader UART)
ATTENTO AL NOME DEL MCU SEGUIRE RET6P COME SCRITTE FINALI
RTC
ANALOG C
FRAM
WATCHDOG
BACKUP RTC (U404 VBAT): 10 x CPH3225A C1 = 11 mF -> Ctot = 10 x 11 mF = 110 mF (-20%: 88 mF) V0 = 3.3 V - Vf BAT54 (0.15 V) = 3.15 V (peggiore 3.0 V) Vmin = 2.3 V (VBAT min DS3231M) I = 2 uA tip / 3 uA max (+0.5 uA perdite stimate) t = Ctot x (V0 - Vmin) / I Tipico: 0.110 F x 0.85 V / 2.1 uA = 12.4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
XTAL
CL=2*(CLO - Cs)=2*(10-5)pF=10pF

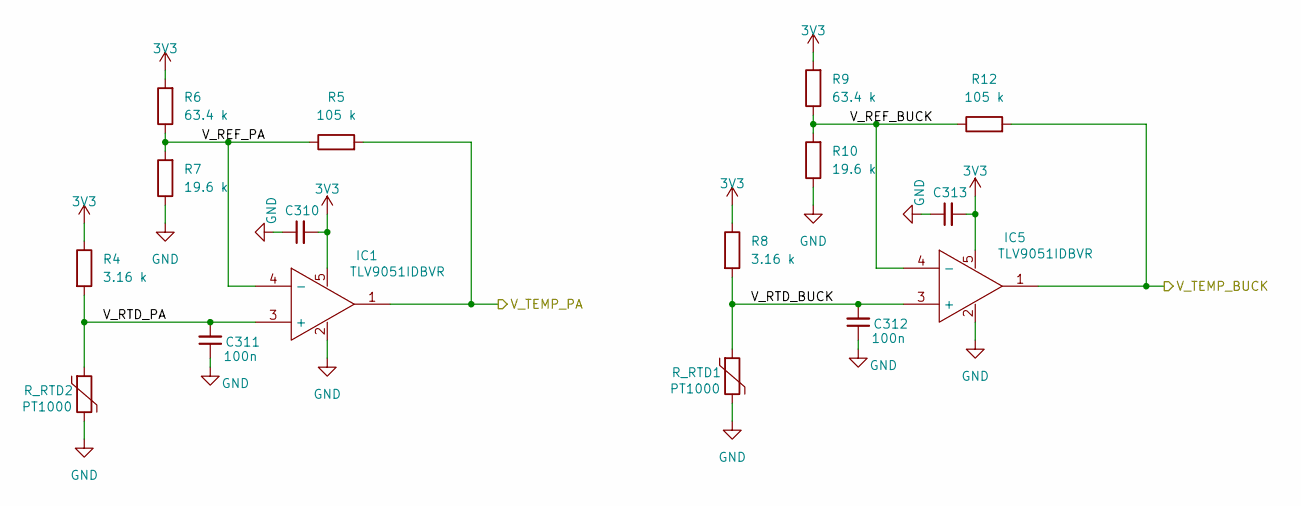
[picture p56: schematic CONNECTORS.kicad_sch, SYMPHONY]

Parts:
C310, C311, C312, C313: 100n; C_0402_1005Metric_Pad0.74x0.62mm_HandSolder; JLCPCB Parts C1525
IC1, IC5: TLV9051IDBVR; SOT95P280X145-5N; Mouser Part Number 595-TLV9051IDBVR
R4, R8: 3.16 k; R_0402_1005Metric_Pad0.72x0.64mm_HandSolder; JLCPCB Parts C852759
R5, R12: 105 k; R_0402_1005Metric_Pad0.72x0.64mm_HandSolder; JLCPCB Parts C2984407
R6, R9: 63.4 k; R_0402_1005Metric_Pad0.72x0.64mm_HandSolder; JLCPCB Parts C852877
R7, R10: 19.6 k; R_0402_1005Metric_Pad0.72x0.64mm_HandSolder; JLCPCB Parts C852589
R_RTD1, R_RTD2: PT1000; R_0603_1608Metric_Pad0.98x0.95mm_HandSolder; MPN 32207638

Connections:
3V3: C310.2, C313.2, IC1.5, IC5.5, R4.1, R6.2, R8.1, R9.2; also elsewhere on the board
/MCU/V_TEMP_BUCK: IC5.1, R12.2; also elsewhere on the board
/MCU/V_TEMP_PA: IC1.1, R5.2; also elsewhere on the board
/SENSORS/V_REF_BUCK: IC5.4 (-), R9.1, R10.2, R12.1
/SENSORS/V_REF_PA: IC1.4 (-), R5.1, R6.1, R7.2
/SENSORS/V_RTD_BUCK: C312.2, IC5.3 (+), R8.2, R_RTD1.1
/SENSORS/V_RTD_PA: C311.2, IC1.3 (+), R4.2, R_RTD2.1
GND: C310.1, C311.1, C312.1, C313.1, IC1.2, IC5.2, R7.1, R10.1, R_RTD1.2, R_RTD2.2; also elsewhere on the board

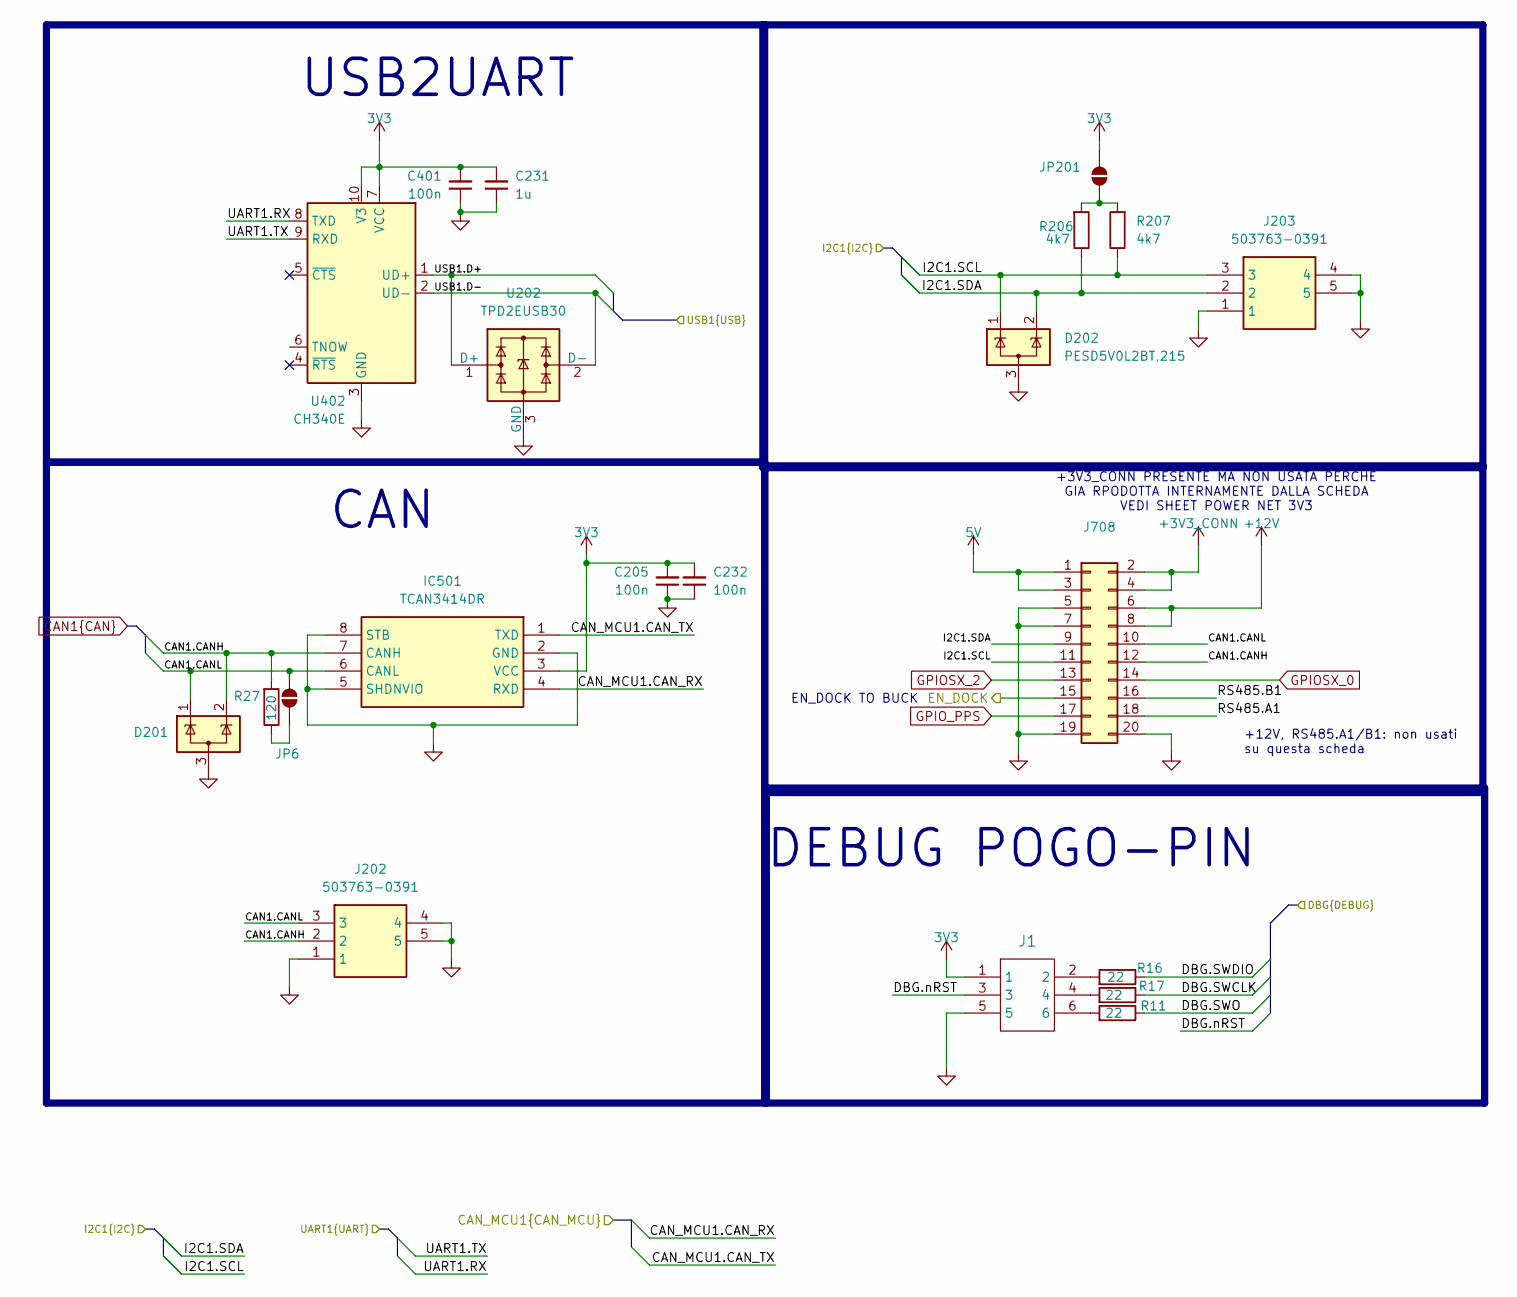
[picture p57: schematic IF.kicad_sch, SYMPHONY]

Parts:
C205, C232, C401: 100n; C_0402_1005Metric; JLCPCB Parts C1525
C231: 1u; C_0402_1005Metric; JLCPCB Parts C29266
D201: ESD2CAN24DBZRQ1; SOT-23-3; JLCPCB Parts C5736151
D202: PESD5V0L2BT,215; SOT-23-3; JLCPCB Parts C12324
IC501: TCAN3414DR; SOIC127P600X175-8N; Mouser Part Number 595-TCAN3414DR
J1: TC2030-IDC-pogo-pin; CONN_TC2030-IDC_TGC
J202, J203: 503763-0391; 5037630391; Mouser Part Number 538-503763-0391
J708: FSI-110-03-G-D-AB; FSI11003GDAB_Mating; JLCPCB Parts C7278162
JP6, JP201: SolderJumper_2_Open; SolderJumper-2_P1.3mm_Open_RoundedPad1.0x1.5mm
R11, R16, R17: 22; R_0402_1005Metric_Pad0.72x0.64mm_HandSolder; JLCPCB Parts C25092
R27: 120; R_0805_2012Metric; JLCPCB Parts C17437
R206, R207: 4k7; R_0402_1005Metric_Pad0.72x0.64mm_HandSolder; JLCPCB Parts C25900
U202: TPD2EUSB30; Texas_DRT-3; JLCPCB Parts C97502
U402: CH340E; MSOP-10_3x3mm_P0.5mm; JLCPCB Parts C99652

Connections:
3V3: C205.2, C231.2, C232.2, C401.2, IC501.3 (VCC), J1.1, JP201.2 (B), U402.7 (VCC), U402.10 (V3); also elsewhere on the board
5V: J708.1, J708.3; also elsewhere on the board
+3V3_CONN: J708.2, J708.4
+12V: J708.6, J708.8
/IF/CAN_MCU1.CAN_RX: IC501.4 (RXD); also elsewhere on the board
/IF/CAN_MCU1.CAN_TX: IC501.1 (TXD); also elsewhere on the board
/IF/DBG.SWCLK: R17.1; also elsewhere on the board
/IF/DBG.SWDIO: R16.1; also elsewhere on the board
/IF/DBG.SWO: R11.1; also elsewhere on the board
/IF/DBG.nRST: J1.3; also elsewhere on the board
/IF/EN_DOCK: J708.15; also elsewhere on the board
/IF/I2C1.SCL: D202.1 (K), J203.3, J708.11, R207.1; also elsewhere on the board
/IF/I2C1.SDA: D202.2 (K), J203.2, J708.9, R206.1; also elsewhere on the board
/IF/RS485.A1: J708.18
/IF/RS485.B1: J708.16
/IF/UART1.RX: U402.8 (TXD); also elsewhere on the board
/IF/UART1.TX: U402.9 (RXD); also elsewhere on the board
/IF/USB1.D+: U202.1 (D+), U402.1 (UD+); also elsewhere on the board
/IF/USB1.D-: U202.2 (D-), U402.2 (UD-); also elsewhere on the board
CAN1.CANH: D201.2 (K), IC501.7 (CANH), J202.2, J708.12, R27.2
CAN1.CANL: D201.1 (K), IC501.6 (CANL), J202.3, J708.10, JP6.2 (B)
GND: C205.1, C231.1, C232.1, C401.1, D201.3 (A), D202.3 (A), IC501.2 (GND), IC501.5 (SHDNVIO), IC501.8 (STB), J1.5, J202.1, J202.4, J202.5, J203.1, J203.4, J203.5, J708.5, J708.7, J708.19, J708.20, U202.3 (GND), U402.3 (GND); also elsewhere on the board
GPIOSX_0: J708.14; also elsewhere on the board
GPIOSX_2: J708.13; also elsewhere on the board
GPIO_PPS: J708.17; also elsewhere on the board
unnamed: J1.2, R16.2
unnamed: J1.4, R17.2
unnamed: J1.6, R11.2
unnamed: JP6.1 (A), R27.1
unnamed: JP201.1 (A), R206.2, R207.2

Notes on the sheet:
EN_DOCK TO BUCK
USB2UART
+3V3_CONN PRESENTE MA NON USATA PERCHE GIA RPODOTTA INTERNAMENTE DALLA SCHEDA VEDI SHEET POWER NET 3V3
CAN
DEBUG POGO-PIN
+12V, RS485.A1/B1: non usati su questa scheda

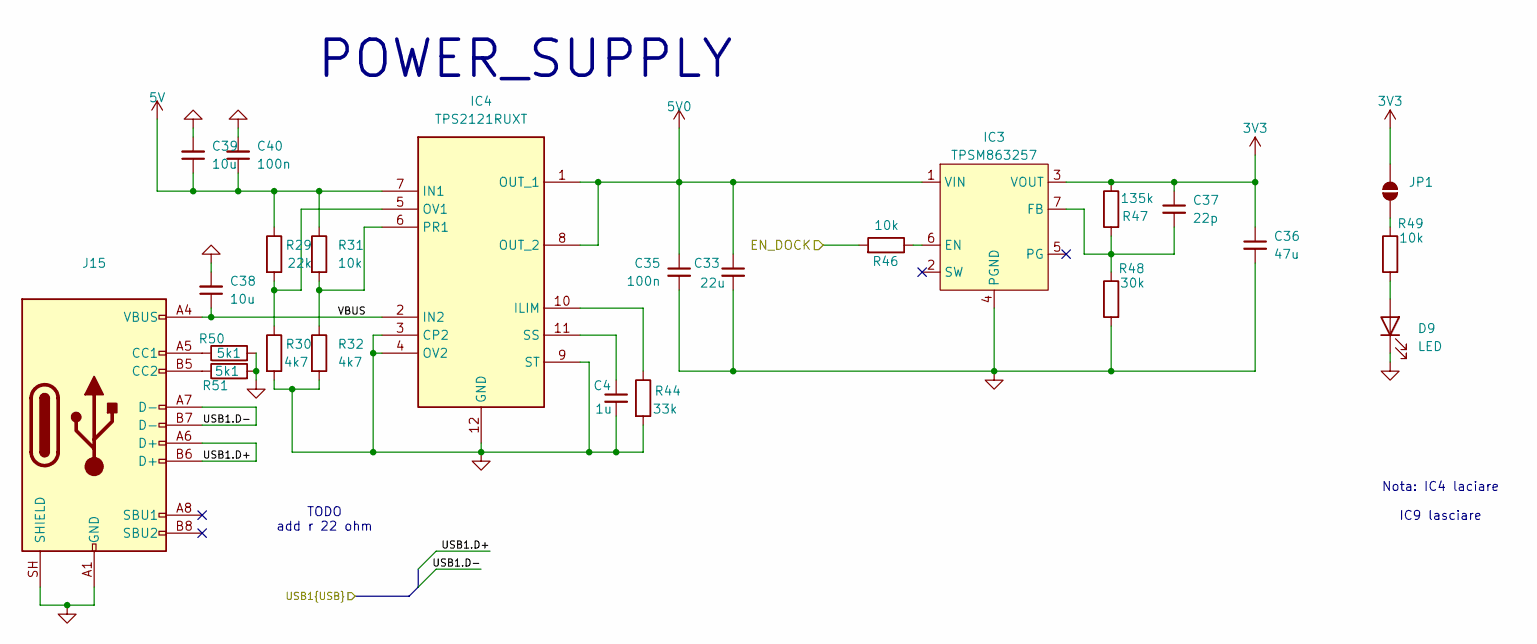
[picture p58: schematic POWER.kicad_sch, SYMPHONY]

Parts:
C4: 1u; C_0603_1608Metric; JLCPCB Parts C29936
C33: 22u; C_0805_2012Metric; JLCPCB Parts C45783
C35, C40: 100n; C_0402_1005Metric; JLCPCB Parts C1525
C36: 47u; C_1210_3225Metric; JLCPCB Parts C84494
C37: 22p; C_0402_1005Metric_Pad0.74x0.62mm_HandSolder; JLCPCB Parts C2191676
C38: 10u; C_0805_2012Metric; JLCPCB Parts C15850
C39: 10u; C_0402_1005Metric; JLCPCB Parts C315248
D9: LED; LED_0402_1005Metric; JLCPCB Parts C130723
IC3: TPSM863257; JLCPCB Parts C19190416
IC4: TPS2121RUXT; Mouser Part Number 595-TPS2121RUXT
J15: USB_C_Receptacle_USB2.0_16P; USB_C_Receptacle_GCT_USB4105-xx-A_16P_TopMnt_Horizontal; JLCPCB Parts C393939
JP1: SolderJumper_2_Open; SolderJumper-2_P1.3mm_Open_RoundedPad1.0x1.5mm
R29: 22k; R_0402_1005Metric; JLCPCB Parts C25547
R30, R32: 4k7; R_0402_1005Metric; JLCPCB Parts C25900
R31: 10k; R_0402_1005Metric; JLCPCB Parts C71617
R44: 33k; R_0402_1005Metric; JLCPCB Parts C25779
R46, R49: 10k; R_0402_1005Metric_Pad0.72x0.64mm_HandSolder; JLCPCB Parts C71617
R47: 135k; R_0402_1005Metric_Pad0.72x0.64mm_HandSolder; JLCPCB Parts C2515705
R48: 30k; R_0402_1005Metric_Pad0.72x0.64mm_HandSolder; JLCPCB Parts C100362
R50, R51: 5k1; R_0402_1005Metric; JLCPCB Parts C25905

Connections:
3V3: C36.1, C37.1, IC3.3 (VOUT), JP1.2 (B), R47.1; also elsewhere on the board
5V: C39.1, C40.1, IC4.7 (IN1), R29.1, R31.1; also elsewhere on the board
5V0: C33.1, C35.1, IC3.1 (VIN), IC4.1 (OUT_1), IC4.8 (OUT_2); also elsewhere on the board
/IF/EN_DOCK: R46.2; also elsewhere on the board
/IF/USB1.D+: J15.A6 (D+), J15.B6 (D+); also elsewhere on the board
/IF/USB1.D-: J15.A7 (D-), J15.B7 (D-); also elsewhere on the board
/POWER/VBUS: C38.1, IC4.2 (IN2), J15.A4 (VBUS), J15.A9 (VBUS), J15.B4 (VBUS), J15.B9 (VBUS)
GND: C4.2, C33.2, C35.2, C36.2, C38.2, C39.2, C40.2, D9.1 (K), IC3.4 (PGND), IC4.3 (CP2), IC4.4 (OV2), IC4.9 (ST), IC4.12 (GND), J15.A1 (GND), J15.A12 (GND), J15.B1 (GND), J15.B12 (GND), J15.SH (SHIELD), R30.2, R32.2, R44.2, R48.2, R50.2, R51.2; also elsewhere on the board
unnamed: D9.2 (A), R49.2
unnamed: IC3.6 (EN), R46.1
unnamed: C37.2, IC3.7 (FB), R47.2, R48.1
unnamed: IC4.10 (ILIM), R44.1
unnamed: IC4.5 (OV1), R29.2, R30.1
unnamed: IC4.6 (PR1), R31.2, R32.1
unnamed: C4.1, IC4.11 (SS)
unnamed: J15.A5 (CC1), R50.1
unnamed: J15.B5 (CC2), R51.1
unnamed: JP1.1 (A), R49.1

Notes on the sheet:
TODO add r 22 ohm
POWER_SUPPLY
Nota: IC4 laciare IC9 lasciare
