Brik81/SYMPHONY_BRIDGE/SYMPHONY_V2/DESIGN/SYMPHONY_V2_CLAUDE_PCB/SYMPHONY.kicad_pcb

## KiCad design SYMPHONY_V2/DESIGN/SYMPHONY_V2_CLAUDE_PCB/SYMPHONY.kicad_pcb (continued)

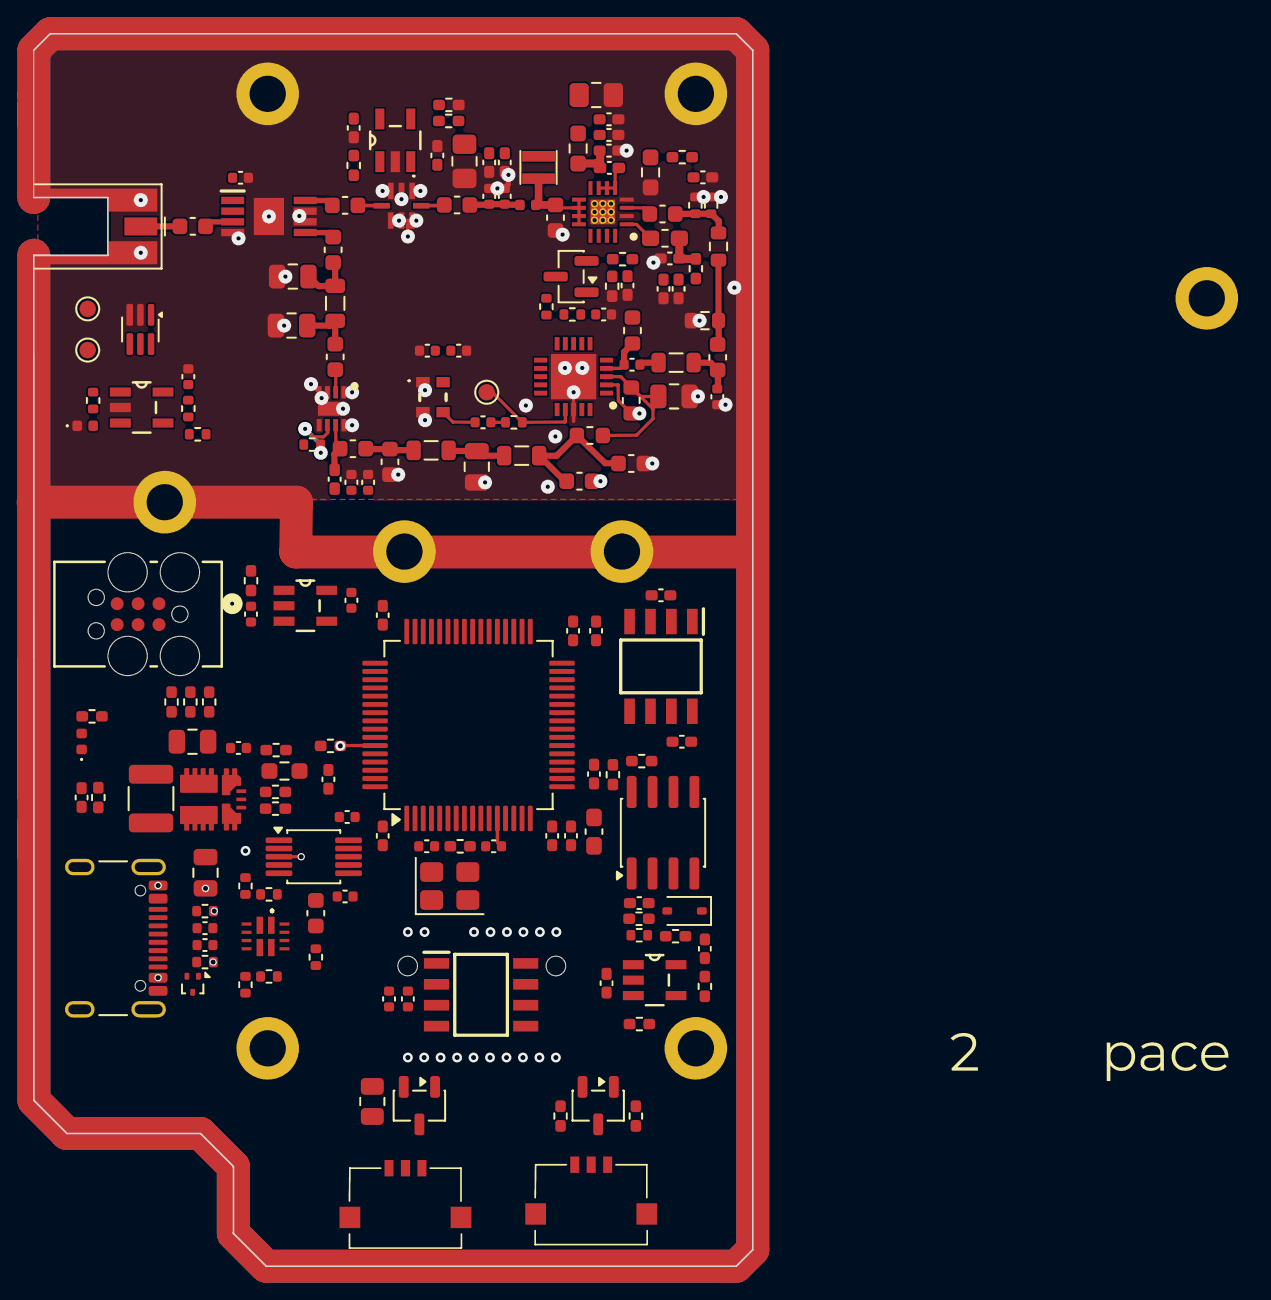
[picture p59: board SYMPHONY.kicad_pcb from above]

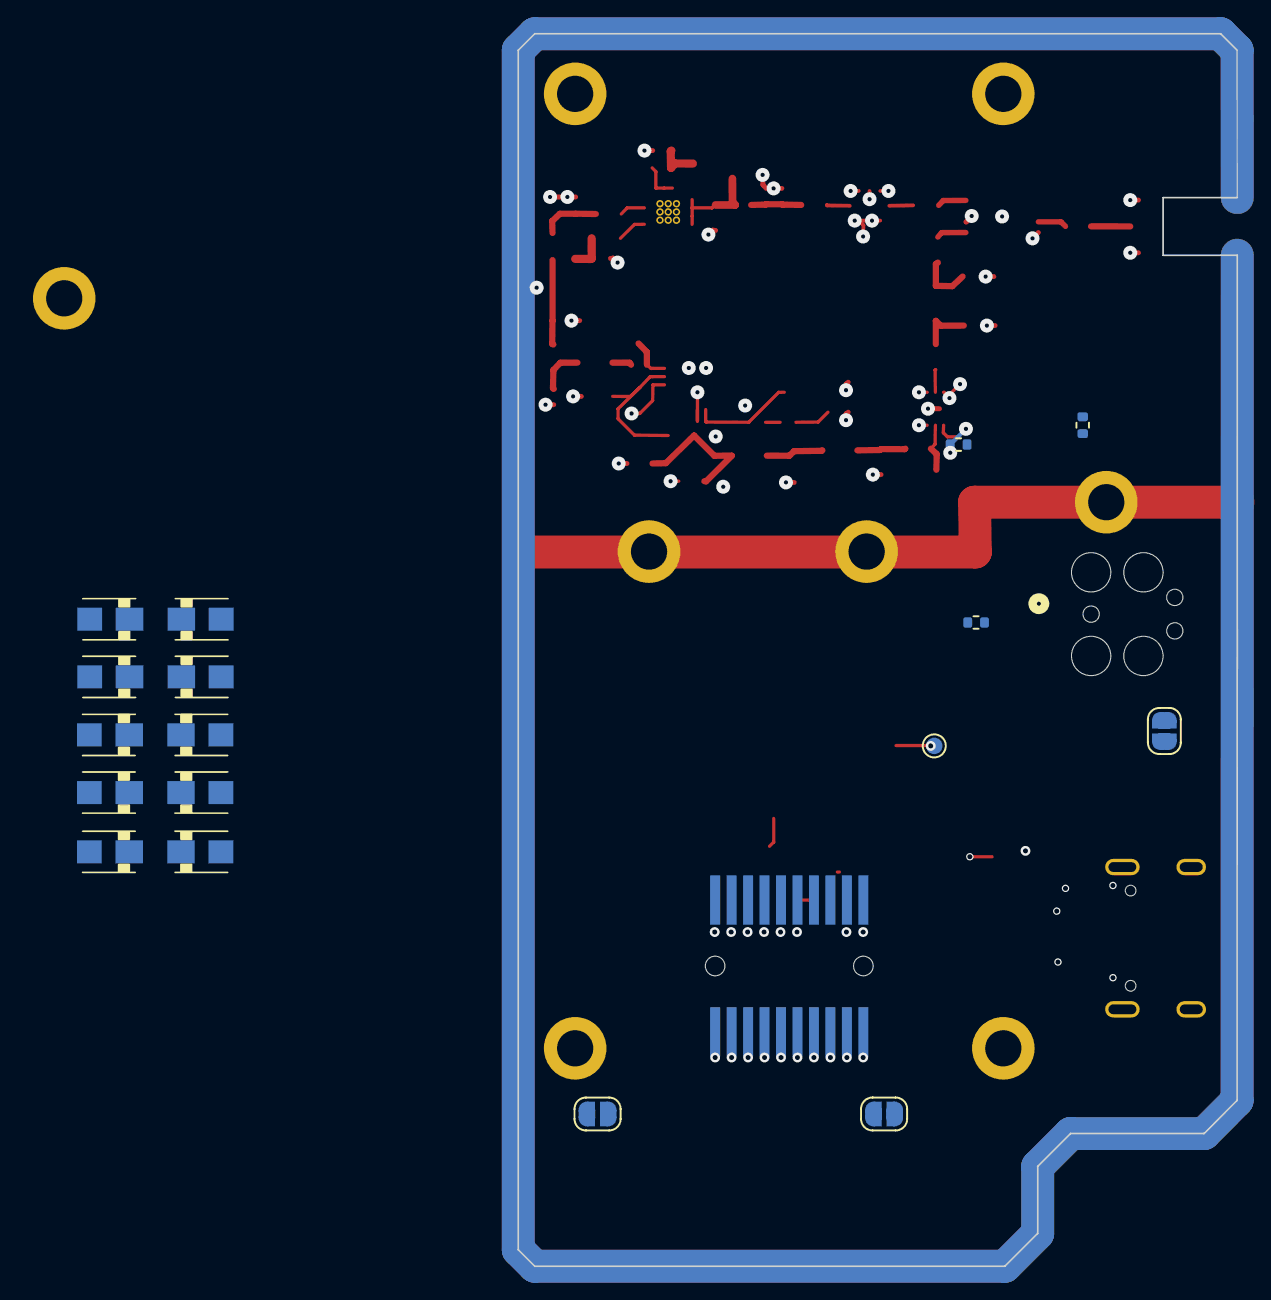
[picture p60: board SYMPHONY.kicad_pcb from below]

Board: 8 copper layers, 43.7 x 74.8 mm, 193 parts (18 on the bottom side), 108 nets.

Other parts of the board:
C419, C424: CPH3225A

Their connections:
GND: C419.2 (-), C424.2 (-); also elsewhere on the board
RTC_VBAT: C419.1 (+), C424.1 (+); also elsewhere on the board
