Brik81/SYMPHONY_BRIDGE/(commit log)

2026-11-06 Checkpoint pre-ripristino: MCU senza R409/R410 (rev 1.45), salvataggio git automatico
    - MCU.kicad_sch: rimosse R409/R410 (pull-up DS3231M), pin 32kHz di U404 non connesso
    - SYMPHONY.kicad_pro: salvato da KiCad
    - tools/git_check.ps1, .claude/ (hook di stop, agente git-guardian, skill /salva)
    - .gitignore: esclusi .history/, lock KiCad, intermedi LaTeX
2026-11-06 Ripristino documentazione persa il 05/11: manuale firmware, guida layout RF, log rev 1.45
    - docs/firmware_manual: manuale per il firmwarista (43 pagine), capitoli dalla vecchia cartella,
    fix \rowcolors del frontespizio che rompeva lo schema a blocchi
    - docs/layout_rf: guida al layout RF (25 pagine), ricostruita dalle trascrizioni del 04/11
    - report: entry 042 (rev 1.44) e 043 (rev 1.45), simphony_v2_log.tex/pdf e chk.pdf ricompilati
2026-11-06 Ripristino schematico e PCB del 04/11 (perdita del 05/11) + PC13-15 su J708
    - Fogli .kicad_sch dalla local history KiCad del 04/11 17:29 (MCU 15:19): rev 1.45 completa
    (R409/R410 rimosse, R243 220R C25091, R29 C25768, note POWER cancellate, nota L-01 su UHF)
    + fori H305-H308 su GND aggiunti da Brik81 all'inizio del layout
    - MCU: U301 PC13->GPIOSX_2 (J708.13), PC14->GPIO_PPS (J708.17), PC15->GPIOSX_0 (J708.14),
    rifatto come la modifica del 04/11 15:22 andata persa; ERC -6 messaggi, nessuno nuovo
    - SYMPHONY.kicad_pcb: stato del 04/11 17:27 (194 footprint, piazzamento iniziato, nessuna pista)
2026-11-06 Netclass RF in SYMPHONY.kicad_pro (guida layout RF, sez. Netclass da creare)
    - RF_50R 0.20/0.20 mm, via 0.6/0.3: 20 reti /UHF/RF_* della catena RF (CPWG 50 ohm su PP 3313)
    - RF_DIFF 0.20 mm gap 0.20: RF_RX_P/N
    - RF_PA_OUT 1.0/0.25 mm, via 0.8/0.4: RF_PA_OUT (tratto pin-C260-L243 a mano, larghezze EVB)
    - RF_CLK 0.20/0.30 mm: RF_TCXO_OUT, RF_TCXO_AC, RF_XIN
    - PA_BIAS 0.50/0.20 mm, via 0.8/0.4: PA_VCC1(_F), PA_VCC2(_F)
    - PWR 0.50/0.20 mm, via 0.8/0.4: 3V3, 5V0
    32 pattern a nome esatto (niente /UHF/RF_* per non prendere RF_SDN); verificato con la netlist.
2026-11-06 Ripristino originali da OneDrive\Documenti (spostati da OneDrive il 05/11 16:14)
    I file non erano persi: OneDrive ha spostato Documents in "OneDrive - 2NDSPACE\Documenti".
    - MCU.kicad_sch originale (04/11 17:05): stessa netlist della ricostruzione (PC13-15 su J708)
    + R413 valore DNP
    - SYMPHONY.kicad_pcb originale (04/11 17:29, ultimo salvataggio)
    - SYMPHONY.kicad_dru: regole ECSS-Q-ST-70-12C Rev.1 + JLCPCB (= ECSS_JLC_4L.kicad_dru)
    - SYMPHONY.kicad_pro originale (regole minime di scheda ECSS/JLC) + netclass RF riapplicate
    - docs: bom.csv, net.xml, comps.tsv, nets.txt
    Documenti e log ricostruiti verificati identici agli originali.
2026-11-06 Netclass RF_50R -> RF_50R_CPWG, allineata alle regole RF del .kicad_dru ECSS/JLC
    - .kicad_pro: RF_50R rinominata RF_50R_CPWG (20 reti), clearance 0.20 -> 0.25 come la regola
    "RF CPWG gap 0.25" del .kicad_dru; pista lasciata a 0.20 (guida layout RF)
    - .kicad_dru: regola "RF CPWG gap 0.25" limitata alle piste (A.Type == 'Track'); prima segnalava
    17 falsi errori tra pad interni di FL201, IC202, Q201 (passo fisso del package)
    - Ora attive anche "RF vietata su layer interni" e "RF edge launch". DRC: 243 violazioni (come prima
    della rinomina), nessuna da regole RF.
2026-11-06 update pcb from sch
2026-11-06 Manuale firmware v1.1: figure rifatte e tabelle spiegate (feedback firmwarista)
    - Schema a blocchi diviso in 3 figure (MCU e periferiche, catena RF,
    alimentazione) con i nomi delle periferiche (FDCAN1, SPI1, USART1...)
    al posto dei pin, griglia ordinata, nessuna sovrapposizione
    - Fig. 3.1 accensione ridisegnata (larghezza corretta, etichette negli spazi)
    - Fig. 6.1 circuito di PC2 ridisegnato a zone senza incroci
    - Fig. 6.2/6.3: etichette degli eventi sopra il bordo, didascalie esplicative
    - Nota "come leggere" per ogni tabella (pin map, verita RF, SDN, limiti,
    collaudo, watchdog, registri DS3231M, note F-xx, appendici)
    - Riquadro "In parole semplici", convenzioni e codici del log spie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
2026-11-06 PCB: avanzamento placement (spostati footprint tra cui R206/R207, JP6, FL201, D202, C425)
    Lavoro di layout di Brik81 in KiCad, salvato dal controllo automatico.
2026-11-06 Documento piazzamento foglio UHF: figure in scala dal PCB, orientamento chip, ordine e distanze
    docs/layout_rf/piazzamento_uhf: PDF di 9 pagine in italiano con la scheda e la zona RF in scala, la disposizione proposta (blocchi e IC con pad reali), la rotazione di IC202/IC204/IC2/Q201/FL201/Y201 con le coordinate, l'ordine di piazzamento, le distanze rispettate e non, e le alternative. Figure generate da gen.py (dati letti con extract.py da SYMPHONY.kicad_pcb).
2026-11-06 Documento piazzamento UHF v1.1: altezza minima della striscia RF, come piazzare ogni blocco, rotazione MCU a passi di 35 gradi
    Nuovo paragrafo 2.2: altezza della striscia RF in funzione della posizione dei fori H305-H307 (29 mm con TCXO su B.Cu, 31 mm altrimenti). Nuovo capitolo 6: regole generali con esempi giusto/sbagliato e disegno di pad, piste e via di ogni blocco RF secondo la netlist (blocks.py). Nuovo capitolo 9: rotazione di U301 da 0 a 350 gradi a passi di 35 (mcu_rot.py): migliore 140, consigliata 135. Aggiornato il paragrafo sui componenti ancora fuori scheda.
2026-11-06 PCB: avanzamento placement UHF (IC2 sulla scheda a 180 gradi, IC204 e filtro RX spostati)
    Lavoro di piazzamento di Brik81: IC2 (PA) portato nella zona RF a X 135,3 Y 79,8 rot 180; IC204 a Y 93,6; C207, C209, C210, C212, C230, L201, C208 riposizionati intorno allo switch.
2026-11-06 Documento piazzamento UHF: rotazione MCU rifatta a passi di 45 gradi
    mcu_rot.py con STEP=45 sul PCB attuale (U301 oggi a 0 gradi). Risultato: 135 gradi migliore (5 incroci, 338 mm), 180 il piu corto (314 mm, 9 incroci), 0 il peggiore (56 incroci). Figura, tabella e testo del capitolo 9 aggiornati.
2026-11-06 PCB: U301 ruotato a 0 gradi (lavoro di placement in corso)
    Modifica di Brik81 sul placement dell'MCU; secondo l'analisi del documento di piazzamento la rotazione consigliata e' 135 gradi.
2026-11-06 UPDATE PCB
2026-11-10 Copia CLAUDE_PCB con sbroglio RF, backup originale, log 044-045
    - SYMPHONY_V2_CLAUDE_PCB: copia del progetto con correzioni di piazzamento
    (L206, C220, L205, C218, C36, U202) e sbroglio della sola sezione RF:
    CPWG 0.38 mm su top, stripline 0.17 mm su In2, via 0.85/0.25,
    GND su F.Cu (area RF), In1 e In3. Report PDF in report/.
    - SYMPHONY_V2_BACKUP_ORIGINALE_10_11: copia del lavoro originale.
    - Log: voci 044 e 045 sul backup di alimentazione.
    Claude-Session: https://claude.ai/code/session_01Tci8GVpHYn6LDr5FiwRBzh
