Brik81/SYMPHONY_BRIDGE/(notices)

Notices in the files:
SYMPHONY_V2/DESIGN/SYMPHONY_V2/UHF_LIB/3D/MEM2061-01-188-00-A.stp:
author */ ('License CC BY-ND 4.0'),
